sylvandb/gruvin9x/doc/spkr-install.jpg

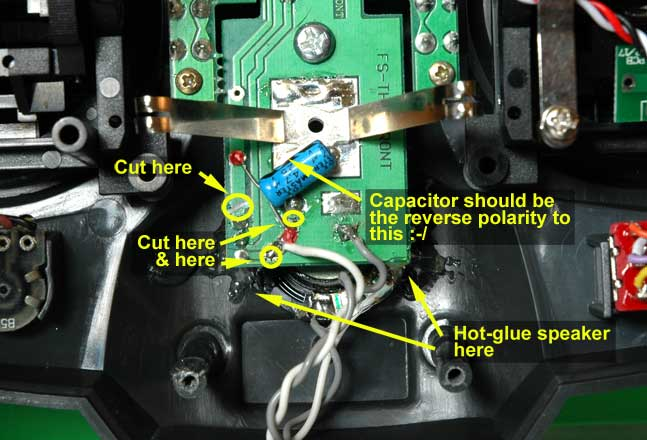
doc/spkr-install.jpg
