sylvandb/gruvin9x/hardware/pcb/README

Please see *-readme.txt files (to accommodate Windows users being able to open them more easily.)
