sylvandb/gruvin9x/hardware/pcb/gruvin9x-bom-ele14.xls

nz.element14.com 'next day delivery' cheapest pricing BOM
v4.2 Main and RTC/SD-card Boards |  |  |  | as at 2012-04-17
 |  |  |  | Farnell UK |  |  |  |  | Pricing |  | significant | Pricing for 10 units
Farnell Part No. | Price Ea. | MOQ | Qty | Manufacturer Name | Mfr Part No. | Description | Value | Footprint | Raw Amount | MOQ Amount | MOQ impact | Raw Amount | MOQ Amount
MAIN BOARD V4.1
1710190 (http://nz.element14.com/multicomp/mc0603n180k500ct/capacitor-ceramic-18pf-50v-c0g/dp/1710190) | 0.03 | 1 | 2 | Multicomp | MC0603N180K500CT | Capacitor ceramic | 18pF | SM0603 | 0.06 | 0.06 |  | 0.60 | 0.60
1709957 (http://nz.element14.com/multicomp/mc0603b104m250ct/capacitor-ceramic-0-1uf-25v-x7r/dp/1709957) | 0.03 | 1 | 51 | Multicomp | MC0603B104M250CT | Capacitor ceramic | 0.1uF 25V | SM0603 | 1.53 | 1.53 |  | 15.30 | 15.30
1710292 (http://nz.element14.com/multicomp/mc0603x105m160ct/capacitor-ceramic-1uf-16v-x5r-0603/dp/1710292) | 0.057 | 1 | 11 | Multicomp | MC0603X105M160CT | Capacitor ceramic | 1uF 16V | SM0603 | 0.63 | 0.63 |  | 6.27 | 6.27
1759445 (http://nz.element14.com/multicomp/mcca000564/mlcc-12065v-16v-10uf/dp/1759445) | 0.156 | 10 | 4 | Multicomp | MCCA000564 | Capacitor ceramic | 10uF 16V | SM1206 | 0.62 | 1.56 |  | 6.24 | 6.24
1844348 (http://nz.element14.com/tdk/c3225x5r1c226k/capacitor-ceramic-22uf-16v-x5r/dp/1844348) | 1.18 | 1 | 1 | TDK | C3225X5R1C226K | Capacitor ceramic | 22uF 16V | SM1210 | 1.18 | 1.18 |  | 11.80 | 11.80
1432351 (http://nz.element14.com/avx/taja476k006rnj/capacitor-case-a-47uf-6-3v/dp/1432351) | 0.396 | 1 | 4 | AVX | TAJA476K006RNJ | Capacitor tant | 47uF 6.3V | SM1206 | 1.58 | 1.58 |  | 15.84 | 15.84
1692453 (http://nz.element14.com/multicomp/mc0603wg00000t5e-tr/resistor-0603-0-063w-0r/dp/1692453) | 0.01 | 50 | 4 | Multicomp | MC0603WG00000T5E-TR | Resistor | 0R | SM0603 | 0.04 | 0.50 |  | 0.40 | 0.50
9331484 (http://nz.element14.com/multicomp/mc-0-063w-0603-1-68r/resistor-0603-68r/dp/9331484) | 0.01 | 50 | 2 | Multicomp | MC 0.063W 0603 1% 68R | Resistor | 68R | SM0603 | 0.02 | 0.50 |  | 0.20 | 0.50
9330364 (http://nz.element14.com/multicomp/mc-0-063w-0603-1-100r/resistor-0603-100r-0-063w-1/dp/9330364) | 0.01 | 50 | 2 | Multicomp | MC 0.063W 0603 1% 100R | Resistor | 100R | SM0603 | 0.02 | 0.50 |  | 0.20 | 0.50
9330755 (http://nz.element14.com/multicomp/mc-0-063w-0603-1-200r/resistor-0603-200r/dp/9330755) | 0.01 | 50 | 40 | Multicomp | MC 0.063W 0603 1% 200R | Resistor | 200R | SM0603 | 0.40 | 0.50 |  | 4.00 | 4.00
9330380 (http://nz.element14.com/multicomp/mc-0-063w-0603-1-1k/resistor-0603-1k-0-063-1/dp/9330380) | 0.01 | 50 | 5 | Multicomp | MC 0.063W 0603 1% 1K | Resistor | 1K | SM0603 | 0.05 | 0.50 |  | 0.50 | 0.50
9330607 (http://nz.element14.com/multicomp/mc-0-063w-0603-1-1k5/resistor-0603-1k5/dp/9330607) | 0.01 | 50 | 1 | Multicomp | MC 0.063W 0603 1% 1K5 | Resistor | 1K5 | SM0603 | 0.01 | 0.50 |  | 0.10 | 0.50
9330925 (http://nz.element14.com/multicomp/mc-0-063w-0603-1-2k7/resistor-0603-2k7/dp/9330925) | 0.01 | 50 | 1 | Multicomp | MC 0.063W 0603 1% 2K7 | Resistor | 2K7 | SM0603 | 0.01 | 0.50 |  | 0.10 | 0.50
9331301 (http://nz.element14.com/multicomp/mc-0-063w-0603-1-5k1/resistor-0603-5k1/dp/9331301) | 0.01 | 50 | 31 | Multicomp | MC 0.063W 0603 1% 5K1 | Resistor | 5K1 | SM0603 | 0.31 | 0.50 |  | 3.10 | 3.10
9330399 (http://nz.element14.com/multicomp/mc-0-063w-0603-1-10k/resistor-0603-10k-0-063w-1/dp/9330399) | 0.01 | 50 | 15 | Multicomp | MC 0.063W 0603 1% 10K | Resistor | 10K | SM0603 | 0.15 | 0.50 |  | 1.50 | 1.50
1170889 (http://nz.element14.com/multicomp/mc-0-063w-0603-1-10k2/resistor-0603-10k2/dp/1170889) | 0.01 | 50 | 3 | Multicomp | MC 0.063W 0603 1% 10K2 | Resistor | 10K2 | SM0603 | 0.03 | 0.50 |  | 0.30 | 0.50
9330402 (http://nz.element14.com/multicomp/mc-0-063w-0603-1-100k/resistor-0603-100k-0-063w-1/dp/9330402) | 0.01 | 50 | 5 | Multicomp | MC 0.063W 0603 1% 100K | Resistor | 100K | SM0603 | 0.05 | 0.50 |  | 0.50 | 0.50
9330623 (http://nz.element14.com/multicomp/mc-0-063w-0603-1-150k/resistor-0603-150k/dp/9330623) | 0.01 | 50 | 2 | Multicomp | MC 0.063W 0603 1% 150K | Resistor | 150K | SM0603 | 0.02 | 0.50 |  | 0.20 | 0.50
9330739 (http://nz.element14.com/multicomp/mc-0-063w-0603-1-180k/resistor-0603-180k/dp/9330739) | 0.01 | 50 | 1 | Multicomp | MC 0.063W 0603 1% 180K | Resistor | 180K | SM0603 | 0.01 | 0.50 |  | 0.10 | 0.50
1081244 (http://nz.element14.com/nxp/bc857/transistor-pnp-sot-23/dp/1081244?Ntt=1081244) | 0.091 | 10 | 1 | NXP | BC857C | Transistor | PNP gen. purp. switch | SOT-23 | 0.09 | 0.91 |  | 0.91 | 0.91
1081235 (http://nz.element14.com/nxp/bc847c/transistor-npn-sot-23-45v/dp/1081235) | 0.1 | 10 | 7 | NXP | BC847C | Transistor | NPN gen. purp. switch. | SOT-23 | 0.70 | 1.00 |  | 7.00 | 7.00
1456534 (http://nz.element14.com/bourns/cd0603-b00340/diode-schottky-30ma-45v-603/dp/1456534?Ntt=1456534) | 0.45 | 1 | 3 | BOURNS | CD0603-B00340 | Diode | Schottky 30mA | SM0603 | 1.35 | 1.35 |  | 13.50 | 13.50
1456535 (http://nz.element14.com/bourns/cd0603-s01575/diode-signal-150ma-100v-603/dp/1456535) | 0.149 | 1 | 1 | BOURNS | CD0603-S0180 | Diode | Silicone signal (150mA) | SM0603 | 0.15 | 0.15 |  | 1.49 | 1.49
8735654 (http://nz.element14.com/nxp/bzx384-c3v6/diode-zener-3-6v-5-sod-323/dp/8735654) | 0.174 | 10 | 2 | NXP | BZX384-C3V6 | Diode | Zener 3.6v | SOD323 | 0.35 | 1.74 | 1.39 | 3.48 | 3.48
8735735 (http://nz.element14.com/nxp/bzx384-c5v1/diode-zener-5-1v-5-sod-323/dp/8735735) | 0.174 | 10 | 1 | NXP | BZX384-C5V1 | Diode | Zener 5.1v | SOD523 | 0.17 | 1.74 | 1.57 | 1.74 | 1.74
9491856 (http://nz.element14.com/jst-japan-solderless-terminals/b2b-ph-k-s-lf-sn/header-top-entry-2way-2mm/dp/9491856) | 0.329 | 10 | 2 | JST | B2B-PH-K-S(LF)(SN) | JST PH series header | 2-way | SIL 2mm | 0.66 | 3.29 |  | 6.58 | 6.58
9492429 (http://nz.element14.com/jst-japan-solderless-terminals/b3b-ph-k-s-lf-sn/header-top-entry-3way/dp/9492429) | 0.435 | 10 | 4 | JST | B3B-PH-K-S(LF)(SN) | JST PH series header | 3-way | SIL 2mm | 1.74 | 4.35 |  | 17.40 | 17.40
9492437 (http://nz.element14.com/jst-japan-solderless-terminals/b4b-ph-k-s-lf-sn/header-top-entry-4way-2mm/dp/9492437) | 0.541 | 10 | 2 | JST | B4B-PH-K-S(LF)(SN) | JST PH series header | 4-way | SIL 2mm | 1.08 | 5.41 |  | 10.82 | 10.82
9492445 (http://nz.element14.com/jst-japan-solderless-terminals/b5b-ph-k-s-lf-sn/header-top-entry-5way/dp/9492445) | 0.764 | 10 | 2 | JST | B5B-PH-K-S(LF)(SN) | JST PH series header | 5-way | SIL 2mm | 1.53 | 7.64 |  | 15.28 | 15.28
9492453 (http://nz.element14.com/jst-japan-solderless-terminals/b6b-ph-k-s-lf-sn/header-top-entry-6way/dp/9492453) | 0.859 | 10 | 2 | JST | B6B-PH-K-S(LF)(SN) | JST PH series header | 6-way | SIL 2mm | 1.72 | 8.59 |  | 17.18 | 17.18
9492461 (http://nz.element14.com/jst-japan-solderless-terminals/b8b-ph-k-s-lf-sn/header-top-entry-8way/dp/9492461) | 1.09 | 10 | 1 | JST | B8B-PH-K-S(LF)(SN) | JST PH series header | 8-way | SIL 2mm | 1.09 | 10.90 |  | 10.90 | 10.90
9491872 (http://nz.element14.com/jst-japan-solderless-terminals/b9b-ph-k-s-lf-sn/header-top-entry-9way/dp/9491872) | 1.18 | 10 | 2 | JST | B9B-PH-K-S(LF)(SN) | JST PH series header | 9-way | SIL 2mm | 2.36 | 11.80 |  | 23.60 | 23.60
9492470 (http://nz.element14.com/jst-japan-solderless-terminals/b12b-ph-k-s-lf-sn/header-top-entry-12way/dp/9492470) | 0.56 | 10 | 1 | JST | B12B-PH-K-S(LF)(SN) | JST PH series header | 12-way | SIL 2mm | 0.56 | 5.60 |  | 5.60 | 5.60
3616186 (http://nz.element14.com/jst-japan-solderless-terminals/phr-2/housing-2way-2mm/dp/3616186?Ntt=3616186) | 0.101 | 1 | 2 | JST | PHR-2 | JST PH series housing | 2-way | SIL 2mm | 0.20 | 0.20 |  | 2.02 | 2.02
3616198 (http://nz.element14.com/jst-japan-solderless-terminals/phr-3/housing-3way-2mm/dp/3616198?Ntt=3616198) | 0.122 | 1 | 4 | JST | PHR-3 | JST PH series housing | 3-way | SIL 2mm | 0.49 | 0.49 |  | 4.88 | 4.88
3616204 (http://nz.element14.com/jst-japan-solderless-terminals/phr-4/housing-4way-2mm/dp/3616204?Ntt=3616204) | 0.122 | 1 | 2 | JST | PHR-4 | JST PH series housing | 4-way | SIL 2mm | 0.24 | 0.24 |  | 2.44 | 2.44
3617210 (http://nz.element14.com/jst-japan-solderless-terminals/bph-002t-p0-5s/contact-loose-piece-0-05-0-22mm/dp/3617210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) | 0.061 | 1 | 29 | JST | BPH-002T-P0.5S | Terminals (JST) | JST 28-24-AWG | N/A | 1.77 | 1.77 |  | 17.69 | 17.69
1509141 (http://nz.element14.com/molex/52435-3071/socket-zif-0-5mm-30way/dp/1509141?Ntt=1509141) | 4.84 | 1 | 1 | MOLEX | 52435-3071 | Connector | 30-way flat ZIF | Contacts on TOP | 4.84 | 4.84 |  | 48.40 | 48.40
3418510 (http://nz.element14.com/te-connectivity-amp/826632-5/header-2row-10way/dp/3418510) | 0.772 | 1 | 1 | AMP | 826632-5 2ROW 10WAY (Gold) | 5x2 + 3x2 Header (pins) | Split into a 2x3 and a 2x5 | 2.54mm male pins | 0.77 | 0.77 |  | 7.72 | 7.72
1463501 (http://nz.element14.com/taiyo-yuden/lb2012t100kr/wirewound-inductor-10uh-100ma-10/dp/1463501?Ntt=1463501) | 0.865 | 1 | 2 | TAIYO YUDEN | LB2012T100KR | Inductor/Choke | 10uH 60mA +/-20% | SM0805 | 1.73 | 1.73 |  | 17.30 | 17.30
1842216 (http://nz.element14.com/txc/9b-16-000maaj-b/xtal-16-000mhz-18pf-hc-49s/dp/1842216?Ntt=1842216) | 0.867 | 1 | 1 | TXC | 9B-16.000MAAJ-B | Crystal | 16MHz 18pF +/-50ppm | HC-49US | 0.87 | 0.87 |  | 8.67 | 8.67
1555985 (http://nz.element14.com/te-connectivity-alcoswitch/fsm8jh/switch-tactile-spno/dp/1555985?Ntt=FSM8JH) | 0.256 | 25 | 6 | TE Connectivity | FSM8JH | Push Switch NO/MC | TACT 6MM BLACK 160GF | 6x4mm pins 9.5mm H. | 1.54 | 6.40 | 4.86 | 15.36 | 15.36
3605772 (http://nz.element14.com/torex/xc6202p502pr/v-reg-ldo-5-0v-smd-6202-sot893/dp/3605772?Ntt=3605772) | 2.9 | 1 | 2 | TOREX | XC6202P502PR | 5 Volt Regulator 200mA | 5V LDO OUT / GND / IN | SOT-89-3 | 5.80 | 5.80 |  | 58.00 | 58.00
3605784 (http://nz.element14.com/torex/xc6203e332pr/v-reg-ldo-3-3v-smd-6203-sot893/dp/3605784?Ntt=3605784) | 2.9 | 1 | 1 | TOREX | XC6203E332PR | 3.3V Regulator 400mA | 3.3V LDO GND / IN / OUT | SOT-89-3L | 2.90 | 2.90 |  | 29.00 | 29.00
1235041 (http://nz.element14.com/texas-instruments/tps77601dg4/ic-v-reg-ldo-0-5a-adj-smd-soic8/dp/1235041?Ntt=1235041) | 5.38 | 1 | 1 | Texas Instruments | TPS77601DG4 | Variable regulator | With Enable | SOIC-8 | 5.38 | 5.38 |  | 53.80 | 53.80
1288330 (http://nz.element14.com/atmel/atmega2560-16au/8bit-mcu-256k-flash-5v-smd-2560/dp/1288330?Ntt=1288330) | 33.28 | 1 | 1 | Atmel | ATMEGA2560-16AU | IC (MCU) | ATmega2560 | TQFP 0.5mm | 33.28 | 33.28 |  | 332.80 | 332.80
1838961 (http://nz.element14.com/bourns/pec11-4220f-s0012/increm-encoder-dual-60rpm-12mm/dp/1838961?Ntt=1838961) | 2.9 | 1 | 2 | Bourns | PEC11-4220F-S0012 | Rotary encoder | Bi-Phase with switch (must have a detent-to-pulse ratio of 2:1 to work with the current code) | NO STOCK | 5.80 | 5.80 |  | 58.00 | 58.00
1282553 (http://nz.element14.com/mentor/505-613/knob-aluminium-setscrew/dp/1282553?Ntt=1282553) | 4.34 | 1 | 2 | Mentor | 505.613 | Knob | Splined with 6mm bore | 6 - 7 days delivery | 8.68 | 8.68 |  | 86.80 | 86.80
1858942 (http://nz.element14.com/vishay-siliconix/si2319cds-t1-ge3/mosfet-p-ch-40v-4-4a-diode-sot23/dp/1858942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) | 0.78 | 1 | 2 | Vishay/Siliconix | SI2319CDS-T1-GE3 | P-Channel MOSFET | Si2319DS | SOT-23 | 1.56 | 1.56 |  | 15.60 | 15.60
1234836 (http://nz.element14.com/texas-instruments/ref3012aidbztg4/ic-sm-volt-ref-1-25v/dp/1234836) | 4.32 | 1 | 1 | Texas Instruments | REF3012AIDBZTG4 | Voltage Reference | REF3012 | SOT-23 | 4.32 | 4.32 |  | 43.20 | 43.20
1596990 (http://nz.element14.com/littelfuse/1206l025yr/fuse-resettable-1206-16v-250ma/dp/1596990?Ntt=1596990) | 0.546 | 10 | 1 | Littlefuse | 1206L025YR | Fuse | 250mA | SM1206 | 0.55 | 5.46 | 4.91 | 5.46 | 5.46
 |  |  |  |  |  |  |  |  | 100.99 | 168.00 | 12.736 | 1009.87 | 1012.27
 |  |  |  |  |  |  |  |  |  |  |  |  | 101.23 | ea.
RTC/SD-card Board v4.1
1709957 (http://nz.element14.com/multicomp/mc0603b104m250ct/capacitor-ceramic-0-1uf-25v-x7r/dp/1709957) | 0.03 | 1 | 2 | Multicomp | MC0603B104M250CT | Capacitor ceramic | 0.1uF 25V | SM0603 | 0.06 | 0.06 |  | 0.60 | 0.60
9330380 (http://nz.element14.com/multicomp/mc-0-063w-0603-1-1k/resistor-0603-1k-0-063-1/dp/9330380) | 0.01 | 50 | 1 | Multicomp | MC 0.063W 0603 1% 1K | Resistor | 1K | SM0603 | 0.01 | 0.50 |  | 0.10 | 0.50
9331301 (http://nz.element14.com/multicomp/mc-0-063w-0603-1-5k1/resistor-0603-5k1/dp/9331301) | 0.01 | 50 | 4 | Multicomp | MC 0.063W 0603 1% 5K1 | Resistor | 5K1 | SM0603 | 0.04 | 0.50 |  | 0.40 | 0.50
9330399 (http://nz.element14.com/multicomp/mc-0-063w-0603-1-10k/resistor-0603-10k-0-063w-1/dp/9330399) | 0.01 | 50 | 5 | Multicomp | MC 0.063W 0603 1% 10K | Resistor | 10K | SM0603 | 0.05 | 0.50 |  | 0.50 | 0.50
1379714 (http://nz.element14.com/maxim-integrated-products/ds1338z-33/rtc-56b-nvram-i2c-1338-soic8/dp/1379714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) | 6.32 | 1 | 1 | Maxim | DS1338Z-33+ | RTC | DS1338-33 | 8-SOIC 3.90mm | 6.32 | 6.32 |  | 63.20 | 63.20
1278036 (http://nz.element14.com/epson-toyocom/fc-135-32-768khz-20ppm-12-5pf/crystal-sm-watch/dp/1278036?Ntt=1278036) | 4.06 | 1 | 1 | Epson Toyocom | FC-135 32.768KHZ | Xtal | 32.768KHz 12.5pf | 2-SMD 3.2x2.5mm | 4.06 | 4.06 |  | 40.60 | 40.60
3616241 (http://nz.element14.com/jst-japan-solderless-terminals/phr-8/housing-8way/dp/3616241?Ntt=3616241) | 0.202 | 1 | 1 | JST | PHR-8 | JST PH series housing | 8-way | SIL 2mm
3617210 (http://nz.element14.com/jst-japan-solderless-terminals/bph-002t-p0-5s/contact-loose-piece-0-05-0-22mm/dp/3617210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) | 0.061 | 1 | 8 | JST | BPH-002T-P0.5S | Terminals (JST) | JST 28-24-AWG | N/A | 0.49 | 0.49 |  | 4.88 | 4.88
1650693 (http://nz.element14.com/keystone/3002/battery-smd-retainer-20mm/dp/1650693?Ntt=1650693) | 1.54 | 1 | 1 | Keystone | 3002 | Battery Holder | Metal frame-only type | 20MM COIN CR2032 | 1.54 | 1.54 |  | 15.40 | 15.40
9186174 (http://nz.element14.com/multicomp/sdbmf-00915b0t2/pcb-socket-connector-9way/dp/9186174?Ntt=9186174) | 8.17 | 1 | 1 | Mutlicomp | SDBMF-00915B0T2 | SD Card Socket |  | SMD see datasheet | 8.17 | 8.17 |  | 81.70 | 81.70
1823479 (http://nz.element14.com/renata/cr-2032-mfr-1bl/cell-lithium-button-3v/dp/1823479?Ntt=1823479) | 1.93 | 1 | 1 | Renata | CR 2032 MFR (1BL) | Lithium Battery | 3V 20mm |  | 1.93 | 1.93 |  | 19.30 | 19.30
 |  |  |  |  |  |  |  |  | 22.67 | 24.07 |  | 226.68 | 227.18
The Atmega2560 is about US$11 ea. from DigiKey, who have a US$33 shipping fee. Better to use Digikey if ordering in quantity. The 6mm Knob is non-essential. Buy it locally or select alternate part from nz.element14.com catalogue. |  |  |  |  |  |  | 1833023 (http://nz.element14.com/abracon/abs09-32-768khz-t/crystal-32-768khz-12-5pf-smd/dp/1833023?Ntt=1833023) | $1.69 |  |  |  |  | 22.718 | ea.
 |  |  |  |  |  | NOTE: A cheaper Xtal exists: 1833023. But it's 4.1x1.5mm and wont quite fit. :-( However, the originally specified Xtal is available from Digikey at under $2.
NOTE: These parts go with Cam's UK version of the SD card PCB, because the DigiKey (Asia) versions are not available from element14 / Farnell. (By the way, Gruvin prefers the spring-loaded ejection, DigiKey socket.)
 |  |  |  |  |  |  |  |  | Pricing
Expensive but better(?) alternatives ... |  |  |  |  |  |  |  |  | Raw Amount | MOQ Amount
1248132 (http://nz.element14.com/te-connectivity-amp/826925-3/header-straight-2x3way/dp/1248132) | 0.95 | 10 | 1 | AMP | 826925-3 | Header 2ROW, 3WAY | ISP Header | 2.54mm 3x2 IDC header | 0.95 | 9.50
1022235 (http://nz.element14.com/harwin/m20-9980545/header-2row-5way/dp/1022235) | 2.01 | 10 | 2 | AMP | M20-9980545 | Header 2ROW, 5WAY | JTAG Header | 2.54mm 5x2 IDC header | 4.02 | 20.10
