sylvandb/gruvin9x/hardware/pcb/frsky_dsmx_caddy-bom-ele14.xls

nz.element14.com 'next day delivery' cheapest pricing BOM
Fr-Sky DSM2 TX Module Caddy Board v2.0 |  |  |  | as at 2012-10-29
nz.element14.com
ele14 Part No. | Price Ea. | MOQ | Qty | Manufacturer Name | Mfr Part No. | Description | Value | Footprint
1236598 (http://nz.element14.com/texas-instruments/ua78m05cdcyg3/v-reg-0-5a-5-0v-smd-sot-223-4/dp/1236598) | 0.74 | 1 | 1 | Texas Instruments | UA78L05ACPKG3 | 1A linear regulator | 5V | TO-223
