sylvandb/gruvin9x/hardware/gprog/gprog_v4.2_bom.xls

Sheet: nz.element14.com
GPROG v1.20 Bill of Materials |  | See second Worksheet for DigiKey USA version.
2012-04-17 (Gruvin)
 |  |  |  |  | nz.element14.com
Description | Value | Qty | Package |  | Part No. | Price ea. | MOQ | Amount
Capacitor (ceramic) | 18p | 2 | SM0603 | C3, C4 | 721992 (http://nz.element14.com/yageo-phycomp/cc0603jrnpo9bn180/capacitor-0603-18pf-50v/dp/721992) | 0.057 | 10 | 0.57
Capacitor (ceramic) | 0u1 | 2 | SM0603 | C1, C5 | 1362556 (http://nz.element14.com/yageo-phycomp/cc0603krx7r9bb104/capacitor-0603-100nf-50v-x7r/dp/1362556) | 0.051 | 10 | 0.51
Capacitor (tantalum) | 22u | 1 | SM1210 | C2 | 1862119 (http://nz.element14.com/avx/tajb226k016rnj/capacitor-tant-22uf-16v-2-3ohm/dp/1862119) | 0.939 | 1 | 0.94
Resistor (thick-film) | 27R | 2 | SM0603 | R1, R2 | 9330950 (http://nz.element14.com/multicomp/mc-0-063w-0603-1-27r/resistor-0603-27r/dp/9330950) | 0.01 | 50 | 0.50
Resistor (thick-film) | 47R | 2 | SM0603 | R5, R6 | 9332138 (http://nz.element14.com/multicomp/mc-0-063w-0603-5-47r/resistor-0603-47r/dp/9332138) | 0.01 | 50 | 0.50
Resistor (thick-film) | 1K | 2 | SM0603 | R4, R9 | 9330380 (http://nz.element14.com/multicomp/mc-0-063w-0603-1-1k/resistor-0603-1k-0-063-1/dp/9330380) | 0.01 | 50 | 0.50
Resistor (thick-film) | 3K9 | 1 | SM0603 | R3 | 9331140 (http://nz.element14.com/multicomp/mc-0-063w-0603-1-3k9/resistor-0603-3k9/dp/9331140) | 0.01 | 50 | 0.50
Resistor (thick-film) | 5K6 | 2 | SM0603 | R7, R8 | 9331352 (http://nz.element14.com/multicomp/mc-0-063w-0603-1-5k6/resistor-0603-5k6-1-0-063w/dp/9331352) | 0.01 | 50 | 0.50
LED | RED | 2 | SM1206 | D5 | 1318257 (http://nz.element14.com/kingbright/kpc-3216src-prv/led-algaas-smd-red/dp/1318257) | 0.133 | 10 | 1.33
LED | GREEN | 2 | SM1206 | D6 | 1318255 (http://nz.element14.com/kingbright/kpc-3216sgd/led-smd-1206-diffused-green/dp/1318255) | 0.212 | 10 | 2.12
Zenor Didoe 3.6V | DO-213AC (Glass) | 2 | SM1206 | D3, D4 | 8735450 (http://nz.element14.com/nxp/bzv55-c3v6/diode-zener-3-6v-5-sod-80/dp/8735450) | 0.061 | 5 | 0.30
Schottky Diode (fast recovery) | Sctky 30mA | 2 | SM0603 | D1, D2 | 1456534 (http://nz.element14.com/jsp/search/productdetail.jsp?sku=1456534) | 0.441 | 1 | 0.88
Schottky Diode | Sctky 500mA | 1 | SM1206 | D7 | 1863141 (http://nz.element14.com/taiwan-semiconductor/b0520lw/diode-rectif-20v-0-5a-sod123/dp/1863141) | 0.174 | 1 | 0.17
ATmega88P (20MHz) | ATMEGA88P-20AU | 1 | 32QFN | IC1 | 1636946 (http://nz.element14.com/atmel/atmega88p-20au/8-bit-mcu-8k-fla-2-7-5-5v-tqfp32/dp/1636946) | 7.98 | 1 | 7.98
4-way tri-state buffer | SN74HC125DR | 1 | 14-TSSOP (4.40mm) | U1 | 1607617 (http://nz.element14.com/fairchild-semiconductor/mm74hc125mtc/ic-sm-logic-74hc-buffer/dp/1607617) | 0.865 | 1 | 0.86
Cystal | 12MHz / 18pf | 1 | HC49/US | X1 | 7940142 (http://nz.element14.com/abracon/abl-12-000mhz-b2/crystal-12mhz-18pf-through-hole/dp/7940142) | 0.919 | 1 | 0.92
USB-B mini socket | USB-B mini | 1 | SMD | USB | 1125348 (http://nz.element14.com/molex/675031020/socket-usb-mini-b-smt-w-pegs/dp/1125348) | 2.88 | 1 | 2.88
Target ISP Header | 2.54mm hdr 3x1 | 2 | 2 x 3:1 is cheaper | P1 | 1513501 (http://nz.element14.com/molex/90147-1103/header-pcb-3way/dp/1513501) | 0.7 | 1 | 1.40
USB Header (male) | 2.54mm hdr 4x1 | 1 | Unshrouded | P2 | 9733469 (http://nz.element14.com/molex/90121-0764/header-right-angle-1row-4way/dp/9733469) | 0.464 | 2 | 0.93
 |  |  |  |  |  |  | TOTAL | 23.37
USB Board to Programmer Wiring Options ...
The cheap, easy way ...
eBay item 280777612850 "10pcs 4pin Arduino 30cm jumper wire for Shield or EQUIV" $4.50
This will get you 20 sockets with wires already attached! Just cut the cables in half.
The hard, expensive way ....
Crimp Housing (4-way) | 2.54mm hdr 4x1 | 1 | Plastic |  | 1822585 (http://nz.element14.com/te-connectivity-amp/102241-2/wire-board-connector-receptacle/dp/1822585) | 1.06 | 1 | 1.06
Crimp sockets | 24-28AWG | 4 | N/A |  | 1823218 (http://nz.element14.com/te-connectivity-amp/87756-7/crimp-socket-26-22awg/dp/1823218) | 0.304 | 10 | 3.04
Optional ...
Hook-up Wire 26AWG x 25ft | Black | 1 | Reel |  | 1662108 (http://nz.element14.com/nte-electronics/wh26-00-25/hook-up-wire-25ft-26awg-cu-black/dp/1662108) | 8.92 | 1 | 8.92
Hook-up Wire 26AWG x 25ft | Green | 1 | Reel |  | 1662115 (http://nz.element14.com/nte-electronics/wh26-05-25/hook-up-wire-25ft-26awg-cu-green/dp/1662115) | 9.35 | 1 | 9.35
Hook-up Wire 26AWG x 25ft | Red | 1 | Reel |  | 1662110 (http://nz.element14.com/nte-electronics/wh26-02-25/hook-up-wire-25ft-26awg-cu-red/dp/1662110) | 8.92 | 1 | 8.92
Hook-up Wire 26AWG x 25ft | Yellow | 1 | Reel |  | 1662113 (http://nz.element14.com/nte-electronics/wh26-04-25/hook-up-wire-25ft-26awg-cu-yellow/dp/1662113) | 9.35 | 1 | 9.35
Or ...
Ribon Cable - 4-way / 4 colour | (per metre) | 1 |  |  | 150431 (http://nz.element14.com/pro-power/05006684/ribbon-cable-4way-per-m/dp/150431) | 1.32 | 5 | 6.60

Sheet: DigiKey USA
GPROG v1.00 Bill of Materials -- DigiKey USA Version
2012-09-13 (Original by JWB. Updated by Gruvin.)
Main Board
DigiKey Part No. | Manufacturer Name | Mfr Part No. | Description | Value | Package | Qty
609-3582-ND (http://search.digikey.com/scripts/DkSearch/dksus.dll?Detail&name=609-3582-ND) | FCI (http://digikey.com/Suppliers/nz/FCI.page?lang=EN) | 68002-303LF | 2x3 fPCB | P1 ISP out | 2.54mm female pins | 1
609-3312-ND (http://search.digikey.com/scripts/DkSearch/dksus.dll?Detail&name=609-3312-ND) | FCI (http://digikey.com/Suppliers/nz/FCI.page?lang=EN) | 68002-104HLF | 1 x 4pin | P2 USB in | 2.54mm male pins | 1
ATMEGA88PA-AU-ND (http://search.digikey.com/scripts/DkSearch/dksus.dll?Detail&name=ATMEGA88PA-AU-ND) | Atmel (http://digikey.com/Suppliers/us/Atmel.page?lang=EN) | ATmega88PA | Micro |  | TQFP | 1
296-26462-1-ND (http://www.digikey.com/product-detail/en/SN74HC126PWR/296-26462-1-ND/2255010) | Texas Instruments (http://digikey.com/Suppliers/us/Texas-Instruments.page?lang=EN) | SN74HC126PWR | Buffer driver non-invert | U1 | TSSOP | 1
641-1006-1-ND (http://search.digikey.com/scripts/DkSearch/dksus.dll?Detail&name=641-1006-1-ND) | Comchip Technology (http://digikey.com/Suppliers/us/Comchip-Technology.page?lang=EN) | CDBU00340 | Diode | Schottky | SM0603 | 2
BZV55C3V6-TPMSCT-ND (http://search.digikey.com/scripts/DkSearch/dksus.dll?Detail&name=BZV55C3V6-TPMSCT-ND) | Micro Commercial Co (http://digikey.com/Suppliers/us/Micro-Commercial-Components.page?lang=EN) | BZV55C3V6-TP | 3.6vz | Zener Diode | DO-213AC (Glass) | 2
P27GCT-ND (http://search.digikey.com/scripts/DkSearch/dksus.dll?Detail&name=P27GCT-ND) | Panasonic - ECG (http://digikey.com/Suppliers/us/Panasonic-Industrial-Products.page?lang=EN) | ERJ-3GEYJ270V | Resistor | 27R | SM0603 | 2
P47GCT-ND (http://search.digikey.com/scripts/DkSearch/dksus.dll?Detail&name=P47GCT-ND) | Panasonic - ECG (http://digikey.com/Suppliers/us/Panasonic-Industrial-Products.page?lang=EN) | ERJ-3GEYJ470V | Resistor | 47R | SM0603 | 2
P1.0KGCT-ND (http://search.digikey.com/scripts/DkSearch/dksus.dll?Detail&name=P1.0KGCT-ND) | Panasonic - ECG (http://digikey.com/Suppliers/us/Panasonic-Industrial-Products.page?lang=EN) | ERJ-3GEYJ102V | Resistor | 1K0 | SM0603 | 2
P3.9KGCT-ND (http://search.digikey.com/scripts/DkSearch/dksus.dll?Detail&name=P3.9KGCT-ND) | Panasonic - ECG (http://digikey.com/Suppliers/us/Panasonic-Industrial-Products.page?lang=EN) | ERJ-3GEYJ392V | Resistor | 3K9 | SM0603 | 1
P5.6KGCT-ND (http://search.digikey.com/scripts/DkSearch/dksus.dll?Detail&name=P5.6KGCT-ND) | Panasonic - ECG (http://digikey.com/Suppliers/us/Panasonic-Industrial-Products.page?lang=EN) | ERJ-3GEYJ562V | Resistor | 5K6 | SM0603 | 2
445-1272-1-ND (http://search.digikey.com/scripts/DkSearch/dksus.dll?Detail&name=445-1272-1-ND) | TDK Corporation (http://digikey.com/Suppliers/us/TDK.page?lang=EN) | C1608C0G1H180J | Capacitor ceramic | 18pF | SM0603 | 2
445-5122-1-ND (http://search.digikey.com/scripts/DkSearch/dksus.dll?Detail&name=445-5122-1-ND) | TDK Corporation (http://digikey.com/Suppliers/us/TDK.page?lang=EN) | C1608X7R1C104M | Capacitor ceramic | 0.1uF 16V | SM0603 | 2
478-1682-1-ND (http://search.digikey.com/scripts/DkSearch/dksus.dll?Detail&name=478-1682-1-ND) | AVX Corporation (http://digikey.com/Suppliers/us/AVX.page?lang=EN) | TAJB226K016RNJ | Capacitor tant | 22uF 16V | SM1210 | 1
XC1744-ND (http://search.digikey.com/scripts/DkSearch/dksus.dll?Detail&name=XC1744-ND) | ECS Inc (http://digikey.com/Suppliers/us/ECS.page?lang=EN) | ECS-120-18-23A-TR | Crystal | 12MHz 18pF +/-50ppm | HC-49S | 1
DFLS140DICT-ND (http://search.digikey.com/scripts/DkSearch/dksus.dll?Detail&name=DFLS140DICT-ND) | Diodes Inc (http://digikey.com/Suppliers/us/Diodes.page?lang=EN) | DFLS140-7 | Diode | Schottky | DI123 | 1
160-1405-1-ND (http://search.digikey.com/scripts/DkSearch/dksus.dll?Detail&name=160-1405-1-ND) | Lite-On Inc (http://digikey.com/Suppliers/us/Lite-On.page?lang=EN) | LTST-C150KRKT | Diode | LED Red | SM1206 | 1
160-1404-1-ND (http://search.digikey.com/scripts/DkSearch/dksus.dll?Detail&name=160-1404-1-ND) | Lite-On Inc (http://digikey.com/Suppliers/us/Lite-On.page?lang=EN) | LTST-C150KGKT | Diode | LED Green | SM1206 | 1
USB Socket Board
DigiKey Part No. | Manufacturer Name | Mfr Part No. | Description | Value | Package | Qty
670-1190-1-ND (http://search.digikey.com/scripts/DkSearch/dksus.dll?Detail&name=670-1190-1-ND) | JAE Electronics (http://digikey.com/Suppliers/us/JAE-Electronics.page?lang=EN) | DX2R005HN2E700 | miniUSB | miniUSB comm | miniUSB | 1
609-2339-ND (http://search.digikey.com/scripts/DkSearch/dksus.dll?Detail&name=609-2339-ND) | FCI (http://digikey.com/Suppliers/us/FCI.page?lang=EN) | 65039-033LF | 1x4 female | USB conn (+cable,pins) | 2.54mm female conn | 1
609-4536-1-ND (http://search.digikey.com/scripts/DkSearch/dksus.dll?Detail&name=609-4536-1-ND) | FCI (http://digikey.com/Suppliers/us/FCI.page?lang=EN) | 75231-013LF | USB connector pin | USB conn pin | 2.54mm female pins | 4
 |  |  |  |  | Total Part Count | 32
Alternate Items
DigiKey Part No. | Manufacturer Name | Mfr Part No. | Description | Value | Package | Qty
EDZTE613.6BCT-ND (http://search.digikey.com/scripts/DkSearch/dksus.dll?Detail&name=EDZTE613.6BCT-ND) | Rohm Semiconductor (http://digikey.com/Suppliers/us/ROHM.page?lang=EN) | EDZTE613.6B | 3.6vz | Zener Diode |  | 2
609-3253-ND (http://search.digikey.com/scripts/DkSearch/dksus.dll?Detail&name=609-3253-ND) | FCI (http://digikey.com/Suppliers/nz/FCI.page?lang=EN) | 68002-120LF | 1x20pin, 2x3 (optional) | P3 ISP in | 2.54mm male pins | 1
