sylvandb/gruvin9x/hardware/pcb/sdcard-bom.xls

SD Card Board | 2011-08-15
v4.2 NZ / DigiKey version
Digi-Key Part No. | MOQ | Qty | Manufacturer Name | Mfr Part No. | Description | Value | Footprint
445-5122-1-ND (http://search.digikey.com/scripts/DkSearch/dksus.dll?Detail&name=445-5122-1-ND) |  | 2 | TDK Corporation (http://digikey.com/Suppliers/us/TDK.page?lang=EN) | C1608X7R1C104M | Capacitor | 0.1uF 16v | SM0603
P1.0KGCT-ND (http://search.digikey.com/scripts/DkSearch/dksus.dll?Detail&name=P1.0KGCT-ND) |  | 1 | Panasonic - ECG (http://digikey.com/Suppliers/us/Panasonic-Industrial-Products.page?lang=EN) | ERJ-3GEYJ103V | Resistor | 1K | SM0603
P5.1KGCT-ND (http://search.digikey.com/scripts/DkSearch/dksus.dll?Detail&name=P5.1KGCT-ND) |  | 4 | Panasonic - ECG (http://digikey.com/Suppliers/us/Panasonic-Industrial-Products.page?lang=EN) | ERJ-3GEYJ512V | Resistor | 5K1 | SM0603
P10KGCT-ND (http://search.digikey.com/scripts/DkSearch/dksus.dll?Detail&name=P10KGCT-ND) |  | 5 | Panasonic - ECG (http://digikey.com/Suppliers/us/Panasonic-Industrial-Products.page?lang=EN) | ERJ-3GEYJ103V | Resistor | 10K | SM0603
DS1338Z-33+-ND (http://search.digikey.com/scripts/DkSearch/dksus.dll?Detail&name=DS1338Z-33%2B-ND) |  | 1 | Maxim Integrated Products (http://digikey.com/Suppliers/us/Maxim.page?lang=EN) | DS1338Z-33+ | RTC | DS1338-33 | 8-SOIC 3.90mm
300-8340-1-ND (http://www.digikey.com/product-detail/en/CMR200T-32.768KDZF-UT/300-8340-1-ND/862984) | 1 | 1 | Citizen Finetech Miyota (http://digikey.com/Suppliers/us/Citizen.page?lang=EN) | CMR200T-32.768KDZF-UT | Xtal | 32.768KHz 12.5pf | CMR200T
BAT-HLD-001-ND (http://search.digikey.com/scripts/DkSearch/dksus.dll?Detail&name=BAT-HLD-001-ND) |  | 1 | Linx Technologies Inc (http://digikey.com/Suppliers/nz/Linx-Technologies.page?lang=EN) | BAT-HLD-001 | Battery Holder | frame-only type | 20MM COIN CR2032
609-3956-1-ND (http://search.digikey.com/scripts/DkSearch/dksus.dll?Detail&name=609-3956-1-ND) |  | 1 | FCI (http://digikey.com/Suppliers/nz/FCI.page?lang=EN) | 10067847-001RLF | SD Card Socket |  | SMD see datasheet
P189-ND (http://search.digikey.com/scripts/DkSearch/dksus.dll?Detail&name=P189-ND) |  | 1 | Panasonic - BSG (http://digikey.com/Suppliers/nz/Panasonic-Industrial-Products.page?lang=EN) | CR2032 | Lithium Battery | 3V 20mm
TThese part numbers are for sdcard.brd only |  |  | The reason for the two designs is we couldn't find a UK source for the parts highlighted here.
Other parts are common to both designs. |  |  | The NZ version was also later updated to use a cheaper, barrel type crystal.
\ |  |  | The two designs share identical schematic. It's only the PCB layout that differs.
Xtalk also available from element14 ...
nz.element14 Part No. |  |  | Manufacturer Name | Mfr Part No.
1078958 (http://nz.element14.com/citizen-america/cmr200t32-768kdzf-ut/crystal-32-768khz-12-5pf-smd/dp/1078958) | 1 | 1 | Citizen America | CMR200T32.768KDZF-UT
