sylvandb/gruvin9x/hardware/pcb/sdcard-uk-bom.xls

SD Card Board | 2012-08-15
v4.2 UK / Farnel version
Farnell Part No. | MOQ | Qty | Manufacturer Name | Mfr Part No. | Description | Value | Footprint
1740612 (http://uk.farnell.com/avx/0603yc104jat2a/capacitor-mlcc-0603-16v-100nf/dp/1740612) | 10 | 2 | AVX | 0603YC104JAT2A | Capacitor | 0.1uF 16v | SM0603
1469740 (http://uk.farnell.com/vishay-draloric/crcw06031k00fkea/resistor-0603-1kr-1-0-1w/dp/1469740) | 50 | 1 | VISHAY DRALORIC | CRCW06031K00FKEA | Resistor | 1K | SM0603
1469819 (http://uk.farnell.com/vishay-draloric/crcw06035k10fkea/resistor-0603-5-1kr-1/dp/1469819) | 50 | 4 | VISHAY DRALORIC | CRCW06035K10FKEA | Resistor | 5K1 | SM0603
1469749 (http://uk.farnell.com/vishay-draloric/crcw060310k0jnea/resistor-10kr-0-1w-5/dp/1469749) | 50 | 5 | VISHAY DRALORIC | CRCW060310K0JNEA | Resistor | 10K | SM0603
1379714 (http://uk.farnell.com/maxim-integrated-products/ds1338z-33/rtc-56b-nvram-i2c-1338-soic8/dp/1379714) | 1 | 1 | Maxim | DS1338Z-33+ | RTC | DS1338-33 | 8-SOIC 3.90mm
1278036 (http://uk.farnell.com/epson-toyocom/fc-135-32-768khz-20ppm-12-5pf/crystal-sm-watch/dp/1278036) | 1 | 1 | Epson Toyocom | FC-135 32.768KHZ | Xtal | 32.768KHz 12.5pf | SMD-2
1650693 (http://uk.farnell.com/jsp/search/productdetail.jsp?sku=1650693) | 1 | 1 | Keystone | 3002 | Battery Holder | Metal frame-only type | 20MM COIN CR2032
9186174 (http://uk.farnell.com/jsp/search/productdetail.jsp?sku=9186174) | 1 | 1 | Mutlicomp | SDBMF-00915B0T2 | SD Card Socket |  | SMD see datasheet
1823479 (http://uk.farnell.com/renata/cr-2032-mfr-1bl/cell-lithium-button-3v/dp/1823479) | 1 | 1 | Renata | CR 2032 MFR (1BL) | Lithium Battery | 3V 20mm
These part numbers are for sdcard_uk.brd only |  |  | The reason for the two designs is we couldn't find a UK source for the parts highlighted here.
Other parts are common to both designs. |  |  | The NZ version was also later updated to use a cheaper barrel type crystal.
 |  |  | The two designs share identical schematic. It's only the PCB layout that differs.
