sylvandb/gruvin9x/hardware/pcb/g9x_rx_mpx-bom.xls

RX MPX Baord | V1.0
 |  |  | Digi-Key |  |  |  |  | Farnell UK
Digi-Key Part No. | MOQ | Qty | Manufacturer Name | Mfr Part No. | Farnell Part No. | MOQ | Qty | Manufacturer Name | Mfr Part No. | Description | Value | Footprint
445-5122-1-ND (http://search.digikey.com/scripts/DkSearch/dksus.dll?Detail&name=445-5122-1-ND) | 1 | 6 | TDK Corporation (http://digikey.com/Suppliers/us/TDK.page?lang=EN) | C1608X7R1C104M | 1740612 (http://uk.farnell.com/avx/0603yc104jat2a/capacitor-mlcc-0603-16v-100nf/dp/1740612) | 10 | 6 | AVX | 0603YC104JAT2A | Capacitor ceramic | 0.1uF 16V | SM0603
445-5156-1-ND (http://search.digikey.com/scripts/DkSearch/dksus.dll?Detail&name=445-5156-1-ND) | 1 | 1 | TDK Corporation (http://digikey.com/Suppliers/us/TDK.page?lang=EN) | C1608X5R1C105M | 1828801 (http://uk.farnell.com/murata/grm188r61c105ka93d/capacitor-0603-x5r-16v-1uf/dp/1828801) | 10 | 1 | MURATA | GRM188R61C105KA93D | Capacitor ceramic | 1uF 16V | SM0603
587-2253-1-ND (http://search.digikey.com/scripts/DkSearch/dksus.dll?Detail&name=587-2253-1-ND) | 1 | 1 | Taiyo Yuden (http://digikey.com/Suppliers/us/Taiyo-Yuden.page?lang=EN) | EMK316BJ106ML-T | 1463365 (http://uk.farnell.com/kemet/c1206c106k4pac-tu/capacitor-1206-10uf-16v-x5r/dp/1463365) | 1 | 1 | KEMET | C1206C106K4PAC-TU | Capacitor ceramic | 10uF 16V | SM1206
587-1348-1-ND (http://search.digikey.com/scripts/DkSearch/dksus.dll?Detail&name=587-1348-1-ND) | 1 | 1 | Taiyo Yuden (http://digikey.com/Suppliers/us/Taiyo-Yuden.page?lang=EN) | JMK316BJ476ML-T | 1658960 (http://uk.farnell.com/avx/tpsa476k006r0800/capacitor-case-a-47-uf-6-3v/dp/1658960) | 1 | 1 | AVX | TPSA476K006R0800 | Capacitor tant | 47uF 6.3V | SM1206
P200GCT-ND (http://search.digikey.com/scripts/DkSearch/dksus.dll?Detail&name=P200GCT-ND) | 1 | 9 | Panasonic - ECG (http://digikey.com/Suppliers/us/Panasonic-Industrial-Products.page?lang=EN) | ERJ-3GEYJ221V | 1469777 (http://uk.farnell.com/vishay-draloric/crcw0603200rfkea/resistor-0603-200r-1/dp/1469777) | 50 | 9 | VISHAY DRALORIC | CRCW0603200RFKEA | Resistor | 200R | SM0603
P1.0KGCT-ND (http://search.digikey.com/scripts/DkSearch/dksus.dll?Detail&name=P1.0KGCT-ND) | 1 | 1 | Panasonic - ECG (http://digikey.com/Suppliers/us/Panasonic-Industrial-Products.page?lang=EN) | ERJ-3GEYJ103V | 1469740 (http://uk.farnell.com/vishay-draloric/crcw06031k00fkea/resistor-0603-1kr-1-0-1w/dp/1469740) | 50 | 1 | VISHAY DRALORIC | CRCW06031K00FKEA | Resistor | 1K | SM0603
P5.1KGCT-ND (http://search.digikey.com/scripts/DkSearch/dksus.dll?Detail&name=P5.1KGCT-ND) | 1 | 1 | Panasonic - ECG (http://digikey.com/Suppliers/us/Panasonic-Industrial-Products.page?lang=EN) | ERJ-3GEYJ512V | 1469819 (http://uk.farnell.com/vishay-draloric/crcw06035k10fkea/resistor-0603-5-1kr-1/dp/1469819) | 50 | 1 | VISHAY DRALORIC | CRCW06035K10FKEA | Resistor | 5K1 | SM0603
P10KGCT-ND (http://search.digikey.com/scripts/DkSearch/dksus.dll?Detail&name=P10KGCT-ND) | 1 | 1 | Panasonic - ECG (http://digikey.com/Suppliers/us/Panasonic-Industrial-Products.page?lang=EN) | ERJ-3GEYJ103V | 1469748 (http://uk.farnell.com/vishay-draloric/crcw060310k0fkea/resistor-0603-10kr-1-0-1w/dp/1469748) | 50 | 1 | VISHAY DRALORIC | CRCW060310K0FKEA | Resistor | 10K | SM0603
751-1129-ND (http://www.digikey.com/product-detail/en/TLHR4405/751-1129-ND/1681264) | 1 | 1 | Vishay Semiconductors (http://digikey.com/Suppliers/us/Vishay-Semiconductors.page?lang=EN) | TLHR4405 | 2001642 (http://uk.farnell.com/kingbright/l-1334srt/reflector-led-3mm-hyper-red/dp/2001642) | 5 | 1 | KINGBRIGHT | L-1334SRT | LED | Red 3mm | 100mil 2pin
MF-MSMF250/16-2CT-ND (http://www.digikey.com/product-detail/en/MF-MSMF250%2F16-2/MF-MSMF250%2F16-2CT-ND/662851) |  | 2 | Bourns Inc. (http://digikey.com/Suppliers/us/Bourns.page?lang=EN) | MF-MSMF250/16-2 | 1652174 (http://uk.farnell.com/bourns/mf-msmf250-16-2/multifuse-smd-1812-2-5a-16v/dp/1652174) | 5 | 2 | Bournes | MF-MSMF250/16-2 | Fuse | 2.5A 16v | 1812 BIGGER THAN PCB :( @ 1206
ATMEGA328-AU-ND (http://www.digikey.com/product-detail/en/ATMEGA328-AU/ATMEGA328-AU-ND/2271029) | 1 | 1 | Atmel (http://digikey.com/Suppliers/us/Atmel.page?lang=EN) | ATMEGA328-AU | 1972086 (http://uk.farnell.com/atmel/atmega328-au/mcu-8bit-avr-32k-flash-32tqfp/dp/1972086) | 1 | 1 | Atmel | ATMEGA328-AU | IC (MCU) | ATMega328 | TQFP 32 0.8mm
A32705-40-ND (http://www.digikey.com/product-detail/en/9-103323-0/A32705-40-ND/1044432) | 1 | 1 | AMPMODU Mod II (http://www.digikey.com/product-search/en?FV=ffec0eea) | 9-103323-0 | 1098476 (http://uk.farnell.com/te-connectivity-amp/4-103323-1/header-right-angle-1row-40way/dp/1098476?Ntt=4-103323-1) | 1 x 40pin | 1 | TE CONNECTIVITY / AMP | 4-103323-1 | Pin Header | Single row 90 degree | 2.54mm male pins
A34279-40-ND (http://www.digikey.com/product-detail/en/9-103324-0/A34279-40-ND/1126657) | 1 | 1 | AMPMODU Mod II (http://www.digikey.com/product-search/en?FV=ffec0eea) | 9-103324-0 | 1056023 (http://uk.farnell.com/te-connectivity-amp/9-103324-0/header-right-angle-2row-40-40way/dp/1056023) | 1 x 40pin | 1 | TE CONNECTIVITY / AMP | 9-103324-0 | Pin Header | Double row 90 degree | 2.54mm male pins
? | ? | 8 columns | ? | ? | 000539 (http://www.coolcomponents.co.uk/catalog/header-right-angle-rows-pinmale-p-539.html) | 1 x 40pin | 1 | Unknown | Unknown | Pin Header | Triple row 90 degree | 2.54mm male pins
EG4912-ND (http://www.digikey.com/product-detail/en/200USP1T1A1M6RE/EG4912-ND/2498448) | 1 | 2 | E-Switch (http://digikey.com/Suppliers/us/E-Switch.page?lang=EN) | 200USP1T1A1M6RE | 9473017 (http://uk.farnell.com/multicomp/2ms1t2b2m6re/switch-pcb-spdt-horiz/dp/9473017?Ntt=9473017) | 1 | 2 | Multicomp | 2MS1T2B2M6RE | Switch | SPDT 90 degree toggle
CT1952MST-ND (http://www.digikey.com/product-detail/en/195-2MST/CT1952MST-ND/92985) | 1 | 1 | CTS Electrocomponents (http://digikey.com/Suppliers/us/CTS-Corporation-Electrocomponents.page?lang=EN) | 195-2MST | 1255233 (http://uk.farnell.com/multicomp/mcdp02/switch-dil-2way/dp/1255233) | 1 | 1 | Multicomp | MCDP02 | Dip Switch | 2 way | 300mil 4pin DIL
NJM78L05UA-ND (http://search.digikey.com/us/en/products/NJM78L05UA/NJM78L05UA-ND/805773) | 1 | 1 | NJR (http://digikey.com/Suppliers/us/NJR-JRC.page?lang=EN) | NJM78L05UA | 3605772 (http://uk.farnell.com/torex/xc6202p502pr/v-reg-ldo-5-0v-smd-6202-sot893/dp/3605772) | 1 | 1 | TOREX | XC6202P502PR | 5 Volt Regulator | OUT / GND / IN | SOT-89
A100207-ND (http://www.digikey.com/product-detail/en/1-390261-5/A100207-ND/1152553) | 1 | 1 | TE Connectivity (http://digikey.com/Suppliers/us/Tyco-Electronics-Amp.page?lang=EN) | 1-390261-5 | 1101348 (http://uk.farnell.com/te-connectivity-amp/1-390261-5/socket-ic-dil-0-3-18way/dp/1101348) | 5 | 1 | TE CONNECTIVITY / AMP | 1-390261-5 | IC Socket | 18pin | 300mil 18pin DIL
ULN2803APG(ONHZN-ND (http://www.digikey.com/product-detail/en/ULN2803APG%28O,N,HZN/ULN2803APG%28ONHZN-ND/856431) | 1 | 1 | Toshiba (http://digikey.com/Suppliers/us/Toshiba-America-Electronic-Components.page?lang=EN) | ULN2803APG(O,N,HZN | 1652422 (http://uk.farnell.com/texas-instruments/uln2803an/darlington-transistor-array/dp/1652422) | 1 | 1 | TEXAS INSTRUMENTS | ULN2803AN | Octal transistor array | ULN2803 | 300mil 18pin DIL
296-25940-1-ND (http://www.digikey.com/product-detail/en/CD4017BM96/296-25940-1-ND/2254803) | 1 | 1 | Texas Instruments (http://digikey.com/Suppliers/us/Texas-Instruments.page?lang=EN) | CD4017BM96 | 1741256 (http://uk.farnell.com/texas-instruments/cd4017bm/logic-10-out-decade-counter-16soic/dp/1741256) | 1 | 1 | TEXAS INSTRUMENTS | CD4017BM | Decade Counter | 4017 | 16SOIC
