sylvandb/gruvin9x/hardware/pcb/production-sdnz/sdcard-bom.xls

RTC/SD-card Board v4.2 Bill of Materials
Date | 2011-08-15
Author | Gruvin
Designator | Package | Qty | Designation | Supplier | Supplier Ref | Manufacturer | Manu. Part No. | Description | Value
BT1 | BAT_HLD_2032 | 1 | CR2032 | Digikey | BAT-HLD-001-ND (http://search.digikey.com/scripts/DkSearch/dksus.dll?Detail&name=BAT-HLD-001-ND) | Linx Technologies Inc (http://digikey.com/Suppliers/nz/Linx-Technologies.page?lang=EN) | BAT-HLD-001 | Battery Holder
C1,C2 | SM0603 | 2 | 0u1 | Digikey | 445-5122-1-ND (http://search.digikey.com/scripts/DkSearch/dksus.dll?Detail&name=445-5122-1-ND) | TDK Corporation (http://digikey.com/Suppliers/us/TDK.page?lang=EN) | C1608X7R1C104M | Capacitor | 0.1uF 16v
P1 | SDCARD_SKT | 1 | SDC_MMC_SOCKET | Digikey | 609-3956-1-ND (http://search.digikey.com/scripts/DkSearch/dksus.dll?Detail&name=609-3956-1-ND) | FCI (http://digikey.com/Suppliers/nz/FCI.page?lang=EN) | 10067847-001RLF | SD Card Socket
P2 | CONN_2MM_8x1 | 0 | CONN_8 | N/A | N/A | N/A | N/A | Not installed
R4,R3,R2,R1,R5 | SM0603 | 5 | 10K | Digikey | P10KGCT-ND (http://search.digikey.com/scripts/DkSearch/dksus.dll?Detail&name=P10KGCT-ND) | Panasonic - ECG (http://digikey.com/Suppliers/us/Panasonic-Industrial-Products.page?lang=EN) | ERJ-3GEYJ103V | Resistor | 10K
R8 | SM0603 | 1 | 1K | Digikey | P1.0KGCT-ND (http://search.digikey.com/scripts/DkSearch/dksus.dll?Detail&name=P1.0KGCT-ND) | Panasonic - ECG (http://digikey.com/Suppliers/us/Panasonic-Industrial-Products.page?lang=EN) | ERJ-3GEYJ103V | Resistor | 1K
R9,R7,R6,R10 | SM0603 | 4 | 5K1 | Digikey | P5.1KGCT-ND (http://search.digikey.com/scripts/DkSearch/dksus.dll?Detail&name=P5.1KGCT-ND) | Panasonic - ECG (http://digikey.com/Suppliers/us/Panasonic-Industrial-Products.page?lang=EN) | ERJ-3GEYJ512V | Resistor | 5K1
U1 | SO8E | 1 | DS1338-33 | Digikey | DS1338Z-33+-ND (http://search.digikey.com/scripts/DkSearch/dksus.dll?Detail&name=DS1338Z-33%2B-ND) | Maxim Integrated Products (http://digikey.com/Suppliers/us/Maxim.page?lang=EN) | DS1338Z-33+ | RTC
X1 | CMR200T | 1 | 32768 | Digikey | 300-8340-1-ND (http://www.digikey.com/product-detail/en/CMR200T-32.768KDZF-UT/300-8340-1-ND/862984) | Citizen Finetech Miyota (http://digikey.com/Suppliers/us/Citizen.page?lang=EN) | CMR200T-32.768KDZF-UT | Xtal | 32.768KHz 12.5pf
Loose parts to supply for client assembly / installation
Designator | Package | Qty | Designation | Supplier | Supplier Ref | Manufacturer | Manu. Part No. | Description | Value
Battery |  |  |  | Digikey | P189-ND (http://search.digikey.com/scripts/DkSearch/dksus.dll?Detail&name=P189-ND) | Panasonic - BSG (http://digikey.com/Suppliers/nz/Panasonic-Industrial-Products.page?lang=EN) | CR2032 | Lithium Battery | 3V 20mm
