sylvandb/gruvin9x/hardware/pcb/production/gruvin9x-bom-cn.xls

 | gruvin9x v4.2d Bill of Materials
 | Designator | Designation | Quantity | Package | Comments | DigiKey Part
 | C1,C11 | 10u 16V | 2 | SM1206_POL | Polarised if tantalum. Ceramic is also OK. | 587-2253-1-ND (http://search.digikey.com/scripts/DkSearch/dksus.dll?Detail&name=587-2253-1-ND)
 | C12,C35,C18,C31 | 47u 6.3V | 4 | SM1206_POL | Polarised. Prefer tantalum. | 587-1348-1-ND (http://search.digikey.com/scripts/DkSearch/dksus.dll?Detail&name=587-1348-1-ND)
 | C13,C14 | 18p | 2 | SM0603 |  | 445-1272-1-ND (http://search.digikey.com/scripts/DkSearch/dksus.dll?Detail&name=445-1272-1-ND)
 | C2,C3,C4,C5,C6,C7,C8,C9,C10,C15,C17,C19,C20,C21,C22,C23,C24,C25,C26,C27,C28,C29,C96,C95,C94,C93,C92,C91,C30,C33,C34,C36,C59,C58,C57,C56,C55,C54,C53,C43,C42,C41,C40,C39,C38,C37,C60,C61,C63,C64,C65 | 0u1 | 51 | SM0603 |  | 445-5122-1-ND (http://search.digikey.com/scripts/DkSearch/dksus.dll?Detail&name=445-5122-1-ND)
 | C32 | 22u 16V | 1 | SM1210_POL | Polarised if tantalum. Ceramic also OK. | 478-1682-1-ND (http://search.digikey.com/scripts/DkSearch/dksus.dll?Detail&name=478-1682-1-ND)
 | C44,C45,C46,C47,C48,C49,C50,C51,C52,C16,C62 | 1u 16V | 11 | SM0603 |  | 445-5156-1-ND (http://search.digikey.com/scripts/DkSearch/dksus.dll?Detail&name=445-5156-1-ND)
 | D1 | DIODESIL | 1 | SM0603_DIODE |  | 641-1002-1-ND (http://search.digikey.com/scripts/DkSearch/dksus.dll?Detail&name=641-1002-1-ND)
 | D16,D17,D5 | DIODESCH | 3 | SM0603_DIODE |  | 641-1006-1-ND (http://search.digikey.com/scripts/DkSearch/dksus.dll?Detail&name=641-1006-1-ND)
 | D2 | 5V1 | 1 | SOD523 |  | EDZTE615.1BCT-ND (http://search.digikey.com/scripts/DkSearch/dksus.dll?Detail&name=EDZTE615.1BCT-ND)
 | D3,D4 | 3V6 | 2 | SOD523 |  | EDZTE613.6BCT-ND (http://search.digikey.com/scripts/DkSearch/dksus.dll?Detail&name=EDZTE613.6BCT-ND)
 | F1 | FUSE | 1 | SM1206 |  | F2110CT-ND (http://search.digikey.com/scripts/DkSearch/dksus.dll?Detail&name=F2110CT-ND)
 | IC1 | ATMEGA2560-A | 1 | TQFP_100 |  | ATMEGA2560-16AU-ND (http://search.digikey.com/scripts/DkSearch/dksus.dll?Detail&name=ATMEGA2560-16AU-ND)
 | J4,J1 | JUMPER_2W | 2 | JUMPER_3PAD |  | P0.0GCT-ND (x2) (http://search.digikey.com/scripts/DkSearch/dksus.dll?Detail&name=P0.0GCT-ND)
 | K1,K2,K5,K6 | JST_2MM_3x1 | 5 | CONN_3 |  | 455-1705-ND (http://search.digikey.com/scripts/DkSearch/dksus.dll?vendor=0&keywords=455-1705-ND)
 | L1,L2 | 10u | 2 | SM0805 |  | 587-2487-6-ND (http://search.digikey.com/scripts/DkSearch/dksus.dll?Detail&name=587-2487-6-ND)
 | P1 | CONN_3X2 | 0.1 | PIN_ARRAY_3X2 | 2.54mm pitch, unshrouded SPLIT FROM 30-POS | SAM1113-15-ND (http://www.digikey.com/product-detail/en/TD-115-G-A/SAM1113-15-ND/1105511)
 | P2,K4 | JST_2MM_5x1 | 2 | CONN_5 |  | 455-1707-ND (http://search.digikey.com/scripts/DkSearch/dksus.dll?Detail&itemSeq=94318860&uq=634281172891716883)
 | P5,P4 | JST_2MM_9x1 | 2 | CONN_9 |  | 455-1711-ND (http://search.digikey.com/scripts/DkSearch/dksus.dll?Detail&name=455-1711-ND)
 | P6,P3 | JST_2MM_6x1 | 2 | CONN_6 |  | 455-1708-ND (http://search.digikey.com/scripts/DkSearch/dksus.dll?Detail&name=455-1708-ND)
 | P7 | JST_2MM_12x1 | 1 | CONN_12 |  | 455-1714-ND (http://search.digikey.com/scripts/DkSearch/dksus.dll?Detail&name=455-1714-ND)
 | P8 | CONN_30_LCD | 1 | CONN30_SMD |  | WM7976CT-ND (http://search.digikey.com/scripts/DkSearch/dksus.dll?detail&name=WM7976CT-ND)
 | P13 | JST_2MM_8x1 | 1 | CONN_8 |  | 455-1710-ND (http://search.digikey.com/scripts/DkSearch/dksus.dll?Detail&name=455-1710-ND)
 | P14,P18 | JST_2MM_2x1 | 2 | CONN_2 |  | 455-1704-ND (http://search.digikey.com/scripts/DkSearch/dksus.dll?vendor=0&keywords=455-1704-ND)
 | P15,P12 | JST_2MM_4x1 | 2 | CONN_4 |  | 455-1706-ND (http://search.digikey.com/scripts/DkSearch/dksus.dll?Detail&itemSeq=101953209&uq=634451471635632513)
 | Q2,Q1,Q4,Q7,Q5,Q8,Q9 | BC847C | 7 | SOT23-BCE |  | 568-1636-1-ND (http://search.digikey.com/scripts/DkSearch/dksus.dll?Detail&name=568-1636-1-ND)
 | Q3 | BC857C | 1 | SOT23-BCE |  | BC857C-FDICT-ND (http://search.digikey.com/scripts/DkSearch/dksus.dll?Detail&name=BC857C-FDICT-ND)
 | Q6,Q10 | Si2319DS | 2 | SOT23GDS |  | SI2319DS-T1-E3CT-ND (http://search.digikey.com/scripts/DkSearch/dksus.dll?Detail&name=SI2319DS-T1-E3CT-ND)
 | R1,R42,R43,R44,R45,R50,R51,R52,R53,R58,R59,R60,R61,R62,R69,R74,R72,R81,R28,R27,R23,R16,R17,R33,R77,R101,R107,R108,R109,R110,R32,R111,R112,R114 | 5K1 | 34 | SM0603 |  | P5.1KGCT-ND (http://search.digikey.com/scripts/DkSearch/dksus.dll?Detail&name=P5.1KGCT-ND)
 | R104,R105 | 68R | 2 | SM0603 |  | P68GCT-ND (http://search.digikey.com/scripts/DkSearch/dksus.dll?Detail&name=P68GCT-ND)
 | R106 | 1K5 | 1 | SM0603 |  | P1.5KGCT-ND (http://search.digikey.com/scripts/DkSearch/dksus.dll?Detail&name=P1.5KGCT-ND)
 | R2 | 2K7 | 1 | SM0603 |  | P2.7KGCT-ND (http://search.digikey.com/scripts/DkSearch/dksus.dll?Detail&name=P2.7KGCT-ND)
 | R25,R35,R46,R47,R48,R49,R54,R55,R56,R57,R63,R64,R65,R66,R67,R118 | 10K | 16 | SM0603 |  | P10KGCT-ND (http://search.digikey.com/scripts/DkSearch/dksus.dll?Detail&name=P10KGCT-ND)
 | R3,R4,R5,R6,R8,R9,R10,R11,R12,R18,R19,R20,R26,R68,R71,R70,R83,R84,R91,R96,R95,R94,R93,R92,R100,R99,R98,R97,R90,R89,R88,R87,R86,R78,R22,R21,R14,R13,R102,R24 | 200R | 40 | SM0603 |  | P200GCT-ND (http://search.digikey.com/scripts/DkSearch/dksus.dll?Detail&name=P200GCT-ND)
 | R30,R29 | 100R | 2 | SM0603 |  | P100GCT-ND (http://search.digikey.com/scripts/DkSearch/dksus.dll?Detail&name=P100GCT-ND)
 | R31,R34,R79 | 10K2 | 3 | SM0603 |  | P10.2KHCT-ND (http://search.digikey.com/scripts/DkSearch/dksus.dll?Detail&name=P10.2KHCT-ND)
 | R36,R15,R85,R113,R115 | 100K | 5 | SM0603 |  | P100KGCT-ND (http://search.digikey.com/scripts/DkSearch/dksus.dll?Detail&name=P100KGCT-ND)
 | R37,R80 | 150K | 2 | SM0603 |  | P150KGCT-ND (http://search.digikey.com/scripts/DkSearch/dksus.dll?Detail&name=P150KGCT-ND)
 | R39,R40 | 0R | 2 | SM0603 |  | P0.0GCT-ND (http://search.digikey.com/scripts/DkSearch/dksus.dll?Detail&name=P0.0GCT-ND)
 | R7 | 180K | 1 | SM0603 |  | P180KGCT-ND (http://search.digikey.com/scripts/DkSearch/dksus.dll?Detail&name=P180KGCT-ND)
 | R73,R75,R82,R103,R117 | 1K | 5 | SM0603 |  | P1.0KGCT-ND (http://search.digikey.com/scripts/DkSearch/dksus.dll?Detail&name=P1.0KGCT-ND)
 | R76 | 3K9 | 1 | SM0603 |  | P3.9KGCT-ND (http://search.digikey.com/fi/en/products/ERJ-3GEYJ392V/P3.9KGCT-ND/135159)
 | SW2,SW6,SW4,SW1,SW5,SW3 --> SEE NOTE | SW_PUSH | 6 | SW_PUSH_6x4MM | SUPPLY LOOSE. DO NOT MOUNT. 谢谢 | 450-1653-ND (http://search.digikey.com/scripts/DkSearch/dksus.dll?Detail&name=450-1653-ND)
 | U1,U2 | 78L05 | 2 | SOT89_OGI |  | NJM78L05UA-ND (http://search.digikey.com/us/en/products/NJM78L05UA/NJM78L05UA-ND/805773)
 | U3 | LN-6206-30 | 1 | SOT89_GIO |  | AP7215-33YG-13DICT-ND (http://search.digikey.com/scripts/DkSearch/dksus.dll?Detail&name=AP7215-33YG-13DICT-ND)
 | U4 | TPS77601 | 1 | SO8E |  | 296-2777-5-ND (http://search.digikey.com/scripts/DkSearch/dksus.dll?Detail&name=296-2777-5-ND)
 | U5 | REF3012 | 1 | SOT23-IGO |  | REF3012AIDBZTCT-ND (http://search.digikey.com/scripts/DkSearch/dksus.dll?Detail&name=REF3012AIDBZTCT-ND)
 | X1 | 16MHz | 1 | XTAL_HC49US |  | XC1748-ND (http://search.digikey.com/scripts/DkSearch/dksus.dll?Detail&name=XC1748-ND)
IMPORTANT NOTES
+ | These component positions intentionally left blank: K3, P10, P20, P21
+ | The 30-way "LCD socket" should be the specified Molex brand version, to facilitate reliably pick-and-place operation.
+ | All DigiKey part links intended as reference only. Chinese sourced parts are OK.
+ | Please do not mount the six push button switches, as they have caused trouble in the past. Instead, please supply the parts loose and we will hand solder them. Thank you.
