sylvandb/gruvin9x/doc/Compile Tutorial.pdf

### Simple guide to downloading and compiling firmware files in Windows by Telemachus

(This assumes WINAVR has already been installed)

1) Install Tortoise SVN control from this site:

http://tortoisesvn.net/downloads

2) Restart computer
3) Go to the directory where you want to download files to compile.
4) RIGHT CLICK anywhere in that directory. You will see an action item on the RIGHT CLICK dialog that now says: SVN CHECKOUT.

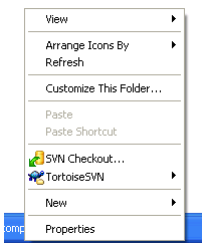
[picture p55: figure]

5) Add the following repository:

http://er9x.googlecode.com/svn/trunk

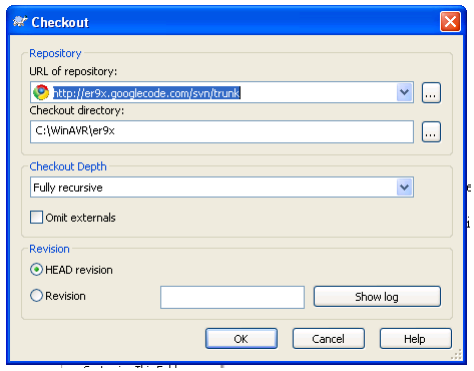
[picture p56: figure]

6) Click “OK” and let it go! It should now create an ER9x directory.
7) Go into that directory and enter the SRC directory.
8) Copy the batch file included in this archive named Compile.bat to this directory, or if you would rather, create a .bat file with just the word MAKE inside of it.
9) Click on the “Compile” icon and it will make your firmware. The appropriate .hex file will be in the SRC directory as a .hex file.
10) When you want to newest release, follow steps 4, 5 and 9 again and it will download and compile the newest version for you.
