sylvandb/gruvin9x/hardware/gprog/gprog.sch

## KiCad design hardware/gprog/gprog.sch (2012-09-12)

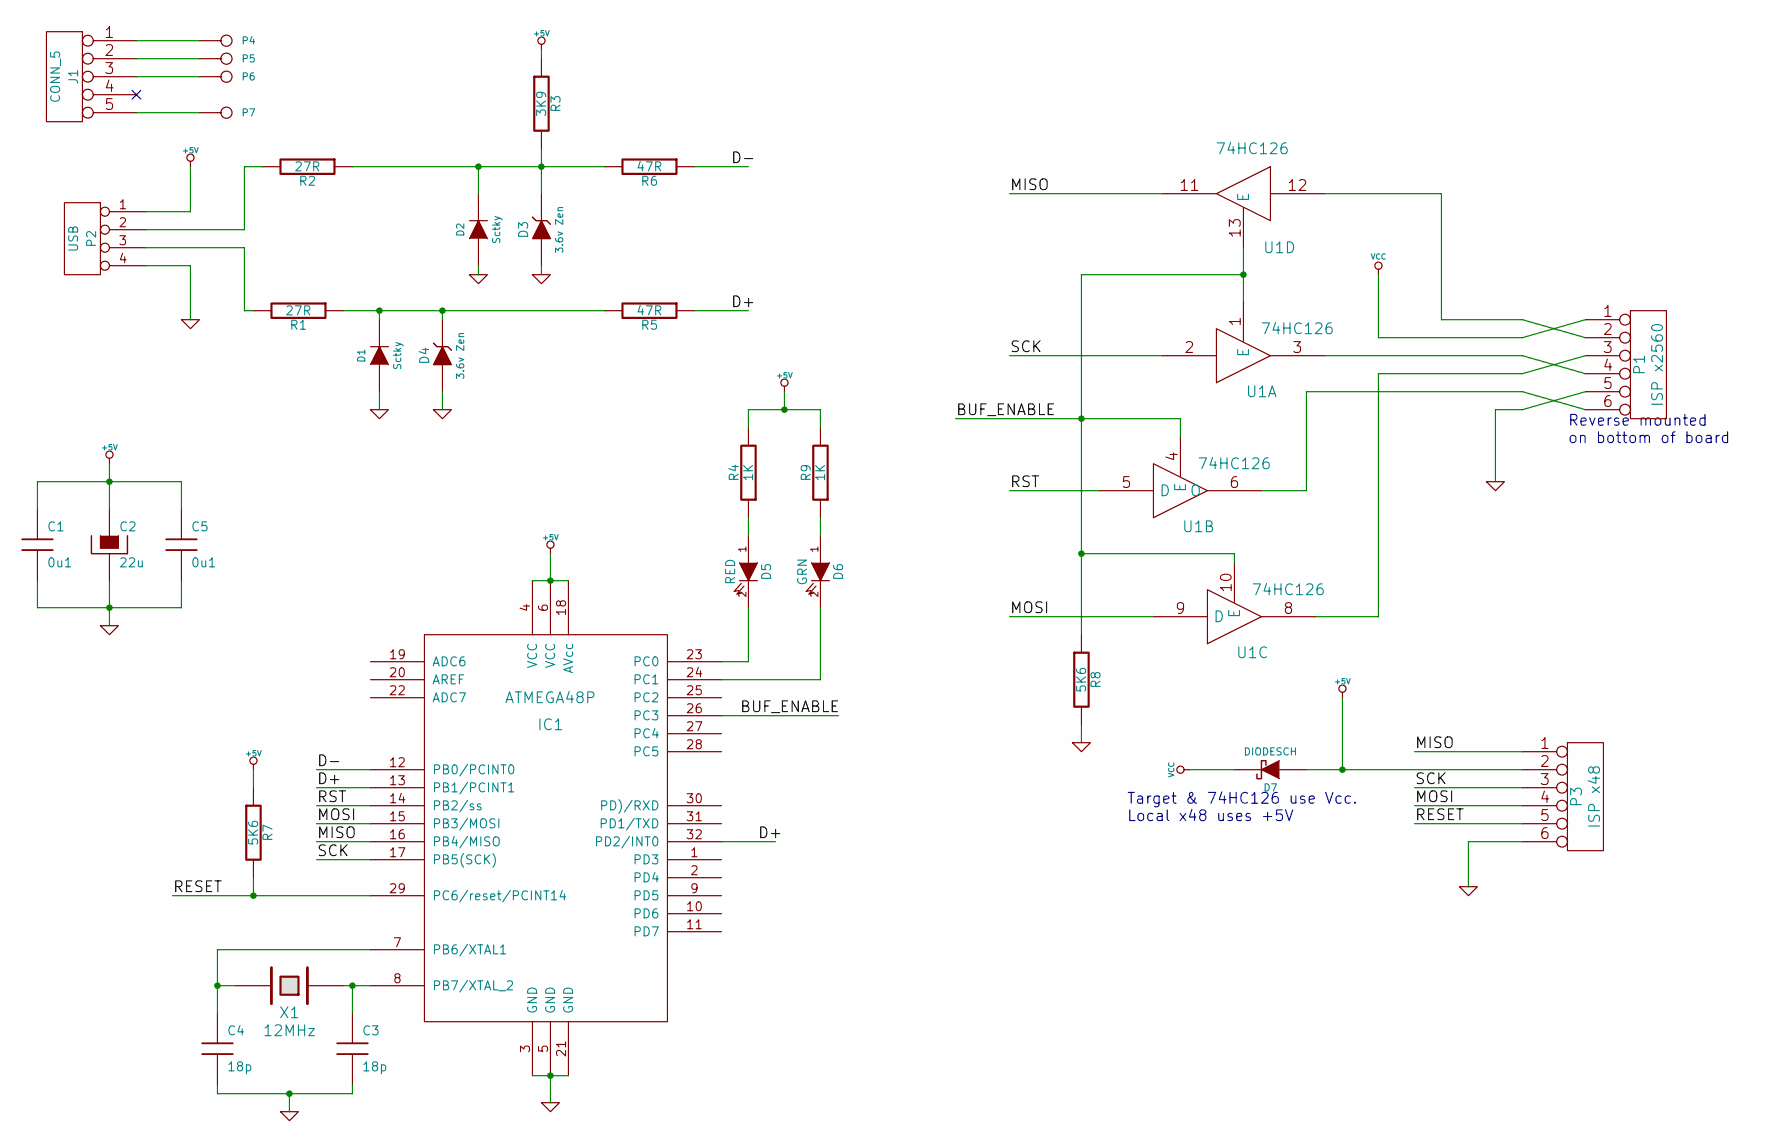
[picture p58: schematic gprog.sch]

Parts:
C1, C5: 0u1
C2: 22u
C3, C4: 18p
D1, D2: Sctky
D3, D4: 3.6v Zen
D5: RED
D6: GRN
D7: DIODESCH
IC1: ATMEGA48P
J1: CONN_5
P1: ISP x2560
P2: USB
P3: ISP x48
P4, P5, P6, P7: CONN_1
R1, R2: 27R
R3: 3K9
R4, R9: 1K
R5, R6: 47R
R7, R8: 5K6
U1: 74HC126
X1: 12MHz

Connections:
+5V: C1.1, C2.1, C5.1, D7.1 (A), IC1.4 (VCC), IC1.6 (VCC), IC1.18 (AVcc), P2.1, P3.2, R3.1, R4.2, R7.1, R9.2
BUF_ENABLE: IC1.26 (PC3), R8.1, U1.1 (E), U1.4 (E), U1.10 (E), U1.13 (E)
D+: IC1.13 (PB1/PCINT1), IC1.32 (PD2/INT0), R5.1
D-: IC1.12 (PB0/PCINT0), R6.1
GND: C1.2, C2.2, C3.2, C4.2, C5.2, D1.1 (A), D2.1 (A), D3.1 (A), D4.1 (A), IC1.3 (GND), IC1.5 (GND), IC1.21 (GND), P1.5, P2.4, P3.6, R8.2
MISO: IC1.16 (PB4/MISO), P3.1, U1.11
MOSI: IC1.15 (PB3/MOSI), P3.4, U1.9 (D)
unnamed: C3.1, IC1.8 (PB7/XTAL_2), X1.1
unnamed: C4.1, IC1.7 (PB6/XTAL1), X1.2
unnamed: D1.2 (K), D4.2 (K), R1.1, R5.2
unnamed: D2.2 (K), D3.2 (K), R2.1, R3.2, R6.2
unnamed: D5.1 (A), R4.1
unnamed: D5.2 (K), IC1.23 (PC0)
unnamed: D6.1 (A), R9.1
unnamed: D6.2 (K), IC1.24 (PC1)
unnamed: J1.1, P4.1
unnamed: J1.2, P5.1
unnamed: J1.3, P6.1
unnamed: J1.5, P7.1
unnamed: P1.2, U1.12
unnamed: P1.3, U1.8
unnamed: P1.4, U1.3
unnamed: P1.6, U1.6 (O)
unnamed: P2.2, R2.2
unnamed: P2.3, R1.2
RESET: IC1.29 (PC6/reset/PCINT14), P3.5, R7.2
RST: IC1.14 (PB2/ss), U1.5 (D)
SCK: IC1.17 (PB5(SCK)), P3.3, U1.2
VCC: D7.2 (K), P1.1

Notes on the sheet:
Reverse mounted on bottom of board
Target & 74HC126 use Vcc. Local x48 uses +5V
