sylvandb/gruvin9x/hardware/pcb/frsky_dsmx_caddy.sch

## KiCad design hardware/pcb/frsky_dsmx_caddy.sch (2013-07-10)

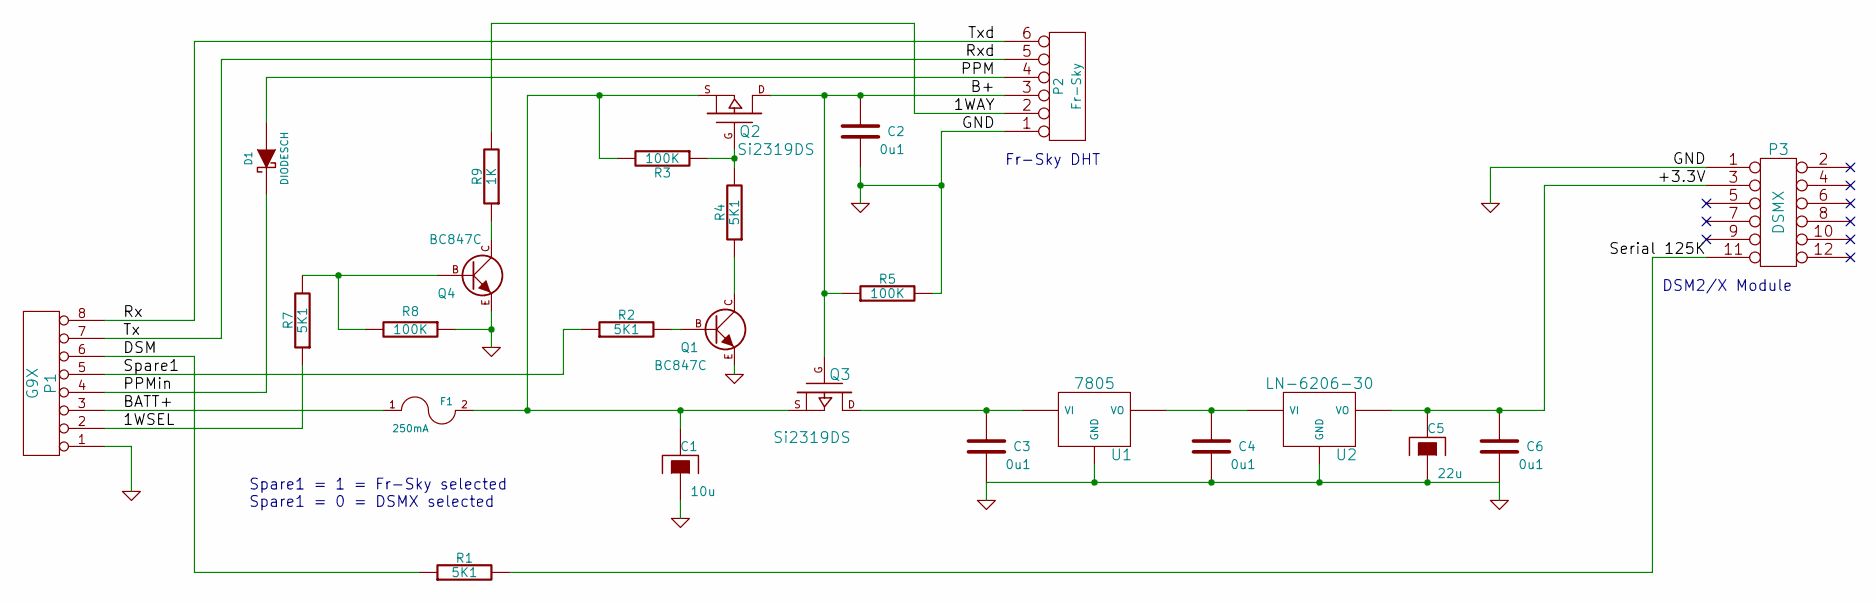
[picture p59: schematic frsky_dsmx_caddy.sch]

Parts:
C1: 10u
C2, C3, C4, C6: 0u1
C5: 22u
D1: DIODESCH
F1: 250mA
P1: G9X
P2: Fr-Sky
P3: DSMX
Q1, Q4: BC847C; SOT23-BCE
Q2, Q3: Si2319DS
R1, R2, R4, R7: 5K1
R3, R5, R8: 100K
R9: 1K
U1: 7805; TO220
U2: LN-6206-30; SOT89

Connections:
1WAY: P2.2, R9.2
1WSEL: P1.2, R7.1
+3.3V: C5.2, C6.2, P3.3, U2.VO
B+: C2.2, P2.3, Q2.D, Q3.G, R5.1
BATT+: F1.1, P1.3
DSM: P1.6, R1.1
GND: C1.1, C2.1, C3.1, C4.1, C5.1, C6.1, P1.1, P2.1, P3.1, Q1.E, Q4.E, R5.2, R8.1, U1.GND, U2.GND
unnamed: C1.2, F1.2, Q2.S, Q3.S, R3.2
unnamed: C3.2, Q3.D, U1.VI
unnamed: C4.2, U1.VO, U2.VI
unnamed: Q1.B, R2.2
unnamed: Q1.C, R4.1
unnamed: Q2.G, R3.1, R4.2
unnamed: Q4.B, R7.2, R8.2
unnamed: Q4.C, R9.1
PPM: D1.1 (A), P2.4
PPMin: D1.2 (K), P1.4
Rx: P1.8, P2.6
Rxd: P1.7, P2.5
Serial 125K: P3.11, R1.2
Spare1: P1.5, R2.1

Notes on the sheet:
Spare1 = 1 = Fr-Sky selected Spare1 = 0 = DSMX selected
DSM2/X Module
Fr-Sky DHT
