sylvandb/gruvin9x/hardware/pcb/g9x_rx_mpx.sch

## KiCad design hardware/pcb/g9x_rx_mpx.sch (2012-06-12)

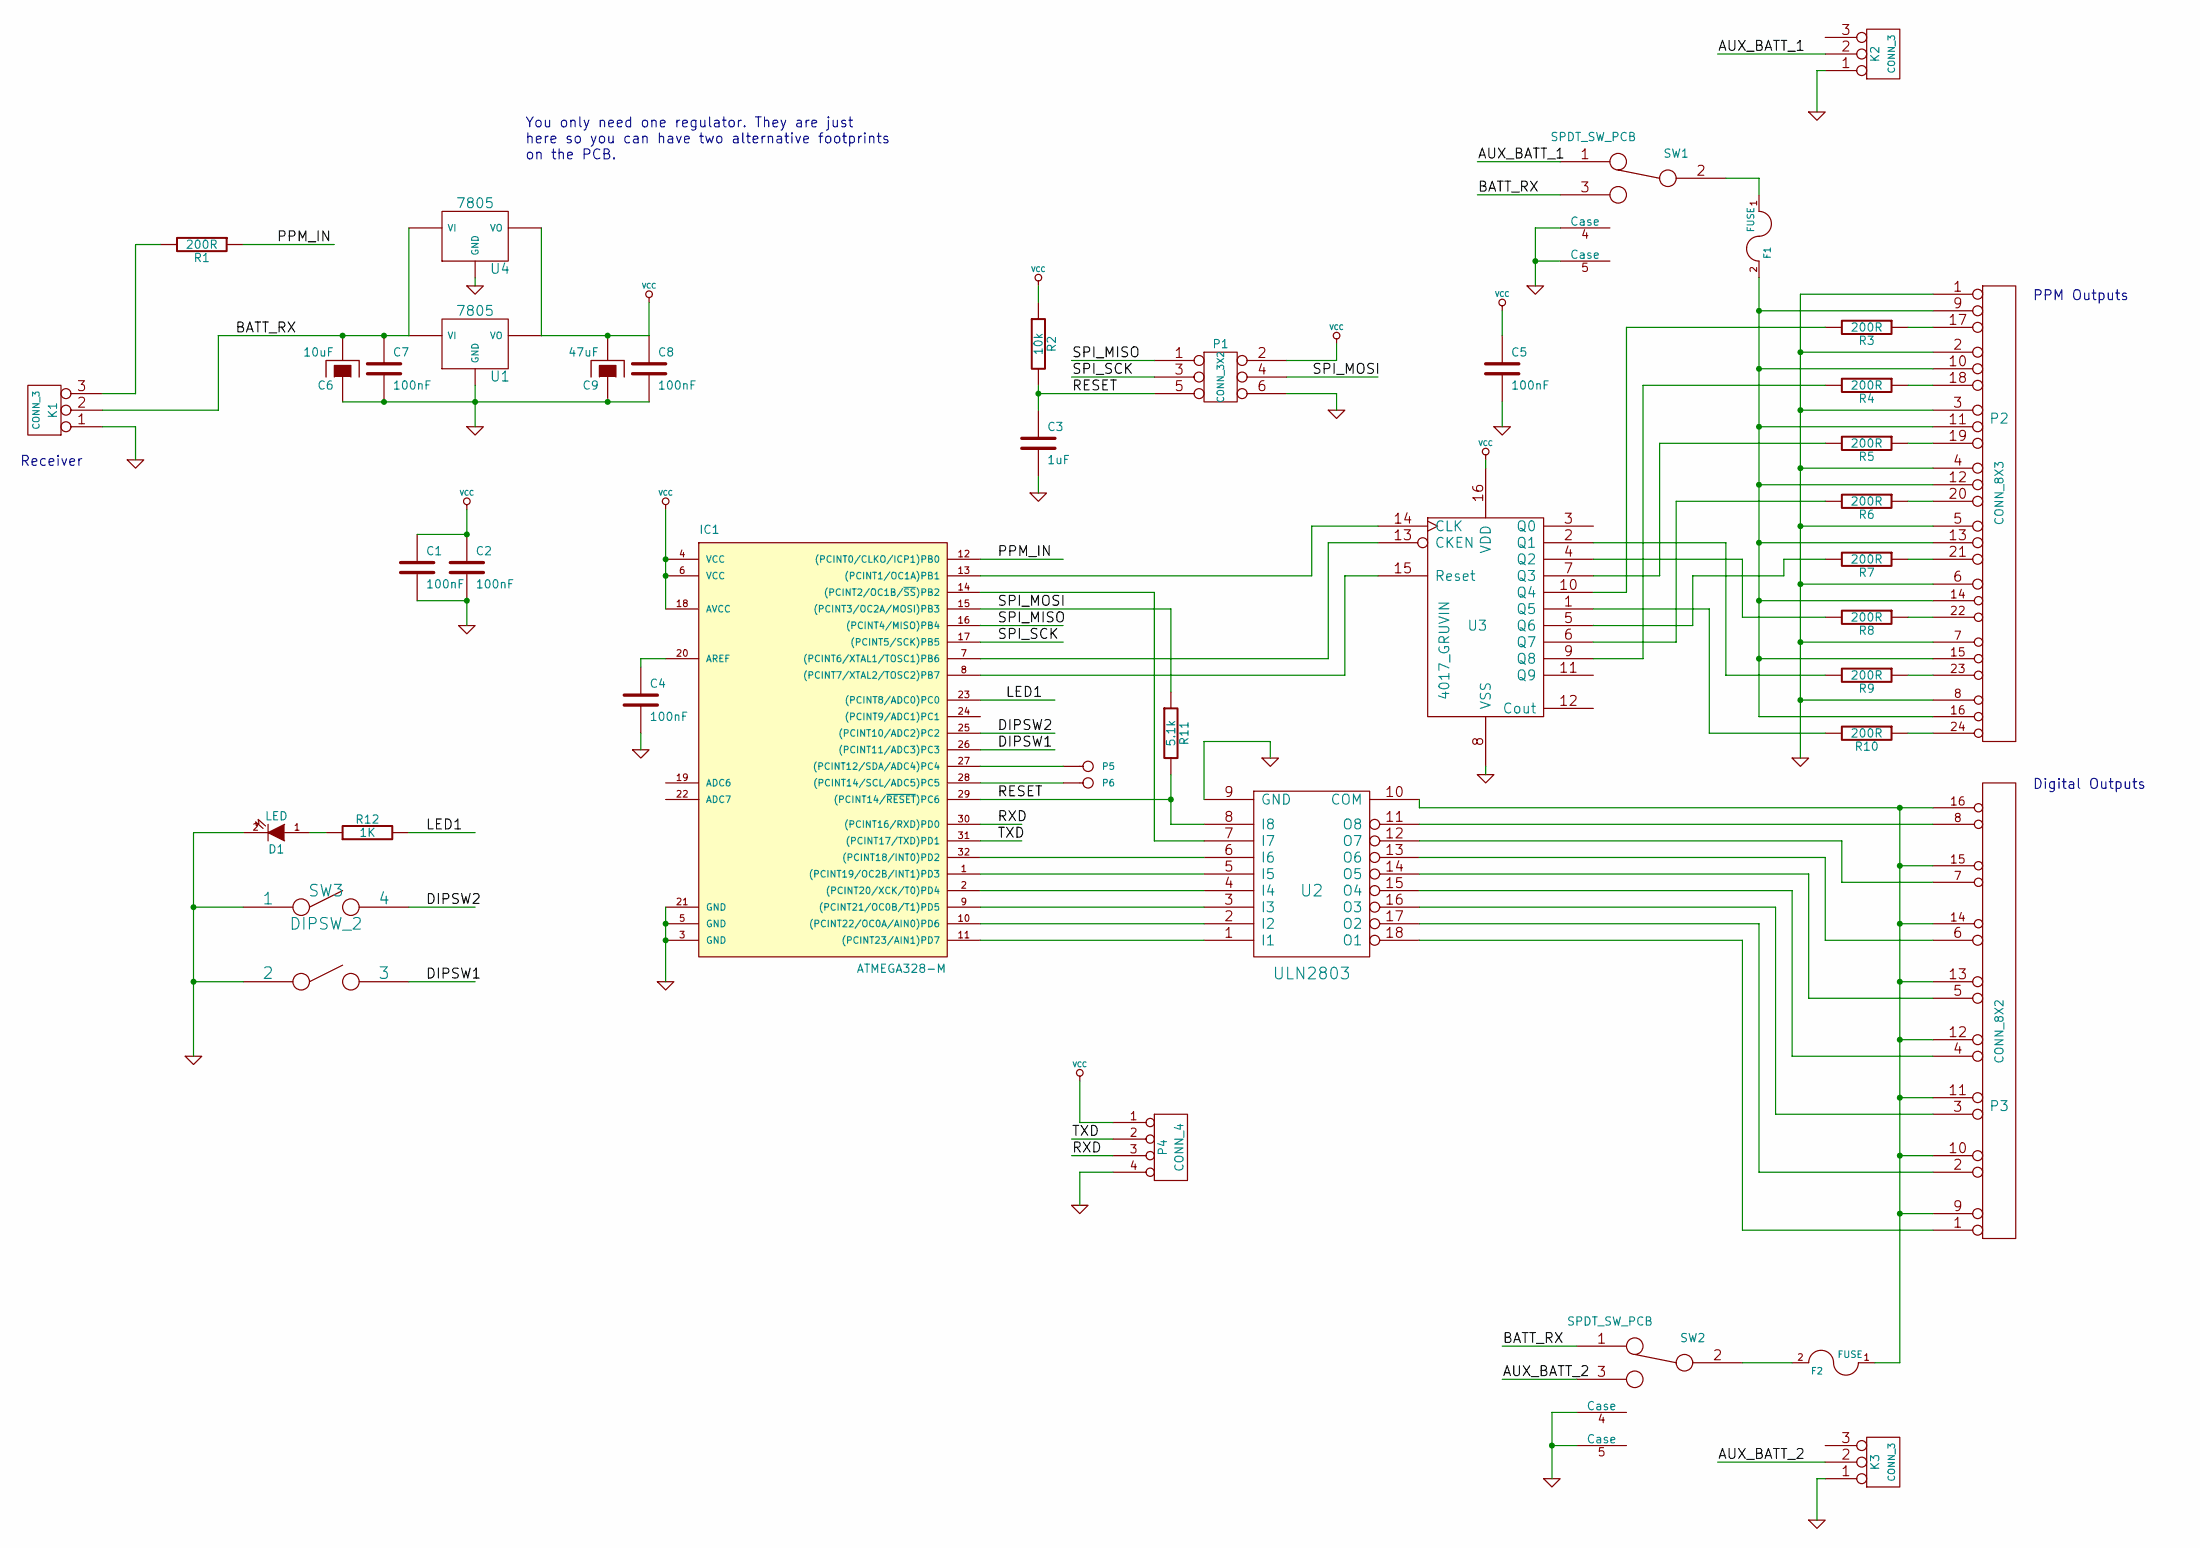
[picture p60: schematic g9x_rx_mpx.sch]

Parts:
C1, C2, C4, C5, C7, C8: 100nF
C3: 1uF
C6: 10uF
C9: 47uF
D1: LED
F1, F2: FUSE
IC1: ATMEGA328-M; MLF/QFN32
K1, K2, K3: CONN_3
P1: CONN_3X2
P2: CONN_8X3
P3: CONN_8X2
P4: CONN_4
P5, P6: CONN_1
R1, R3, R4, R5, R6, R7, R8, R9, R10: 200R
R2: 10k
R11: 5.1k
R12: 1K
SW1, SW2: SPDT_SW_PCB
SW3: DIPSW_2
U1, U4: 7805
U2: ULN2803
U3: 4017_GRUVIN

Connections:
AUX_BATT_1: K2.2 (PM), SW1.1
AUX_BATT_2: K3.2 (PM), SW2.3
BATT_RX: C6.2, C7.1, K1.2 (PM), SW1.3, SW2.1, U1.VI, U4.VI
DIPSW1: IC1.26 ((PCINT11/ADC3)PC3), SW3.3
DIPSW2: IC1.25 ((PCINT10/ADC2)PC2), SW3.4
GND: C1.2, C2.2, C3.2, C4.2, C5.2, C6.1, C7.2, C8.2, C9.1, D1.2 (K), IC1.3 (GND), IC1.5 (GND), IC1.21 (GND), K1.1, K2.1, K3.1, P1.6, P2.1, P2.2, P2.3, P2.4, P2.5, P2.6, P2.7, P2.8, P4.4, SW1.4 (Case), SW1.5 (Case), SW2.4 (Case), SW2.5 (Case), SW3.1, SW3.2, U1.GND, U2.9 (GND), U3.8 (VSS), U4.GND
LED1: IC1.23 ((PCINT8/ADC0)PC0), R12.2
unnamed: C4.1, IC1.20 (AREF)
unnamed: D1.1 (A), R12.1
unnamed: F1.1, SW1.2
unnamed: F1.2, P2.9, P2.10, P2.11, P2.12, P2.13, P2.14, P2.15, P2.16
unnamed: F2.1, P3.9, P3.10, P3.11, P3.12, P3.13, P3.14, P3.15, P3.16, U2.10 (COM)
unnamed: F2.2, SW2.2
unnamed: IC1.1 ((PCINT19/OC2B/INT1)PD3), U2.5 (I5)
unnamed: IC1.2 ((PCINT20/XCK/T0)PD4), U2.4 (I4)
unnamed: IC1.7 ((PCINT6/XTAL1/TOSC1)PB6), U3.13 (CKEN)
unnamed: IC1.8 ((PCINT7/XTAL2/TOSC2)PB7), U3.15 (Reset)
unnamed: IC1.9 ((PCINT21/OC0B/T1)PD5), U2.3 (I3)
unnamed: IC1.10 ((PCINT22/OC0A/AIN0)PD6), U2.2 (I2)
unnamed: IC1.11 ((PCINT23/AIN1)PD7), U2.1 (I1)
unnamed: IC1.13 ((PCINT1/OC1A)PB1), U3.14 (CLK)
unnamed: IC1.14 ((PCINT2/OC1B/~SS~)PB2), U2.7 (I7)
unnamed: IC1.27 ((PCINT12/SDA/ADC4)PC4), P5.1
unnamed: IC1.28 ((PCINT14/SCL/ADC5)PC5), P6.1
unnamed: IC1.32 ((PCINT18/INT0)PD2), U2.6 (I6)
unnamed: K1.3, R1.2
unnamed: P2.17, R3.1
unnamed: P2.18, R4.1
unnamed: P2.19, R5.1
unnamed: P2.20, R6.1
unnamed: P2.21, R7.1
unnamed: P2.22, R8.1
unnamed: P2.23, R9.1
unnamed: P2.24, R10.1
unnamed: P3.1, U2.18 (O1)
unnamed: P3.2, U2.17 (O2)
unnamed: P3.3, U2.16 (O3)
unnamed: P3.4, U2.15 (O4)
unnamed: P3.5, U2.14 (O5)
unnamed: P3.6, U2.13 (O6)
unnamed: P3.7, U2.12 (O7)
unnamed: P3.8, U2.11 (O8)
unnamed: R3.2, U3.10 (Q4)
unnamed: R4.2, U3.9 (Q8)
unnamed: R5.2, U3.7 (Q3)
unnamed: R6.2, U3.6 (Q7)
unnamed: R7.2, U3.5 (Q6)
unnamed: R8.2, U3.4 (Q2)
unnamed: R9.2, U3.2 (Q1)
unnamed: R10.2, U3.1 (Q5)
PPM_IN: IC1.12 ((PCINT0/CLKO/ICP1)PB0), R1.1
RESET: C3.1, IC1.29 ((PCINT14/~RESET~)PC6), P1.5, R2.2, R11.2, U2.8 (I8)
RXD: IC1.30 ((PCINT16/RXD)PD0), P4.3
SPI_MISO: IC1.16 ((PCINT4/MISO)PB4), P1.1
SPI_MOSI: IC1.15 ((PCINT3/OC2A/MOSI)PB3), P1.4, R11.1
SPI_SCK: IC1.17 ((PCINT5/SCK)PB5), P1.3
TXD: IC1.31 ((PCINT17/TXD)PD1), P4.2
VCC: C1.1, C2.1, C5.1, C8.1, C9.2, IC1.4 (VCC), IC1.6 (VCC), IC1.18 (AVCC), P1.2, P4.1, R2.1, U1.VO, U3.16 (VDD), U4.VO

Notes on the sheet:
You only need one regulator. They are just here so you can have two alternative footprints on the PCB.
Receiver
Digital Outputs
PPM Outputs
