sylvandb/gruvin9x/hardware/pcb/g9x_tx_mpx.sch

## KiCad design hardware/pcb/g9x_tx_mpx.sch (2012-02-17)

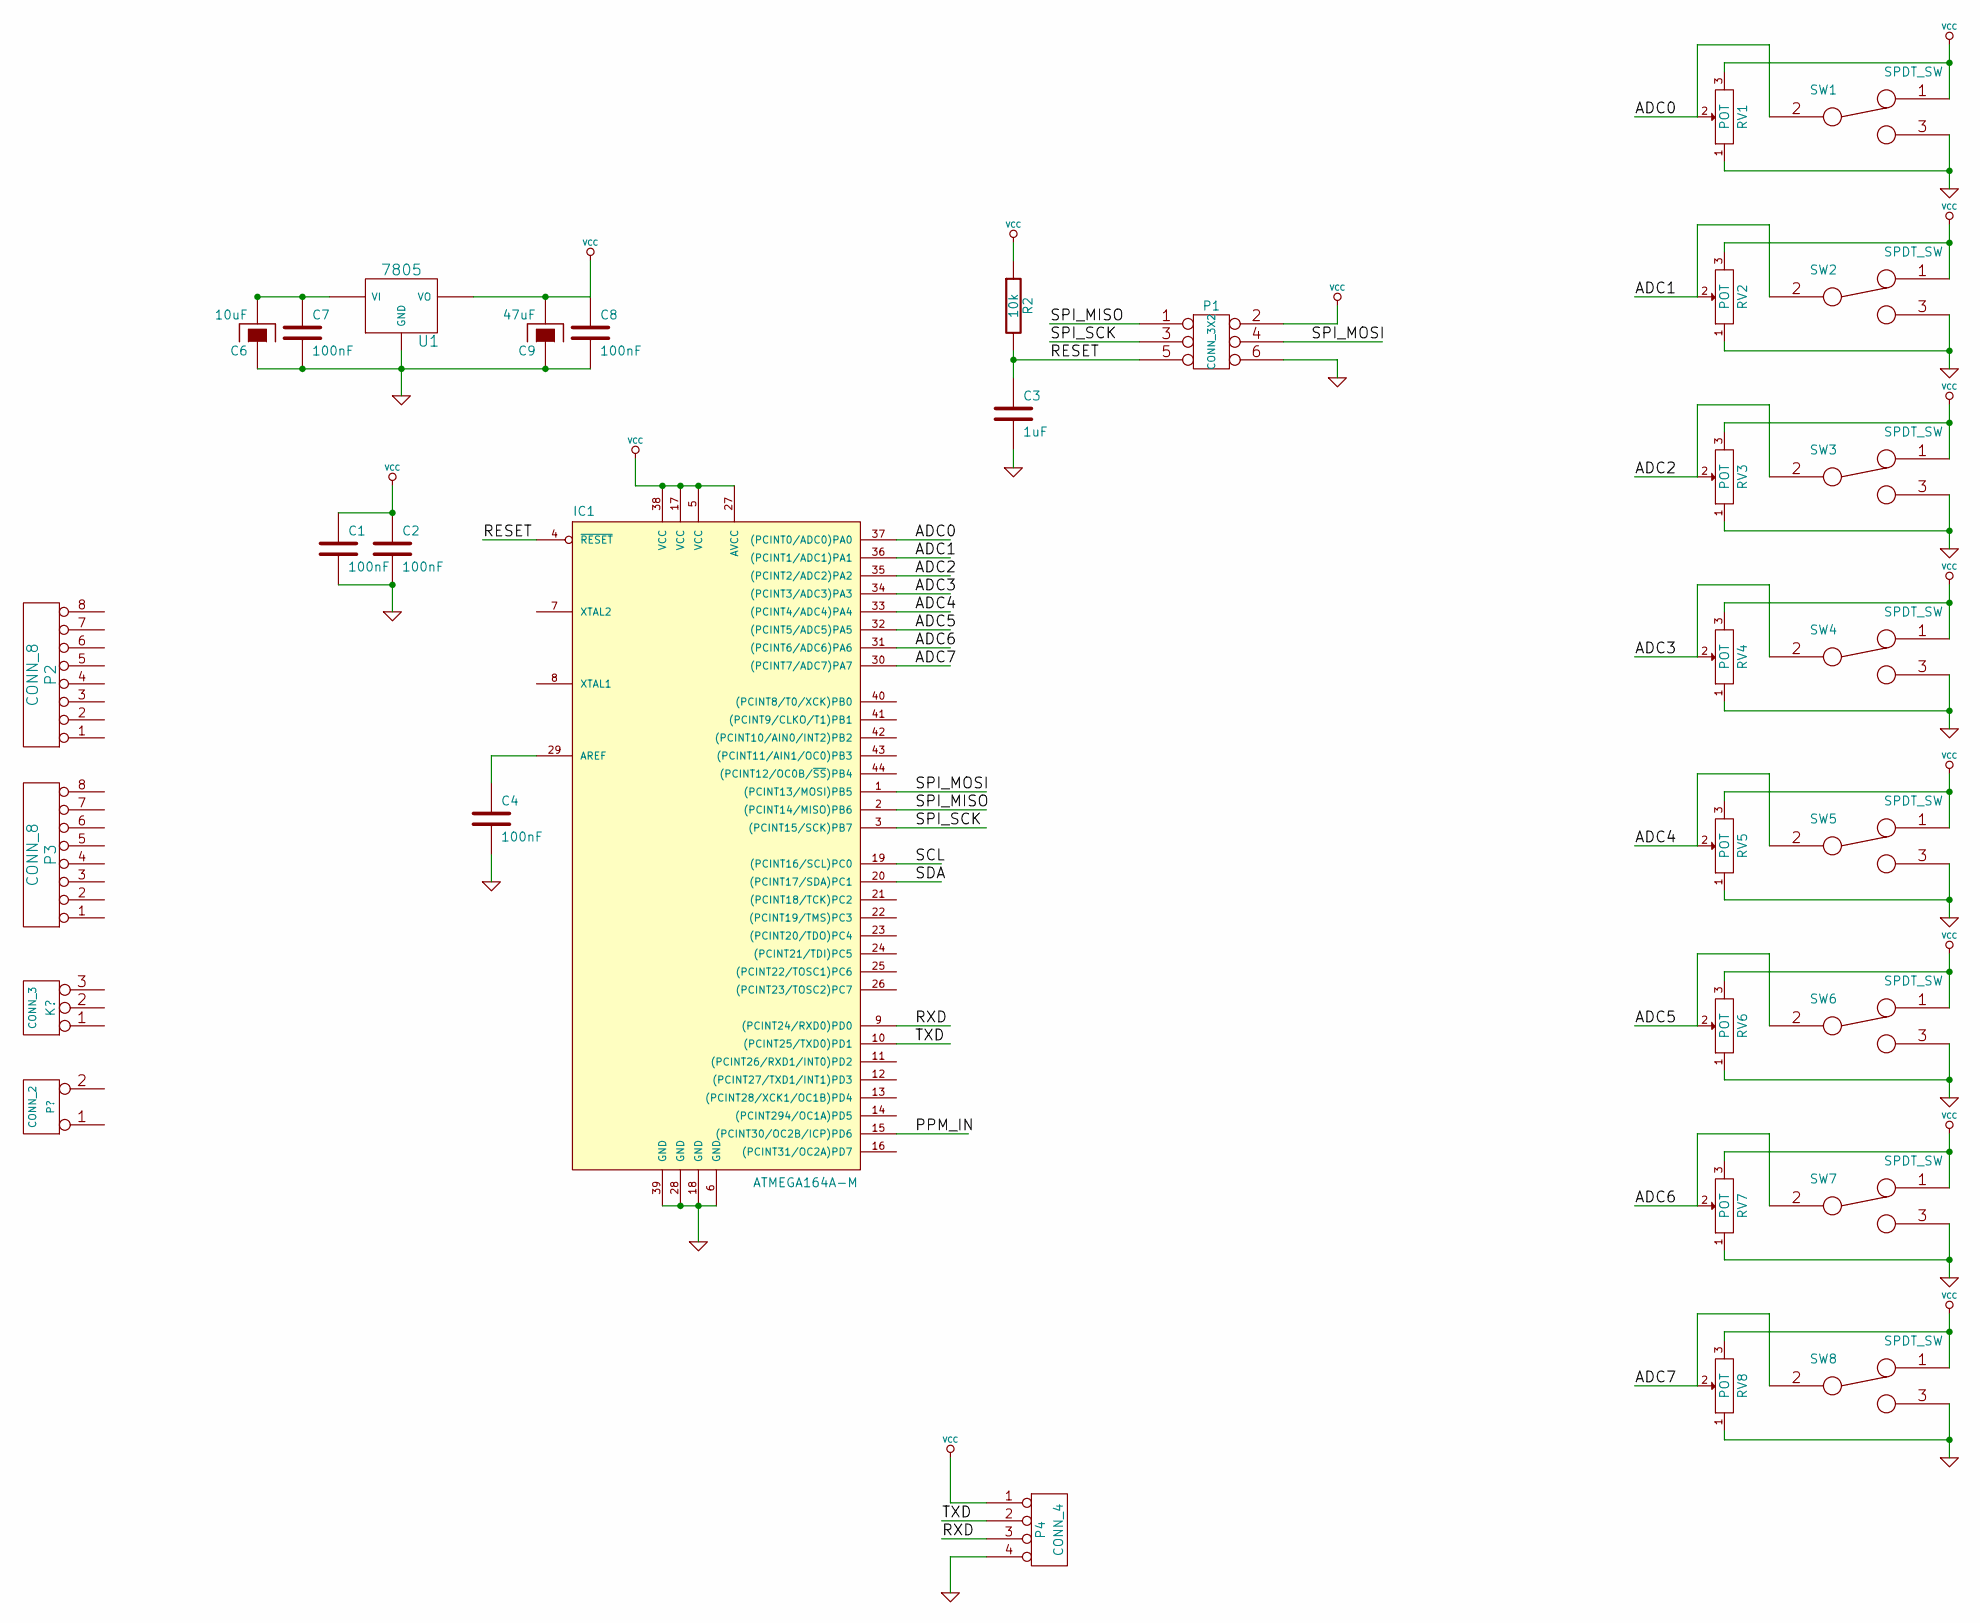
[picture p61: schematic g9x_tx_mpx.sch]

Parts:
C1, C2, C4, C7, C8: 100nF
C3: 1uF
C6: 10uF
C9: 47uF
IC1: ATMEGA164A-M; VQFN44
P1: CONN_3X2
P2, P3: CONN_8
P4: CONN_4
R2: 10k
RV1, RV2, RV3, RV4, RV5, RV6, RV7, RV8: POT
SW1, SW2, SW3, SW4, SW5, SW6, SW7, SW8: SPDT_SW
U1: 7805

Connections:
ADC0: IC1.37 ((PCINT0/ADC0)PA0), RV1.2, SW1.2
ADC1: IC1.36 ((PCINT1/ADC1)PA1), RV2.2, SW2.2
ADC2: IC1.35 ((PCINT2/ADC2)PA2), RV3.2, SW3.2
ADC3: IC1.34 ((PCINT3/ADC3)PA3), RV4.2, SW4.2
ADC4: IC1.33 ((PCINT4/ADC4)PA4), RV5.2, SW5.2
ADC5: IC1.32 ((PCINT5/ADC5)PA5), RV6.2, SW6.2
ADC6: IC1.31 ((PCINT6/ADC6)PA6), RV7.2, SW7.2
ADC7: IC1.30 ((PCINT7/ADC7)PA7), RV8.2, SW8.2
GND: C1.2, C2.2, C3.2, C4.2, C6.1, C7.2, C8.2, C9.1, IC1.6 (GND), IC1.18 (GND), IC1.28 (GND), IC1.39 (GND), P1.6, P4.4, RV1.1, RV2.1, RV3.1, RV4.1, RV5.1, RV6.1, RV7.1, RV8.1, SW1.3, SW2.3, SW3.3, SW4.3, SW5.3, SW6.3, SW7.3, SW8.3, U1.GND
unnamed: C4.1, IC1.29 (AREF)
unnamed: C6.2, C7.1, U1.VI
PPM_IN: IC1.15 ((PCINT30/OC2B/ICP)PD6)
RESET: C3.1, IC1.4 (~RESET), P1.5, R2.2
RXD: IC1.9 ((PCINT24/RXD0)PD0), P4.3
SCL: IC1.19 ((PCINT16/SCL)PC0)
SDA: IC1.20 ((PCINT17/SDA)PC1)
SPI_MISO: IC1.2 ((PCINT14/MISO)PB6), P1.1
SPI_MOSI: IC1.1 ((PCINT13/MOSI)PB5), P1.4
SPI_SCK: IC1.3 ((PCINT15/SCK)PB7), P1.3
TXD: IC1.10 ((PCINT25/TXD0)PD1), P4.2
VCC: C1.1, C2.1, C8.1, C9.2, IC1.5 (VCC), IC1.17 (VCC), IC1.27 (AVCC), IC1.38 (VCC), P1.2, P4.1, R2.1, RV1.3, RV2.3, RV3.3, RV4.3, RV5.3, RV6.3, RV7.3, RV8.3, SW1.1, SW2.1, SW3.1, SW4.1, SW5.1, SW6.1, SW7.1, SW8.1, U1.VO
