sylvandb/gruvin9x/hardware/pcb/gruvin9x.sch

## KiCad design hardware/pcb/gruvin9x.sch (2013-07-10)

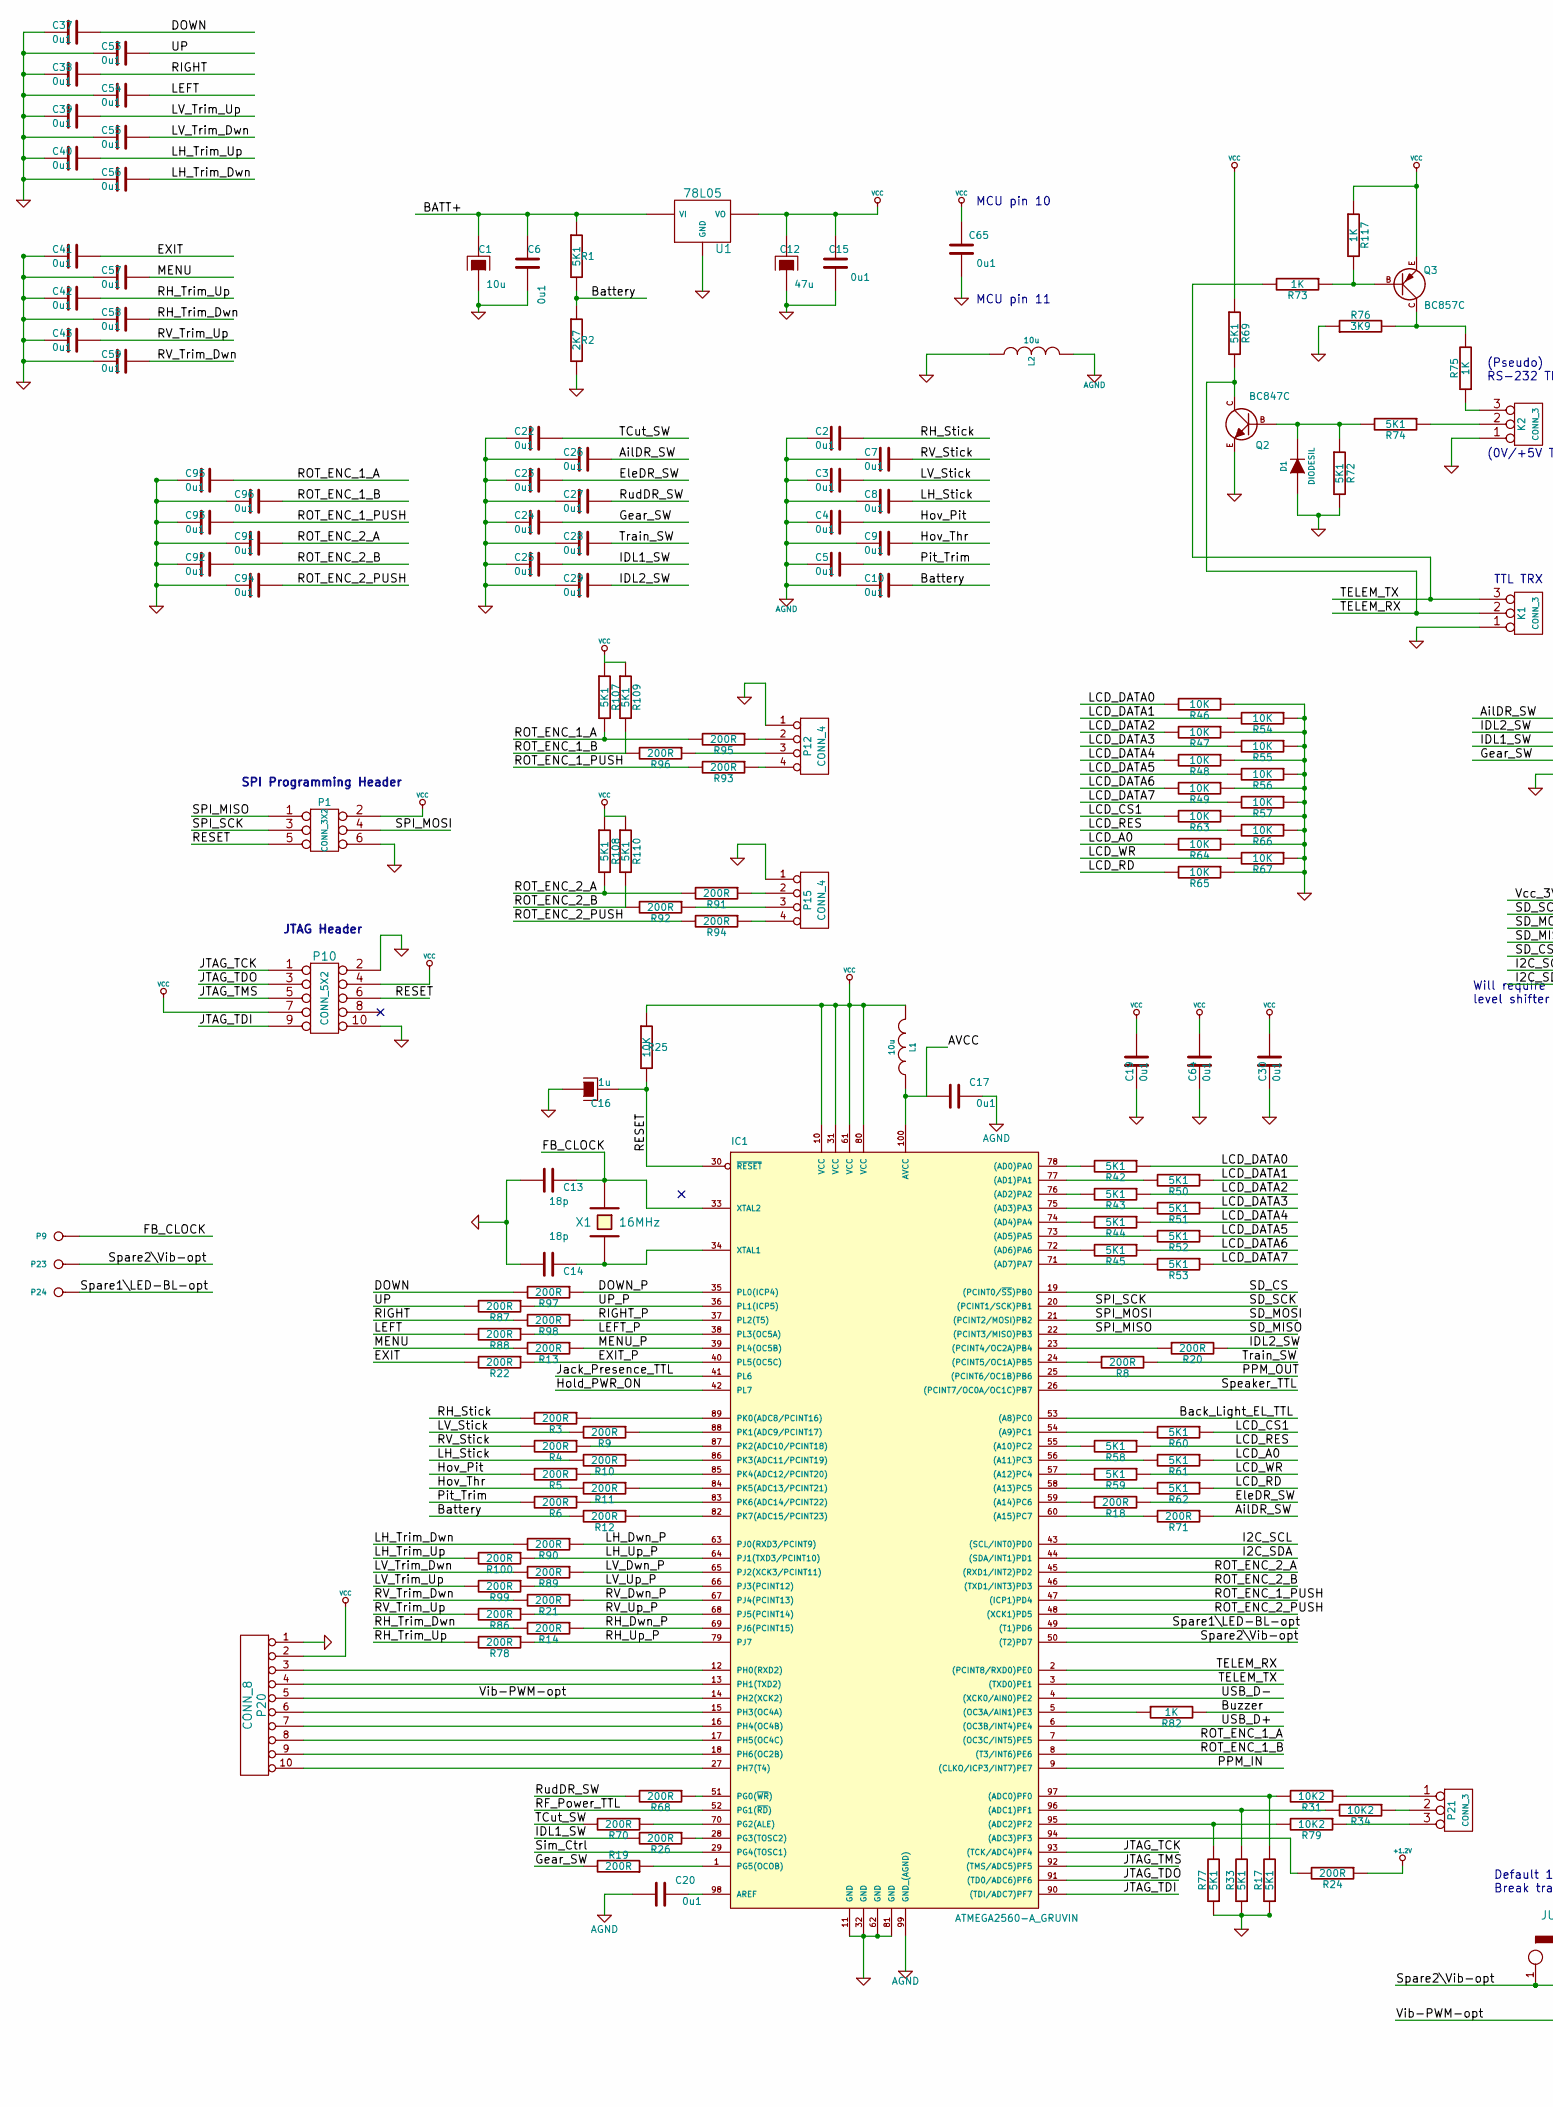
[picture p62: schematic gruvin9x.sch, part in row 1, column 1]

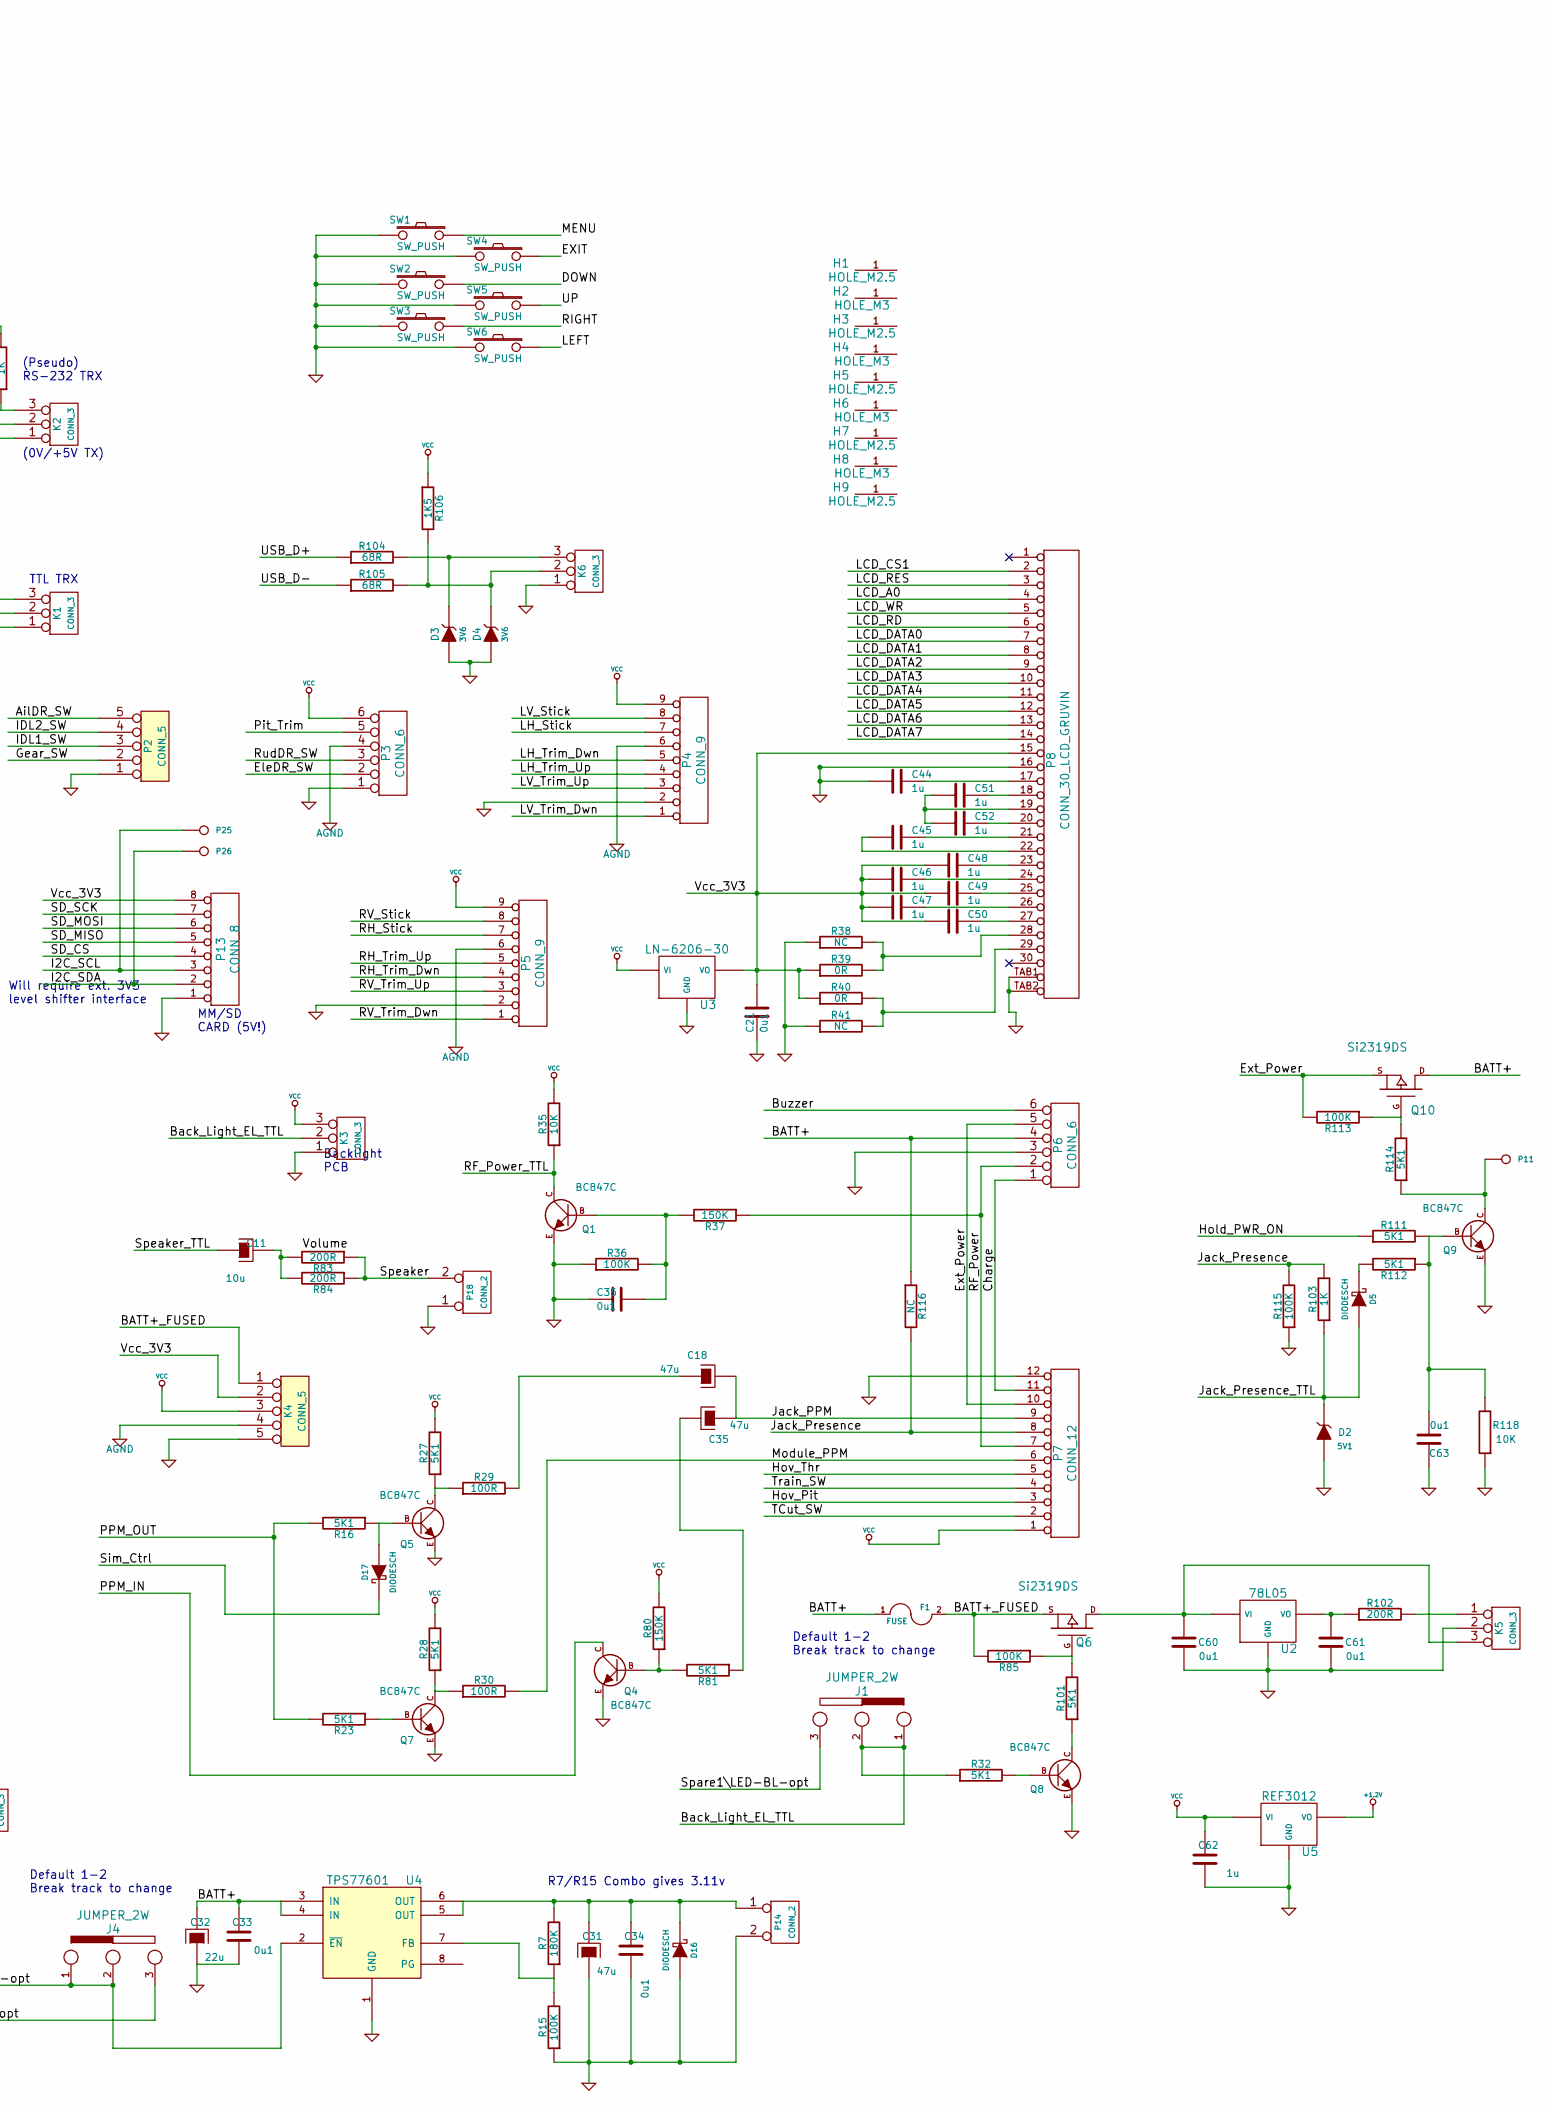
[picture p63: schematic gruvin9x.sch, part in row 1, column 2]

Parts:
C1, C11: 10u
C2, C3, C4, C5, C6, C7, C8, C9, C10, C15, C17, C19, C20, C21, C22, C23, C24, C25, C26, C27, C28, C29, C30, C33, C34, C36, C37, C38, C39, C40, C41, C42, C43, C53, C54, C55, C56, C57, C58, C59, C60, C61, C63, C64, C65, C91, C92, C93, C94, C95, C96: 0u1
C12, C18, C31, C35: 47u
C13, C14: 18p
C16, C44, C45, C46, C47, C48, C49, C50, C51, C52, C62: 1u
C32: 22u
D1: DIODESIL
D2: 5V1
D3, D4: 3V6
D5, D16, D17: DIODESCH
F1: FUSE
H1, H3, H5, H7, H9: HOLE_M2.5
H2, H4, H6, H8: HOLE_M3
IC1: ATMEGA2560-A_GRUVIN; TQFP100
J1, J4: JUMPER_2W
K1, K2, K3, K5, K6: CONN_3
K4: CONN_5
L1, L2: 10u
P1: CONN_3X2
P2: CONN_5
P3, P6: CONN_6
P4, P5: CONN_9
P7: CONN_12
P8: CONN_30_LCD_GRUVIN
P9, P11, P23, P24, P25, P26: CONN_1
P10: CONN_5X2
P12, P15: CONN_4
P13, P20: CONN_8
P14: CONN_2
P18: CONN_2; CONN_2MM_2x1
P21: CONN_3
Q1, Q2, Q4, Q5, Q7, Q8, Q9: BC847C; SOT23-BCE
Q3: BC857C; SOT23-BCE
Q6, Q10: Si2319DS
R1, R16, R17, R23, R27, R28, R32, R33, R42, R43, R44, R45, R50, R51, R52, R53, R58, R59, R60, R61, R62, R69, R72, R74, R77, R81, R101, R107, R108, R109, R110, R111, R112, R114: 5K1
R2: 2K7
R3, R4, R5, R6, R8, R9, R10, R11, R12, R13, R14, R18, R19, R20, R21, R22, R24, R26, R68, R70, R71, R78, R83, R84, R86, R87, R88, R89, R90, R91, R92, R93, R94, R95, R96, R97, R98, R99, R100, R102: 200R
R7: 180K
R15, R36, R85, R113, R115: 100K
R25, R35, R46, R47, R48, R49, R54, R55, R56, R57, R63, R64, R65, R66, R67, R118: 10K
R29, R30: 100R
R31, R34, R79: 10K2
R37, R80: 150K
R38, R41, R116: NC
R39, R40: 0R
R73, R75, R82, R103, R117: 1K
R76: 3K9
R104, R105: 68R
R106: 1K5
SW1, SW2, SW3, SW4, SW5, SW6: SW_PUSH
U1, U2: 78L05; SOT89
U3: LN-6206-30; SOT89
U4: TPS77601
U5: REF3012; SOT89
X1: 16MHz

Connections:
+1.2V: R24.1, U5.VO
AGND: C2.2, C3.2, C4.2, C5.2, C7.2, C8.2, C9.2, C10.2, C17.1, C20.2, IC1.99 (GND_(AGND)), K4.4, L2.2, P3.4, P4.6, P5.6
AVCC: C17.2, IC1.100 (AVCC), L1.1
AilDR_SW: C26.1, P2.5, R71.1
BATT+: C1.2, C6.2, C32.2, C33.2, F1.1, P6.4, Q10.D, R1.1, R116.1, U1.VI, U4.3 (IN), U4.4 (IN)
BATT+_FUSED: F1.2, K4.1, Q6.S, R85.2
Back_Light_EL_TTL: IC1.53 ((A8)PC0), J1.1, J1.2, K3.2 (PM), R32.1
Battery: C10.1, R1.2, R2.1, R12.2
Buzzer: P6.6, R82.2
Charge: P6.1, P7.11
DOWN: C37.1, R97.2, SW2.1
DOWN_P: IC1.35 (PL0(ICP4)), R97.1
EXIT: C41.1, R22.2, SW4.1
EXIT_P: IC1.40 (PL5(OC5C)), R22.1
EleDR_SW: C23.1, P3.2, R18.2
Ext_Power: P6.5, P7.10, Q10.S, R113.2
FB_CLOCK: C13.1, IC1.33 (XTAL2), P9.1, X1.1
GND: C1.1, C6.1, C12.1, C13.2, C14.2, C15.1, C16.1, C19.2, C21.2, C22.2, C23.2, C24.2, C25.2, C26.2, C27.2, C28.2, C29.2, C30.2, C31.1, C32.1, C33.1, C34.1, C36.2, C37.2, C38.2, C39.2, C40.2, C41.2, C42.2, C43.2, C44.2, C53.2, C54.2, C55.2, C56.2, C57.2, C58.2, C59.2, C60.1, C61.1, C62.1, C63.1, C64.2, C65.1, C91.2, C92.2, C93.2, C94.2, C95.2, C96.2, D1.1 (A), D2.1 (A), D3.1 (A), D4.1 (A), D16.1 (A), IC1.11 (GND), IC1.32 (GND), IC1.62 (GND), IC1.81 (GND), K1.1, K2.1, K3.1, K4.5, K5.2 (PM), K6.1, L2.1, P1.6, P2.1, P3.1, P4.2, P5.2, P6.3, P7.12, P8.16, P8.TAB1, P8.TAB2, P10.2, P10.10, P12.1, P13.1, P14.2 (PM), P15.1, P18.1, P20.1, Q1.E, Q2.E, Q4.E, Q5.E, Q7.E, Q8.E, Q9.E, R2.2, R15.1, R17.1, R33.1, R36.1, R38.1, R41.1, R46.1, R47.1, R48.1, R49.1, R54.1, R55.1, R56.1, R57.1, R63.1, R64.1, R65.1, R66.1, R67.1, R72.2, R76.1, R77.1, R115.1, R118.1, SW1.2, SW2.2, SW3.2, SW4.2, SW5.2, SW6.2, U1.GND, U2.GND, U3.GND, U4.1 (GND), U5.GND
Gear_SW: C24.1, P2.2, R19.2
Hold_PWR_ON: IC1.42 (PL7), R111.1
Hov_Pit: C4.1, P7.3, R5.2
Hov_Thr: C9.1, P7.5, R11.2
I2C_SCL: IC1.43 ((SCL/INT0)PD0), P13.3, P25.1
I2C_SDA: IC1.44 ((SDA/INT1)PD1), P13.2, P26.1
IDL1_SW: C25.1, P2.3, R26.2
IDL2_SW: C29.1, P2.4, R20.2
JTAG_TCK: IC1.93 ((TCK/ADC4)PF4), P10.1
JTAG_TDI: IC1.90 ((TDI/ADC7)PF7), P10.9
JTAG_TDO: IC1.91 ((TD0/ADC6)PF6), P10.3
JTAG_TMS: IC1.92 ((TMS/ADC5)PF5), P10.5
Jack_PPM: C18.2, C35.1, P7.9
Jack_Presence: P7.8, R103.2, R115.2, R116.2
Jack_Presence_TTL: D2.2 (K), D5.1 (A), IC1.41 (PL6), R103.1
LCD_A0: P8.4, R61.1, R64.2
LCD_CS1: P8.2, R60.1, R63.2
LCD_DATA0: P8.7, R42.1, R46.2
LCD_DATA1: P8.8, R50.1, R54.2
LCD_DATA2: P8.9, R43.1, R47.2
LCD_DATA3: P8.10, R51.1, R55.2
LCD_DATA4: P8.11, R44.1, R48.2
LCD_DATA5: P8.12, R52.1, R56.2
LCD_DATA6: P8.13, R45.1, R49.2
LCD_DATA7: P8.14, R53.1, R57.2
LCD_RD: P8.6, R62.1, R65.2
LCD_RES: P8.3, R58.1, R66.2
LCD_WR: P8.5, R59.1, R67.2
LEFT: C54.1, R88.2, SW6.1
LEFT_P: IC1.38 (PL3(OC5A)), R88.1
LH_Dwn_P: IC1.63 (PJ0(RXD3/PCINT9)), R90.1
LH_Stick: C8.1, P4.7, R10.2
LH_Trim_Dwn: C56.1, P4.5, R90.2
LH_Trim_Up: C40.1, P4.4, R100.2
LH_Up_P: IC1.64 (PJ1(TXD3/PCINT10)), R100.1
LV_Dwn_P: IC1.65 (PJ2(XCK3/PCINT11)), R89.1
LV_Stick: C3.1, P4.8, R9.2
LV_Trim_Dwn: C55.1, P4.1, R89.2
LV_Trim_Up: C39.1, P4.3, R99.2
LV_Up_P: IC1.66 (PJ3(PCINT12)), R99.1
MENU: C57.1, R13.2, SW1.1
MENU_P: IC1.39 (PL4(OC5B)), R13.1
Module_PPM: P7.6, R30.2
unnamed: C11.2, R83.2, R84.2
unnamed: C14.1, IC1.34 (XTAL1), X1.2
unnamed: C18.1, R29.2
unnamed: C20.1, IC1.98 (AREF)
unnamed: C31.2, C34.2, D16.2 (K), P14.1, R7.2, U4.5 (OUT), U4.6 (OUT)
unnamed: C35.2, R81.1
unnamed: C36.1, Q1.B, R36.2, R37.2
unnamed: C44.1, P8.17
unnamed: C45.1, P8.21
unnamed: C45.2, P8.22
unnamed: C46.1, P8.24
unnamed: C47.1, P8.26
unnamed: C48.1, P8.23
unnamed: C49.1, P8.25
unnamed: C50.1, P8.27
unnamed: C51.1, P8.18
unnamed: C51.2, C52.2, P8.19
unnamed: C52.1, P8.20
unnamed: C60.2, K5.3, Q6.D, U2.VI
unnamed: C61.2, R102.1, U2.VO
unnamed: C63.2, Q9.B, R111.2, R112.1, R118.2
unnamed: D1.2 (K), Q2.B, R72.1, R74.2
unnamed: D3.2 (K), K6.3, R104.2
unnamed: D4.2 (K), K6.2 (PM), R105.2, R106.2
unnamed: D5.2 (K), R112.2
unnamed: D17.1 (A), Q5.B, R16.1
unnamed: IC1.1 (PG5(OCOB)), R19.1
unnamed: IC1.5 ((OC3A/AIN1)PE3), R82.1
unnamed: IC1.12 (PH0(RXD2)), P20.3
unnamed: IC1.13 (PH1(TXD2)), P20.4
unnamed: IC1.15 (PH3(OC4A)), P20.6
unnamed: IC1.16 (PH4(OC4B)), P20.7
unnamed: IC1.17 (PH5(OC4C)), P20.8
unnamed: IC1.18 (PH6(OC2B)), P20.9
unnamed: IC1.23 ((PCINT4/OC2A)PB4), R20.1
unnamed: IC1.24 ((PCINT5/OC1A)PB5), R8.1
unnamed: IC1.27 (PH7(T4)), P20.10
unnamed: IC1.28 (PG3(TOSC2)), R26.1
unnamed: IC1.51 (PG0(~WR~)), R68.1
unnamed: IC1.54 ((A9)PC1), R60.2
unnamed: IC1.55 ((A10)PC2), R58.2
unnamed: IC1.56 ((A11)PC3), R61.2
unnamed: IC1.57 ((A12)PC4), R59.2
unnamed: IC1.58 ((A13)PC5), R62.2
unnamed: IC1.59 ((A14)PC6), R18.1
unnamed: IC1.60 ((A15)PC7), R71.2
unnamed: IC1.70 (PG2(ALE)), R70.1
unnamed: IC1.71 ((AD7)PA7), R53.2
unnamed: IC1.72 ((AD6)PA6), R45.2
unnamed: IC1.73 ((AD5)PA5), R52.2
unnamed: IC1.74 ((AD4)PA4), R44.2
unnamed: IC1.75 ((AD3)PA3), R51.2
unnamed: IC1.76 ((AD2)PA2), R43.2
unnamed: IC1.77 ((AD1)PA1), R50.2
unnamed: IC1.78 ((AD0)PA0), R42.2
unnamed: IC1.82 (PK7(ADC15/PCINT23)), R12.1
unnamed: IC1.83 (PK6(ADC14/PCINT22)), R6.1
unnamed: IC1.84 (PK5(ADC13/PCINT21)), R11.1
unnamed: IC1.85 (PK4(ADC12/PCINT20)), R5.1
unnamed: IC1.86 (PK3(ADC11/PCINT19)), R10.1
unnamed: IC1.87 (PK2(ADC10/PCINT18)), R4.1
unnamed: IC1.88 (PK1(ADC9/PCINT17)), R9.1
unnamed: IC1.89 (PK0(ADC8/PCINT16)), R3.1
unnamed: IC1.94 ((ADC3)PF3), R24.2
unnamed: IC1.95 ((ADC2)PF2), R77.2, R79.2
unnamed: IC1.96 ((ADC1)PF1), R33.2, R34.2
unnamed: IC1.97 ((ADC0)PF0), R17.2, R31.2
unnamed: K2.2 (PM), R74.1
unnamed: K2.3, R75.1
unnamed: K5.1, R102.2
unnamed: P8.28, R38.2, R39.2
unnamed: P8.29, R40.2, R41.2
unnamed: P11.1, Q9.C, R114.1
unnamed: P12.2, R95.1
unnamed: P12.3, R96.1
unnamed: P12.4, R93.1
unnamed: P15.2, R91.1
unnamed: P15.3, R92.1
unnamed: P15.4, R94.1
unnamed: P21.1, R31.1
unnamed: P21.2 (PM), R34.1
unnamed: P21.3, R79.1
unnamed: Q3.B, R73.1, R117.2
unnamed: Q3.C, R75.2, R76.2
unnamed: Q4.B, R80.1, R81.2
unnamed: Q5.C, R27.1, R29.1
unnamed: Q6.G, R85.1, R101.2
unnamed: Q7.B, R23.1
unnamed: Q7.C, R28.1, R30.1
unnamed: Q8.B, R32.2
unnamed: Q8.C, R101.1
unnamed: Q10.G, R113.1, R114.2
unnamed: R7.1, R15.2, U4.7 (FB)
PPM_IN: IC1.9 ((CLKO/ICP3/INT7)PE7), Q4.C
PPM_OUT: IC1.25 ((PCINT6/OC1B)PB6), R16.2, R23.2
Pit_Trim: C5.1, P3.5, R6.2
RESET: C16.2, IC1.30 (~RESET), P1.5, P10.6, R25.2
RF_Power: P6.2, P7.7, R37.1
RF_Power_TTL: IC1.52 (PG1(~RD~)), Q1.C, R35.1
RH_Dwn_P: IC1.69 (PJ6(PCINT15)), R14.1
RH_Stick: C2.1, P5.7, R3.2
RH_Trim_Dwn: C58.1, P5.4, R14.2
RH_Trim_Up: C42.1, P5.5, R78.2
RH_Up_P: IC1.79 (PJ7), R78.1
RIGHT: C38.1, R98.2, SW3.1
RIGHT_P: IC1.37 (PL2(T5)), R98.1
ROT_ENC_1_A: C95.1, IC1.7 ((OC3C/INT5)PE5), R95.2, R107.2
ROT_ENC_1_B: C96.1, IC1.8 ((T3/INT6)PE6), R96.2, R109.2
ROT_ENC_1_PUSH: C93.1, IC1.47 ((ICP1)PD4), R93.2
ROT_ENC_2_A: C91.1, IC1.45 ((RXD1/INT2)PD2), R91.2, R108.2
ROT_ENC_2_B: C92.1, IC1.46 ((TXD1/INT3)PD3), R92.2, R110.2
ROT_ENC_2_PUSH: C94.1, IC1.48 ((XCK1)PD5), R94.2
RV_Dwn_P: IC1.67 (PJ4(PCINT13)), R21.1
RV_Stick: C7.1, P5.8, R4.2
RV_Trim_Dwn: C59.1, P5.1, R21.2
RV_Trim_Up: C43.1, P5.3, R86.2
RV_Up_P: IC1.68 (PJ5(PCINT14)), R86.1
RudDR_SW: C27.1, P3.3, R68.2
SD_CS: IC1.19 ((PCINT0/~SS~)PB0), P13.4
SD_MISO: IC1.22 ((PCINT3/MISO)PB3), P1.1, P13.5
SD_MOSI: IC1.21 ((PCINT2/MOSI)PB2), P1.4, P13.6
SD_SCK: IC1.20 ((PCINT1/SCK)PB1), P1.3, P13.7
Sim_Ctrl: D17.2 (K), IC1.29 (PG4(TOSC1))
Spare1\LED-BL-opt: IC1.49 ((T1)PD6), J1.3, P24.1
Spare2\Vib-opt: IC1.50 ((T2)PD7), J4.1, J4.2, P23.1, U4.2 (~EN)
Speaker: P18.2 (PM), R83.1, R84.1
Speaker_TTL: C11.1, IC1.26 ((PCINT7/OC0A/OC1C)PB7)
TCut_SW: C22.1, P7.2, R70.2
TELEM_RX: IC1.2 ((PCINT8/RXD0)PE0), K1.2 (PM), Q2.C, R69.2
TELEM_TX: IC1.3 ((TXD0)PE1), K1.3, R73.2
Train_SW: C28.1, P7.4, R8.2
UP: C53.1, R87.2, SW5.1
UP_P: IC1.36 (PL1(ICP5)), R87.1
USB_D+: IC1.6 ((OC3B/INT4)PE4), R104.1
USB_D-: IC1.4 ((XCK0/AIN0)PE2), R105.1
VCC: C12.2, C15.2, C19.1, C30.1, C62.2, C64.1, C65.2, IC1.10 (VCC), IC1.31 (VCC), IC1.61 (VCC), IC1.80 (VCC), K3.3, K4.3, L1.2, P1.2, P3.6, P4.9, P5.9, P7.1, P10.4, P10.7, P20.2, Q3.E, R25.1, R27.2, R28.2, R35.2, R69.1, R80.2, R106.1, R107.1, R108.1, R109.1, R110.1, R117.1, U1.VO, U3.VI, U5.VI
Vcc_3V3: C21.1, C46.2, C47.2, C48.2, C49.2, C50.2, K4.2, P8.15, P13.8, R39.1, R40.1, U3.VO
Vib-PWM-opt: IC1.14 (PH2(XCK2)), J4.3, P20.5

Notes on the sheet:
Default 1-2 Break track to change
MCU pin 11
MCU pin 10
R7/R15 Combo gives 3.11v
JTAG Header
Backlight PCB
Will require ext. 3V3 level shifter interface
MM/SD CARD (5V!)
(0V/+5V TX)
TTL TRX
(Pseudo) RS-232 TRX
SPI Programming Header
