sylvandb/gruvin9x/hardware/pcb/sdcard-uk.sch

## KiCad design hardware/pcb/sdcard-uk.sch (2012-02-15)

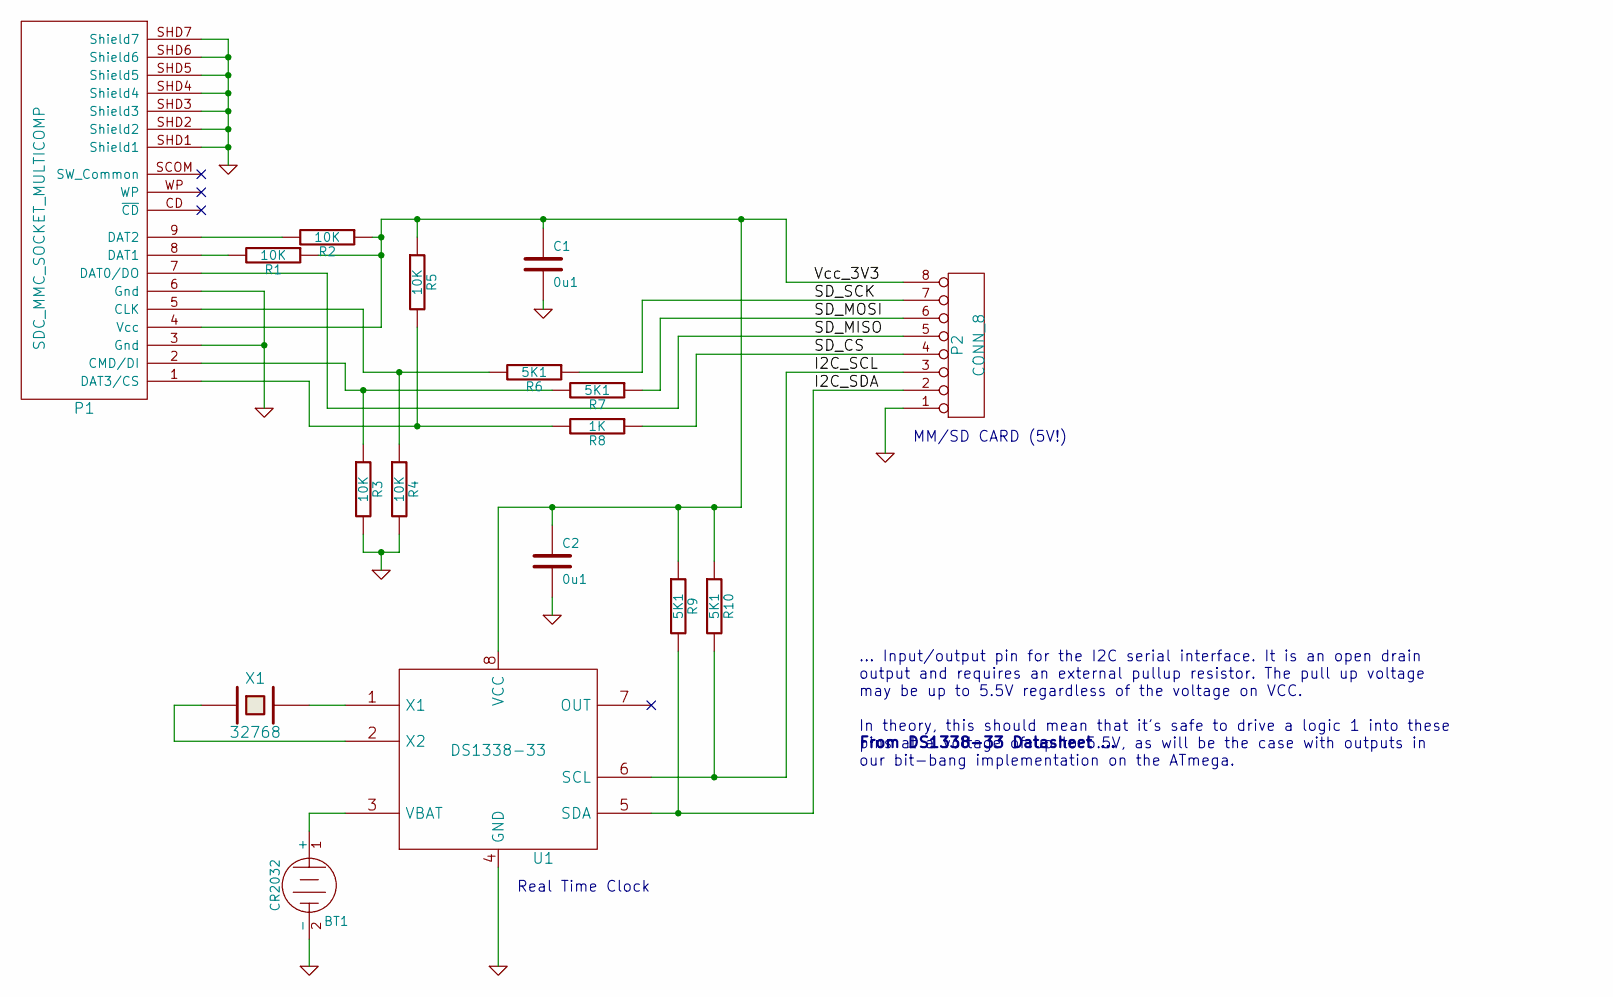
[picture p64: schematic sdcard-uk.sch]

Parts:
BT1: CR2032
C1, C2: 0u1
P1: SDC_MMC_SOCKET_MULTICOMP
P2: CONN_8
R1, R2, R3, R4, R5: 10K
R6, R7, R9, R10: 5K1
R8: 1K
U1: DS1338-33
X1: 32768

Connections:
GND: BT1.2 (-), C1.2, C2.2, P1.3 (Gnd), P1.6 (Gnd), P1.SHD1 (Shield1), P1.SHD2 (Shield2), P1.SHD3 (Shield3), P1.SHD4 (Shield4), P1.SHD5 (Shield5), P1.SHD6 (Shield6), P1.SHD7 (Shield7), P2.1, R3.2, R4.2, U1.4 (GND)
I2C_SCL: P2.3, R10.2, U1.6 (SCL)
I2C_SDA: P2.2, R9.2, U1.5 (SDA)
unnamed: BT1.1 (+), U1.3 (VBAT)
unnamed: P1.1 (DAT3/CS), R5.2, R8.2
unnamed: P1.2 (CMD/DI), R3.1, R7.2
unnamed: P1.5 (CLK), R4.1, R6.2
unnamed: P1.8 (DAT1), R1.2
unnamed: P1.9 (DAT2), R2.2
unnamed: U1.1 (X1), X1.2
unnamed: U1.2 (X2), X1.1
SD_CS: P2.4, R8.1
SD_MISO: P1.7 (DAT0/DO), P2.5
SD_MOSI: P2.6, R7.1
SD_SCK: P2.7, R6.1
Vcc_3V3: C1.1, C2.1, P1.4 (Vcc), P2.8, R1.1, R2.1, R5.1, R9.1, R10.1, U1.8 (VCC)

Notes on the sheet:
From DS1338-33 Datasheet ...
... Input/output pin for the I2C serial interface. It is an open drain output and requires an external pullup resistor. The pull up voltage may be up to 5.5V regardless of the voltage on VCC. In theory, this should mean that it's safe to drive a logic 1 into these pins at a voltage of up to 5.5V, a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
Real Time Clock
MM/SD CARD (5V!)
