sylvandb/gruvin9x/firmware/src/logs.cpp

/*
 * Authors (alphabetical order)
 * - Bertrand Songis <bsongis@gmail.com>
 * - Bryan J. Rentoul (Gruvin) <gruvin@gmail.com>
 *
 * Original contributors
 * - Philip Moss Adapted first frsky functions from jeti.cpp code by
 * - Karl Szmutny <shadow@privy.de>

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
 */

#include "logs.h"

char g_logFilename[13]; // 8+dot+3+null
char g_logErrorStr[22] = { 0 };
int8_t g_telemLogState = 0;
FATFS g_FATFS_Obj;
FIL g_oLogFile;
char logFullPath[21]; 

// initTelemLog: Determine and set telemetry log filename
void initTelemLog() // pers.cpp -- after loading model data
{
  FRESULT result;

  // close any file left open. E.G. Changing models with log switch still on.
  if (g_oLogFile.fs) f_close(&g_oLogFile);
  g_telemLogState = 0;

  strcpy_P(g_logFilename, PSTR("M00_000.CSV")); // filename only.

  // Set log file model number
  uint8_t num = g_eeGeneral.currModel + 1;
  char *n = &g_logFilename[2];
  *n = (char)((num % 10) + '0');
  *(--n) = (char)((num / 10) + '0');

  // Loop, skipping over any existing log files ... _000, _001, etc. until we have a unique file name
  result = f_mount(0, &g_FATFS_Obj);
  if (result!=FR_OK)
  {
    strcpy_P(g_logErrorStr, PSTR("SDCARD F/S ERROR"));
    g_telemLogState = -result;
    return;
  }
  while (1)
  {
    strcpy(logFullPath, TELEM_LOG_PATH);
    strcat(logFullPath, "/");
    strcat(logFullPath, g_logFilename);

    result = f_open(&g_oLogFile, logFullPath, FA_OPEN_EXISTING | FA_READ);
    if (result == FR_OK)
    {
      f_close(&g_oLogFile);
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
