sylvandb/gruvin9x/(commit log)

2011-10-05 Addition of soft off switch to PCB V4.1 This will allow better EEPROM management as the CPU gets to say when the power is switched off, like the DX6i, DX8, Multiplex MC4000 etc.
    [V4 BOM.xls, gruvin9x.brd, gruvin9x.sch]
2011-10-05 Just renaming a few nets to more sensible names
    [gruvin9x.brd, gruvin9x.sch]
2011-10-10 V4.1 PCB change to allow soft off to be bypassed if it turns out to a duff mod.
    [gruvin9x.brd, gruvin9x.sch]
2011-10-12 A couple of small changes to V4.1, mainly track thickening, and silkscreen tidy. Going to do one last via check then we are done. Have double and triple checked the changes from V4.0 and they all loo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
    [gruvin9x.brd, gruvin9x.sch]
2011-10-12 Final via additions here and there to V4.1 and addition of gerbers.
    [V4 BOM.xls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]
2011-10-14 Potential V4.1 changes for Bryan to check out.
    [V4 BOM.xls, gruvin9x.brd, gruvin9x.sch]
2011-10-17 Only frozen PCB versions should have gerbers and assembly files.
    [gruvin9x-Mask_Back.gbs, gruvin9x-Mask_Front.gts, gruvin9x-PCB_Edges.gbr, gruvin9x-SilkS_Back.gbo, gruvin9x-SilkS_Front.gto, gruvin9x-SoldP_Back.gbp, gruvin9x-SoldP_Front.gtp, gruvin9x.drl]
2011-10-17 Just correcting a couple of PCB readme.txt errors and a little neatening.
2011-10-21 Very first draft of the new Rx de-multiplexer board. This is designed for model boat people to enable them to split one channel into eight at the expense of latency.
    It has 8 outputs to drive servos, and 8 500mA digital outputs (of which 4 are PPM capable). It will only be an 8 channel de-multiplexer so servo output 1 and digital output 1 will be controlled by the same input, etc.
    I have done it this way to avoid having to have a de-multiplexer board for digital and one for servos.
    You can drive the digital and servo outputs from the Rx battery or another battery, selected via switches.
    This design may change a lot at this stage, it needs to be tested, and so far no firmware exists !
    TOD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
    [g9x_rx_mpx.brd, g9x_rx_mpx.sch]
2011-10-23 Update to Rx MPX board. Moved switches, and altered ordering on a couple of the connectors to keep them all the same.
    [g9x_rx_mpx.brd, g9x_rx_mpx.sch]
2011-10-31 A little rename of files in the truck PCB directory so when alphabetically listed files for the same PCB stay together Talked about ages ago, and then I forgot.
    [V4 BOM.xls, gruvin9x-bom.xls, sdcard(uk+std)-bom.xls, sdcard-uk.brd, sdcard-uk.sch]
2011-11-02 Couple of pin changes to the Rx deMUX board
    [g9x_rx_mpx.brd, g9x_rx_mpx.sch]
2011-11-02 Rx DEMUX board getting closer . Tidied up the schematic . Added fuses . Via-ed the GND pours . Tidied the silkscreen . Also have some working code for testing the hardware PPM decode and encode
    [g9x_rx_mpx.brd, g9x_rx_mpx.sch]
2011-11-07 Port frsky branch to trunk so that trunk is the current up to date repo. frsky branch is now a maintenance only branch.
2011-11-08 Correction for issue 69 ported in trunk. The other bug in DR/EXPOS screen will follow to-morrow.
    [gruvin9x.cpp]
2011-11-14 BOM update. It appears Digikey had changed the 5v reg link. Still the same part though.
    [gruvin9x-bom.xls]
2011-11-16 I rename the 2 pointers to pulses2MHz array: pulses2MHzWPtr for write (producer), pulses2MHz for read (and send to OCR1A/OCR1B, consumer). And I changed the condition for filling again the array (don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
    [pulses.cpp]
2011-11-17 Problem in EEPROM format: it was impossible to reach 16 PPM channels.
    [myeeprom.h, pers.cpp]
2011-11-18 Some RAM saved in getADC functions (port from er9x). Work preparation for the 2nd timer. Reverse throttle issue 14 solved. Bug in mixer delays. PPM frame length configurable.
    [gruvin9x.cpp, lcd.cpp, lcd.h, main_views.cpp, model_menus.cpp, myeeprom.h, pers.cpp, pulses.cpp]
2011-11-19 Gruvin9x issue 73 solved
    [model_menus.cpp]
2011-11-19 Rotary encoders values displayed in DIAG screen. Some changes on DSM2.
2011-11-21 It should better with this sei(), as it enables interrupts sooner
2011-11-21 Revert the ASM code before Bryan gets up ;) Some more changes in DSM2 code for Cam
    [pulses.cpp]
2011-11-22 Smooth transition between flight phases was not working. Default flight mode is called FP0, not FP1.
    [gruvin9x.cpp, lcd.cpp]
2011-11-23 Work on converting Jim's USBasp programmer to KiCAD.
    Schematic completed. PCB to do.
    [gprog.sch]
2011-11-23 Minor correction to GPRO v1.0 Schematic and component library.
    [gprog.sch]
2011-11-24 As advised by JWB, corrected GPROG (USBasp) programmer circuit.
    Only pull-up D- to tell USB host we are a slow speed device. Changed resistor
    to 3K6 from 5K6 for better voltage matching, in theory.
    [gprog.sch]
2011-11-24 Some (evident after a good night) errors in COPY / MOVE operations on models.
    [model_menus.cpp]
2011-11-25 Issues with current model during copy / move operations in MODELSEL menu.
    [file.cpp, gruvin9x.cpp, gtests.cpp, model_menus.cpp, pers.cpp]
2011-11-25 EEPROM async write on simu... the remaining bug has been tracked and found with it.
    [drivers.cpp, file.cpp, file.h, gruvin9x.h, gtests.cpp, menus.h, simpgmspace.cpp, simpgmspace.h]
2011-11-26 Completed draft 1 of gprog KiCAD version PCB.
    [$savepcb.brd, gprog.brd, gprog.sch]
2011-11-26 Added gprog draft BOM spreadsheet.
    Added sleep to Gruvin's life. (Hoping it will be faster sleep than normal, so as
    to catch up on yesterday's lack.)
    [gprog_v1-0_bom.xls]
2011-11-26 gPROG: Fixed errors in schematic. Completed PCB to 'final draft'.
    [$savepcb.brd, gprog.brd, gprog.sch]
2011-11-26 gPROG: Corrected error in PCB edge/size.
    [gprog.brd]
2011-11-26 gPROG: Fixed more errors on PCB.
    [$savepcb.brd, gprog.brd]
2011-11-26 gPROG: Tidied up PCB some more. Schematic had not been saved prior to previous commits. :-/
    [gprog.brd, gprog.sch]
2011-11-27 gPROG: Dare I say the last, final draft.
    [$savepcb.brd, gprog.brd, gprog.sch]
2011-11-27 gPROG: Definitely not the final version. How could it be? It never is. :-/
    (Lower right screw hole was too close to board edge. Extended edge down slightly.
    [gprog.brd]
2011-11-29 Increased bandgap reference read delay for stock 9Xs. See Issue 76
    [gruvin9x.cpp]
2011-11-29 Issue 78 hopefully solved
    [gruvin9x.cpp]
2011-12-01 Update trunk fuses.txt per frsky r1293
2011-12-03 Simu for V4. First draft of rotary encoders use in menus
2011-12-03 Throttle expo feature removed. If really needed, there are plenty of other ways to achieve it.
2011-12-08 Issue 81 (part1: the switches not displayed in alternate views) solved
    [main_views.cpp]
2011-12-08 Minor changes to avoid infinite loops inside companion9x
    [gruvin9x.cpp, simpgmspace.cpp, simpgmspace.h]
2011-12-08 Issue 80 solved. To be improved later in trunk.
    [gruvin9x.cpp]
2011-12-09 Set PORTL[7:6] to output/input respectively to allow Hold_PWR_On circuit to function. (Also to allow the power to be switched off when soft-off support code not yet present. :-)
    Some other files in this commit have changed since my last upload. Nothing of any importance though.
    Merry Winter Soltice! :-P
    [$savepcb.brd, gprog.brd]
2011-12-09 This lbm for v4 was not commited when the stock one was. I choose the easiest way: both commited. Bryan, what do you think? at the moment I think you will set some negative comment ;) No problem, in 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
2011-12-09 Solved regressions introduced when working on rotary encoders
    [model_menus.cpp]
2011-12-10 Last lines of SETUP 1/10 were buggy
    [model_menus.cpp, simpgmspace.cpp, simpgmspace.h]
2011-12-12 Non regression test for 0 division issue in flight phases switch
    [gtests.cpp, simpgmspace.cpp, simpgmspace.h, simu.cpp]
2011-12-12 Rotary encoder should be ok in MODELSEL, SETUP and FLIGHT PHASES pages.
2011-12-13 Major changes to gprog, after prototype revealed multiple problems. Also reverted to TQFP-32 package instead of QFN/MLF.
    [$savepcb.brd, gprog.brd, gprog.sch]
2011-12-13 GPROG: Oops. Missed a +5V trace under IC1
    [gprog.brd]
2011-12-13 GPROG: "Final" tinkerings. This version awaits comment by Jim before possibly ordering first KiCAD based prototype boards.
    [gprog.brd, gprog.sch]
2011-12-13 GPROG: Error in R8 corrected.
    [gprog.brd, gprog.sch]
2011-12-13 The last warnings removed! Also ported to stable branch in case it remains the stable version for long, the counter was not started since my last bug correction commited ;)
    [lcd.cpp, lcd.h]
2011-12-13 GPROG: Update D7 for larger current handling. 1.1A ought to do it. Personally, I will not install this component anyway. But the option is there and the pads will accept smaller versions if desired.
    [gprog.brd, gprog.sch, gprog_v1-0_bom.xls]
2011-12-13 GPROG: minor change to PCB layout.
    [gprog.brd]
2011-12-13 GPROG: Added the USB-B mini connector board/adapter. Bumped schematic revision number to 1.0. We'll run with this one.
    [gprog.brd]
2011-12-14 GPROG: Minor fixes, sorted component labelling etc.
    [gprog.brd, gprog.sch]
2011-12-14 Added a SIMU_EXCEPTIONS definition for allowing asserts (and on Linux all SIGFPE/SIGSGF ...) to be displayed in c9x as errors in a MessageBox. It's better than crashing the whole tool and will allow 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
    [simpgmspace.cpp, simpgmspace.h]
2011-12-15 GPROG: Minor changes to board layout. BOM completed for element14. DigiKey parts not completed.
    [gprog.brd, gprog.sch, gprog_v1-0_bom.xls]
2011-12-15 GPROG: Changed USB socket board so wires fit in available slot in battery compartment. Updated BOM with hugely cheaper way to get the socket-to-main-board connector cable. (How does Jim find these th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
    [gprog.brd, gprog_v1-0_bom.xls]
2011-12-20 GPROG: Auxilary access corrected for Gerber output. Production files generated and sent to supplier for 40-off quote.
    [gprog-Back.gbl, gprog-Front.gtl, gprog-Mask_Back.gbs, gprog-Mask_Front.gts, gprog-PCB_Edges.gbr, gprog-SilkS_Back.gbo, gprog-SilkS_Front.gto, gprog-SoldP_Back.gbp]
2011-12-22 Adjusted present-day trunk/pcb to allign with changes made to pcb-v4.1-frozen (local working copy) during my last time-machine trip. Confused? Well, just know that the 'frozen' folder was, in effect,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
    [gruvin9x.brd, gruvin9x.sch]
2011-12-22 The final, final gprog board layout.
    Thicken VCC and GND tracks on USB connector board and pin 2 of x48 ISP pad block.
    [gprog-Back.gbl, gprog-Front.gtl, gprog-Mask_Back.gbs, gprog-Mask_Front.gts, gprog-PCB_Edges.gbr, gprog-SilkS_Back.gbo, gprog-SilkS_Front.gto, gprog-SoldP_Back.gbp]
2011-12-22 ITead ask for a drill.txt file, not blah.drl. So Ive tried to comply.
2011-12-22 GPROG: Final, final, final boar dlay-out. Spto the change and you wina prize prize! :-P (No cheating!)
    [gprog-Back.gbl, gprog-Front.gtl, gprog-Mask_Back.gbs, gprog-Mask_Front.gts, gprog-PCB_Edges.gbr, gprog-SilkS_Back.gbo, gprog-SilkS_Front.gto, gprog-SoldP_Back.gbp]
2011-12-23 gprog: OK. I give up. This is probably still not the final. But it will get frozen soon, once I've sent the actual order off. :-D +5V tracks for MCU widened. COuple of vias moved to give better clear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
    bootloader: Must have forgotten to commit the v4.1 soft-off patch. Here it is.
    [gprog.brd]
2011-12-25 gprog: This won't be the final version. No way. Not gonna happen. There'll be more changes, for sure.
    Moved a via slightly further away from a widened track.
    [gprog.brd]
2011-12-26 GPROG: version 1.00 has finally been frozen and sent to factory for fabrication. Let's hope I didn't mess anything up.
    [gprog-Back.gbl, gprog-Front.gtl, gprog-Mask_Back.gbs, gprog-Mask_Front.gts, gprog-PCB_Edges.gbr, gprog-SilkS_Back.gbo, gprog-SilkS_Front.gto, gprog-SoldP_Back.gbp]
2012-01-01 FRSKY screens on simu: errors solved
    [gruvin9x.cpp]
2012-01-04 DSM2 delay between frames (added and tested by Cam!). Cam I changed only these few things: - stopPulses function removed (we always need the ISR now) - a startPulses was remaining in eeLoadModel - so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
2012-01-04 The er9x expos conversions were wrong. Thanks to gbirkus for his tests!
    [pers.cpp]
2012-01-05 Winged Shadow How High.
2012-01-07 Logs activated in Function Switches screen (I promised it a waaay ago!)
2012-01-09 Correction to lfuse 'default' value (bit 7 of lfuse was inverted.) Thanks to Martial Guex for the heads up!
    (I've actually changed it from 62 to 0xd7. I cannot fathom now where 0x62 came
    from. Perhaps other inverted bits. In any case, 0xd7 is what I use.)
    No actual changes to gprog.brd. Ignore it for this commit.
    [gprog.brd]
2012-01-09 DSM2 - APM dsm2_bind[] array should be read using pgm_read_byte() otherwise bind wasn't working. Need to implement model match currently everything is model 0. Also need to allow throttle position th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
    [pulses.cpp]
2012-01-09 Visual C++ compilation error
    [gruvin9x.cpp]
2012-01-09 DSM2 - Fail safe and model match working. Point of notes: 1) The Rx channel order needs to be TAER, certainly the throttle needs to be first for the failsafe to work. 2) The model number is really th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
    [pulses.cpp]
2012-01-13 Fixed binary representation of fuse values in fuses.txt.
    My bad. Must have been going to quick.
2012-01-23 Seems my last few commits never actually made it :-/ This commit contains all of those in one hit. Brief comments ...
    Makefiles: AVRDUDE calls now automatically use bit rate period of 0.25us (4MHz) for
    non-STD boards, since the ATmega2560/1 chips are happy at that speed. 'make wfuses'
    Make option added, which uses bitrate period of 8us (125KHz) regardless of board
    version.
    NZ BOM file: Just minor additions. Nothing of interest to most people, I'm
    sure.
    gPROG: Board via drill dia's reduced from default 0.6350mm (0.025in) to 0.5080mm
    (0.02in) except for three vias on the thicker +5V tracks. Production files added
    to repository.
    [gprog-Back.gbl, gprog-Front.gtl, gprog-Mask_Back.gbs, gprog-Mask_Front.gts, gprog-PCB_Edges.gbr, gprog-SilkS_Back.gbo, gprog-SilkS_Front.gto, gprog-SoldP_Back.gbp]
2012-01-23 Hmmm. Just in case I didn't save this file before committing last time.
    [gprog.brd]
2012-01-25 gPROG: Latest code for the current PCB. Alas, actual programming is not working. But at least the USB part is doing its thing now.
    The problem is most likely the buffer chip -- somehow. When I've had some
    sleep, I try bipassing it. In fact, my vote is to remove it entirely,
    since it's just not needed -- becasue the ATmega48/88 chips seem do a
    fine job of going high-Z when powered off, all by themselves.
    This version has fancy blinky LED status stuff going on, which came about
    mostly for debugging purposes.
    The USB 'Manufacturer' data has been change to gruvin9x.googlecode.com.
    [isp.c, main.c, usbasp.h, usbconfig.h]
2012-01-26 gPROG: Had to revert USB Manufacturer(Vendor) Name back so that AVRDUDE will recognise us as a USBasp
    PCB -- added a big, fat "+" symbol to pin 1 of the USB pin header.
    [gprog.brd, gprog.sch]
2012-01-26 gprog: Changed P3/ISP pad holes to 0.5080mm (0.02" -- was 0.025")
    [gprog.brd]
2012-01-26 gprog: Added delay after bufferOn/Off() calls to allow logic levels to settle. Seems to have improved short read operations, but still no joy with flash programming.
    [main.c]
2012-01-27 Makefile(trunk): Build options were in the wrong place -- comming after "PCB=STD only past here" position.
    There's also some kind of bug come back in main_views.cpp. The FrSky
    HUB data isn't being displayed at all now (even with the make option
    set to YES) and the second data page (log file path when NO DATA)
    is showing the main screen stuff as well, when it shouldn't be.
    Created Issue 93 and assigned to Bertrand. Thanks.
2012-01-29 gprog schematic, PCB & firmware updated to v1.2 -- final release candidate 2
    This is the version with the fixes to the moumental screw-ups made
    by myself, as discovered 2012-01-29. This should now be the final
    prodcution version.
    [gprog.brd, gprog.sch]
2012-01-30 grpog v1.2 frozen for production
    Last minute changes to tidy up some track positions -- and reduce
    most vias to 0.8mm dia. / 0.4mm drill. Is this finally perfection? :/
    [gprog-Back.gbl, gprog-Front.gtl, gprog-Mask_Back.gbs, gprog-Mask_Front.gts, gprog-PCB_Edges.gbr, gprog-SilkS_Back.gbo, gprog-SilkS_Front.gto, gprog-SoldP_Back.gbp]
2012-01-30 Issue 93 solved. Redundant code from simu removed.
    [main_views.cpp, simpgmspace.cpp, simu.cpp]
2012-01-31 gprog BOM updated to v1.2 design version
    Changes include ...
    MCU upgraded from ATmega48P to ATmega88P (NZ element14)
    Buffer chip changed from 74HC125 to 74HC126 (NZ element14 & USA DigiKey)
    Manufacturer/Part No.s added (NZ element14
    Prices and MOQs checked (NZ element14)
    [gprog_v1-0_bom.xls, gprog_v1-2_BOM.xls]
2012-01-31 gprog: Added screw and stand-off tube to BOM
    [gprog_v1-2_BOM.xls]
2012-02-01 Issue 93 still in progress Fixed [MENU LONG] for MaxV field after User Data moved to top of list by bsongis.
    [model_menus.cpp]
2012-02-01 gprog: pre-production last(?) minute checks. Reduced some over-sized holes. Changed part value of MCU to ATMEGA88P (instead of '48P)
    [gprog.brd, gprog.sch]
2012-02-01 gprog: Updated production files.
    [gprog-Back.gbl, gprog-Front.gtl, gprog-Mask_Back.gbs, gprog-Mask_Front.gts, gprog-PCB_Edges.gbr, gprog-SilkS_Back.gbo, gprog-SilkS_Front.gto, gprog-SoldP_Back.gbp]
2012-02-01 v4.1 PCB [trunk] -- Cam: Please check my work. Had to move some tracks. PBS pad size/holes increased to 2.2 x 1.1mm to allow installation of switches without pin flattening/pliers/etc (factory). Vers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
    (These holes were always too small, requiring work with pliers to make
    the pins fit (snuggly!) I had not considered the problem this might
    be for a factory production team, because I frankly never believed
    we'd get that far. Go figure! :-)
    [gruvin9x.brd]
2012-02-05 Offset feature for baroAltimeter. Resetted during telemetry reset [EXIT LONG]
    [frsky.cpp, frsky.h, main_views.cpp]
2012-02-09 Finally getting around to working on the SD card logging system.
    I've made a number of changes to the telemtry display, as well as changing some
    logging related variable names and text to my personally preferred English
    variants.
    At present, enough has been done to prove that there is no apparent harm (lag
    etc) to PPM control when a log file is being written to once every
    perMain(). This is obviously pleasing. But further testing -- with longer log
    line and computation/string mannipulation and all that being done, instead of
    just writing a short line each time around.
    If anyone wants to test this for themselves, you just need to have your
    FAT16/32 formatted SD/MMC card installed and assign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
    [gruvin9x.cpp, gruvin9x.h, logs.cpp, main_views.cpp, myeeprom.h, pers.cpp]
2012-02-09 #include <logs.h> was called twice in the same file. I suppose that you wanted to remove the second. Now companion9x compiles and gruvin9x should not be broken. But it still misses the logs.h file!
    [gruvin9x.h]
2012-02-11 PROGMEM fix to support newer AVR-GCC versions, thanks to @mihlit.
    See Issue 90 Comment #9 (http://code.google.com/p/gruvin9x/issues/detail?id=90#c9)
    for full details.
    Following is a record of the patch application and the resulting (still) clean compile ...
    ----
    trunk$ patch -p0 < ~/Desktop/pgmfix.patch
    patching file firmware/src/lcd.cpp
    patching file firmware/src/simpgmspace.h
    patching file firmware/src/general_menus.cpp
    patching file firmware/src/menus.cpp
    patching file firmware/src/s9xsplashv4.lbm
    patching file firmware/src/lcd.h
    patching file firmware/src/font_dblsize.lbm
    patching file firmware/src/sticks.lbm
    patching file firmware/src/font.lbm
    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
    [diskio-test.cpp, drivers.cpp, general_menus.cpp, gruvin9x.cpp, gruvin9x.h, lcd.cpp, lcd.h, main_views.cpp]
2012-02-11 Fix for enabling companion9x build
    [templates.cpp]
2012-02-12 Just some typos and chronicle updates to a couple code comments.
2012-02-13 Rollback to previous version fixed in companion
    [templates.cpp]
2012-02-13 Somehow, pgmtypes.h got missed out of the PROGMEM fix commit.
    [pgmtypes.h]
2012-02-13 Minor changes (mostly comments).
    Change DSM2_Init to enable, not disable the RX data pin pull-up resistor.
    Never leave an input pin floating. Noise on such pins can cause the MCU to
    crash. I also have plans to use this as a digital input to activate
    range-check mode, using the button in my DSM2 module. More on that later.
    [frsky.cpp, pulses.cpp]
2012-02-14 Addresed the following error compiling SIMU
    gruvin9x.cpp:475:17: error: invalid suffix "b11000000" on integer constant
    Simu now compiles on my systems without error BUT, it doesn't seem to
    acknowledge any key-presses any more -- specifically the cursor keys
    for [UP] ... [EXIT] etc. :/ The line I change relates to keyboard input.
    But I cannot see how it would affect anything going on in Simu itself. If
    it does, well, it shouldn't, I guess. How to fix?
    - - - -
    Removed over 60 occuraences of CR (^M) at line ends in gruvin9x.cpp.
    Windows users PLEASE don't use editors that insert CR's at the end of lines.
    All source files are to have LF only. (If it looks right in Notepad --
    then it's W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
    [gruvin9x.cpp, logs.cpp]
2012-02-15 Correcting back to front SD card main connectors
    [sdcard-uk.brd, sdcard-uk.sch, sdcard.brd, sdcard.sch]
2012-02-15 Makefile.dist changed (again) to fix oversight by Gruvin is last change. Subversion revision reports can have M and/or S appended -- not only M. So now we simply accept any number (including zero) of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
    pulses.cpp ... nothing changed? Not sure why it's included here.
    [pulses.cpp]
2012-02-15 Main PCB version bumped to v4.2. Changes to pseudo RS-232 buffer circuit around Q2 and Q3.
    Changes (tested) have been made to imporve output waveform shapes at higher
    baudrates, such as that used for DSM2 (125,000 Baud.) This only affects the use
    of the pseudo RS-232 output, as opposed to the TTL output. This is desired when
    both Fr-Sky and DSM2 external plug-in modules are used and one doesn't want to
    have to modify the Fr-Sky module internally. In other words, both modules can
    be operated off the same (pseudo) RS-232 TX.RX port. (The DSM2 module requires
    an additional (preferably high-speed) transistor to re-invert and level shift
    serial data to 3.3V TTL. Gruvin got away with a carefully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
    [gruvin9x.brd, gruvin9x.sch]
2012-02-15 trunk PCB readme.txt copied from archivei (v4.1a) and updated v4.1 - v4.2. README (Unix 'standard') file created to point *nix readers to readme.txt.
    All future readme updates should be done here from now on -- assuming
    'frozen' can ever actually be taken literally (bit of an inside joke. :p
    But the intention is still sound!)
2012-02-15 Previous readme.txt file addition reverted after seeing how Cam had intended things to be -- one readme for each PCB. Good idea!
    Changes v4.1a to v4.2 updated in gruvin9x-readme.txt (plus minor
    re-format in header.)
2012-02-15 Rx MPX - Changed switch types (cheaper and better spec), moved fuses. Still want to add a couple of dip switches and an LED for user config options. Then it's done.
    [g9x_rx_mpx.brd, g9x_rx_mpx.sch]
2012-02-15 Comments moved from gruvin9x.brd file to gruvin9x-readme.txt
    [gruvin9x.brd]
2012-02-15 SD Card board file versioning was a mess. We had: UK Schematic = V3.3 UK Board = V4.0 NZ Schematic = V3.3 NZ Board = V3.5
    They are all now V4.1 to bring the production SD card boards in line with the production main board. A fresh clean start.
    [sdcard-uk.brd, sdcard-uk.sch, sdcard.brd, sdcard.sch]
2012-02-16 Rx MPX board - added LED and dip switches. LED needs attention, no 3D model. Also via search needs to occur.
    [g9x_rx_mpx.brd, g9x_rx_mpx.sch]
2012-02-16 Rx MPX Board - LED sorted Just a via check and then a beta PCB run.
    [g9x_rx_mpx.brd]
2012-02-16 trunk: SD card log file work. Now creates .CSV files instead of .TXT, so that MS-Excel will directly import, correctly.
    All Fr-Sky Hub data now included. I'm yet to change what data is logged based
    on (MODEL)TELEMETRY -- User Proto (None, Hub, WSHH.)
    Logging is still going flat out at 1 line every 100ms (I think?) Astonishingly,
    even with full log lines being assembled from real data and written to the
    SD card (even just using the cut-down f_printf FATfs function) I can not detect
    any glitching of servos on my bench top test gear. Wow.
    Very happy with this result.
    [logs.cpp]
2012-02-16 trunk: Main PCB - BOM file and readme updated to current v4.2 status.
    (Thanks for the reminder Cam. I'd forget to thingyjig, if it weren't screwed on!)
    This included normalising all resitor/capacitor/inductor part values to
    Japanese "5K1" format -- mainly so that the new (and much better!) KiCAD BOM
    output remains reational and easy to compare to our BOM spreadsheet.
    [gruvin9x-bom.xls, gruvin9x.sch]
2012-02-16 Rx MPX Board - Just a little shrink of the board dimensions to make sure we stay under the 2cmx2cm limit
    [g9x_rx_mpx.brd]
2012-02-16 Minor: Updated v4.2 board netlist, to bring in newly formatted part values.
    [gruvin9x.brd]
2012-02-17 Tx MPX Board - Very first draft, no where near complete. This board plugs into your Tx and controls the Rx de-multiplex board. It takes 8 pots or 8 switches. I have used an MPU instead of a I2C expan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
    [g9x_tx_mpx.brd, g9x_tx_mpx.sch]
2012-02-17 Tx MPX Board - Switch pot footprint update
2012-02-21 Stock re-ordering time for SD card boards. Created new production files to include the recent (minor) corrections. (Didn't want to create a whole new archive 'frozen' folder just for this. So left th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
    [sdcard-Back.gbl, sdcard-Front.gtl, sdcard-Mask_Back.gbs, sdcard-Mask_Front.gts, sdcard-PCB_Edges.gbr, sdcard-SilkS_Back.gbo, sdcard-SilkS_Front.gto, sdcard-SoldP_Back.gbp]
2012-02-23 Some simu bugs fixed
    [simpgmspace.cpp, simu.cpp]
2012-03-02 Rx MPX - Final changes, two regulator alternatives. Next step order them. Bed now, gerbers tomorrow !
    [g9x_rx_mpx.brd, g9x_rx_mpx.sch]
2012-03-15 Rx Mpx - Gerbers
    [g9x_rx_mpx-Back.gbl, g9x_rx_mpx-Front.gtl, g9x_rx_mpx-Mask_Back.gbs, g9x_rx_mpx-Mask_Front.gts, g9x_rx_mpx-PCB_Edges.gbr, g9x_rx_mpx-SilkS_Back.gbo, g9x_rx_mpx-SilkS_Front.gto, g9x_rx_mpx-SoldP_Back.gbp]
2012-03-26 Fix for compiling without DSM2
    [model_menus.cpp]
2012-03-26 Better fix for compiling without DSM2
    [model_menus.cpp]
2012-04-01 NZ element14.com BOM -- consolidation of JST-PH socket parts and pricing update (2012-04-02)
    Minor line split change to file.cpp to aid debugging.
    (SIMU isn't working any more. Can't figure out why. Asked Bertrand to
    take a closer look.)
2012-04-01 MAIN PCB v4.2 -- Changes to PORTH header.
    I have successfully changed the PORTH header from 8-pin to 10-pin and connected
    GND/VCC to the extra pins. I also rotated the module so that pin-1 is now on
    GND, rather than PH7.
    GND is on pad 1
    VCC is on pad 2
    PH0 to PH7 are on pads 3 through 10, respectively.
    [gruvin9x.brd, gruvin9x.sch]
2012-04-01 Hmmm ... "Save before exit?" ... I may have not saved the last changes to the v4.2 board before the previous commit. I really must get into the habit of closing work files before I commit, to prevent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
    [gruvin9x.brd]
2012-04-02 MAIN BOARD v4.2 CHANGES -- PORTH (continued)
    . Added C65 0u1 decoupling capactor for MCU pins 10 and 11.
    . Changed PORTH VCC supply source to get it away from the MCU supply.
    (Required less re-routing than expected. Always nice! :-D)
    . Tidied up a few multi-segment tracks I came across while I was at it.
    . Updated gruvin9x-readme.txt and gruvin9x-bom.xls to reflect the above.
    [gruvin9x-bom.xls, gruvin9x.brd, gruvin9x.sch]
2012-04-02 MAIN BOARD v4.2 CHANGES -- PORTH (continued.)
    Fixed orphanned GND via.
    [gruvin9x.brd]
2012-04-03 Removed bad code causing low bat alarm to not sound under 4.9V.
    Will now check brancehs/frsky for smae fault and raise a new issue if found.
    [gruvin9x.cpp]
2012-04-03 Bandgap and low batt alarm improvements ported work on same in branches/frsky. TEST=DEBUG option added to make directives to effect a -DDEBUG in CPPDEFs. (Couldn't use DEBUG= as it's used for other t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
    [gruvin9x.cpp, gruvin9x.h]
2012-04-03 MAIN BOARD v4.2 CHANGES (continued)
    . USB connector K6 flipped to make pin 1 GND
    PCB
    ===
    . PORTH 'hack pads' (P20) upgraded to 10-pin IDC header. Required significant re-working of components to the left to provide room.
    . 'Fat track thermal sink' issues address over the entire board (reduced track thickness to small part pads where practical.)
    . Several cases of 'ground looping' resolved. (Use single, common tie points instead of 'loops' whenever possible.)
    . A number of right-angle track bends resolved to 45-degrees. (Sharp corners can cause problems with copper etching.)
    . GND and VCC via drill size increased to 0.7mm and updated across the board, where practical. (Bound to have missed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
    [gruvin9x.brd, gruvin9x.sch]
2012-04-04 Corrections to make the board pass DRC and copper re-pour. Also D4 was missing a GND connection.
    [gruvin9x.brd]
2012-04-05 MAIN BOARD v4.2 (continued)
    Just added some vias for floating 'fill' areas, plus a couple super minor tidy-up things.
    This DRC thing is REALLY handy! Can't believe I never used it before. Saves so
    much manually fault hunting! Sheesh.
    [gruvin9x.brd]
2012-04-05 MAIN BOARD v4.2
    A few minor tweaks -- some ground plane vias fixed. No doubt still some minor
    issues to be found and rememedied.
    Right now, I'm now at all confident to run this new version straight to the
    factory. With the number of changes, the potential for an unseen error is just
    too great. So I need to push for a v4.2-frozen over the coming week and get
    some boards ordered, for a manual build.
    Yay \o/ :/ At least I'm better set up for it now, compared to in the past. Will
    still be agood 5 to 7 hours though. So tempting to just trust my work and go to
    production.
    Any votes the other way, anyone? We've actaully never had a board design fault
    in the past -- only schematic changes, which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
    [gruvin9x.brd]
2012-04-05 From Farnell, via Mr. Kaban ...
    ...
    Original Product
    Product Notification Reason NO LONGER STOCKED
    Farnell Order Code 1679975
    Product Description DIODE, ZENER, SOD-523, 3.6V
    Manufacturer/Brand Name ROHM
    Manufacturer Part No. EDZTE613.6B
    Purchase Order Number 57/01/2012 11:36
    Date of Your Last Order 10/01/2012
    Qty Ordered Last 6 Months 5
    Stock Availability 1545
    There is no suitable alternative for this product.
    ...
    "...no replacement...". Hmmm. Rubbish. They're being lazy is all. For now, I've just
    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
    [gruvin9x-bom.xls]
2012-04-13 Rx MPX board - The reason the PCB's hadn't arrived were the PCB house spotted some mistakes (then forgot to mention them).
    Some of the new through hole components for this board had no solder resist mask, the 3mm LED and the dip switches. The LED is a stock KiCAD library item to !
    [g9x_rx_mpx-Back.gbl, g9x_rx_mpx-Front.gtl, g9x_rx_mpx-Mask_Back.gbs, g9x_rx_mpx-Mask_Front.gts, g9x_rx_mpx-PCB_Edges.gbr, g9x_rx_mpx-SilkS_Back.gbo, g9x_rx_mpx-SilkS_Front.gto, g9x_rx_mpx-SoldP_Back.gbp]
2012-04-16 MAIN BOARD v4.2
    - Corrected NZ element14 BOM JST header/housing parts (v4.1a frozen)
    - Added NZ element14 BOM (v4.2 assembly)
    - Updated v4.2 board silk screen to read v4.2 (instead of v4.1)
    [V4_2 BOM-e14nz.xls, gruvin9x.brd]
2012-04-16 gProg BOM updates (minor corrections)
    [gprog_v1-2_BOM.xls]
2012-04-20 Added some code comments as a reminder and to keep others informed what is going on with the currently non-functional DSM2 module's range-check button.
2012-04-25 PCB v4.1a frozen: Updated/Corrected main XLS BOM
    PCM v4.2: Updated main XLS BOM to include note about recently found eBay seller with
    JST PH 2.0mm pre-wired connectors.
    [gruvin9x-bom.xls]
2012-05-13 Main PCB trunk updated to v4.2 frozen. (I made edits to silk screen directly in the frozen branch when preparing production files and forgot to copy it across earlier.)
    The change to the BOM file is probably just Excel recording the cursor position
    at last closure, as it does.
    [gruvin9x-bom.xls, gruvin9x.brd]
2012-05-17 Apparently, my previous commit of the v4.2 frozen folder did not complete successfully, but I didn't realise. :/ This is a recommit of that -- but with changes as follows ...
    . Added R118 in series with C63 to fix intermittent fault with soft-off
    circuitry. (Credit and thanks to x3mfly for this discovery and debug.)
    . Added the AGND 'component' to the gruvin.lib shared module library. It
    was missing for some reason, which was noticed when the net name for
    AGND didn't seem to exist in PCBNEW, which in turn caused some brief
    confusion when re-laying tracks for R118.
    . The above was all done in the so-called 'frozen' folder, s the changes
    were copied back to our current trunk/hardwa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
    [gruvin9x-bom.xls, gruvin9x.brd, gruvin9x.sch]
2012-05-18 Pad added to allow easier connection to C-of-Q9 for short-to-ground power-on at trainer jack, should it be required.
    Production files including updated BOM (for R118) still to come.
    [gruvin9x-bom.xls, gruvin9x.brd, gruvin9x.sch]
2012-05-26 The problem of simu blocked on Mac should be fixed now!
    [drivers.cpp, simpgmspace.cpp, simpgmspace.h]
2012-05-29 Fixed watch dog timer reset event's failure to reboot properly. (This remains a problem in the current 'stable' release and probably open9x as well.)
    The cause of the WDT reset fault turned out to be how the WDT is automatically
    reset to "active with minimum time period" when the reset occurs. This resulted
    in the WDT reset re-firing continuously, before we got around to setting it to
    500ms period. I guess the last time I tested this, there must have been not
    quite so many C variables begin cleared and what have you, so we snuck in under
    the time limit. (It was a long time ago.)
    Started soft-off implementation. It just powers off immediately at present. I
    haven't looked at how it was done i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
    [gruvin9x.cpp, gruvin9x.h]
2012-05-29 Soft-off fully implemented. Features include ...
    + Power switch indicator flags are debounced.
    + "MESSAGE -- Powering off ..." displays for 1.3s.
    + User can abort the power down by reconnecting/switching power
    (full WDT timer reset used to ensure full system initialisation).
    + Watchdog timer allows 2 seconds before giving up waiting for file
    closure, to ensure power goes off no matter.
    CAVEAT: EEPROM writes are not actually checked for completion. Rather, it is
    assumed that 1.3 seconds will always be long enough. I'd like to improve this
    -- because I know that copying large models for example can take longer -- but
    don't yet know ow to check for EEPROM write activity.
    BTW -- I did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
    [drivers.cpp, gruvin9x.cpp, gruvin9x.h, lcd.cpp]
2012-05-29 Soft off bug fixed. (Tiredness induced weirdo coding strikes again.)
    [gruvin9x.cpp]
2012-05-30 companion9x didn't compile any more
    [gruvin9x.cpp]
2012-05-30 Fr-Sky telemetry GPS screen changes. Large numbers for Altitude, Heading and Speed.
    I'm still very confused about the Fr-Sky data protocol. The "after decimal
    point" data for example is said to be sent as binary data -- but is it supposed
    to be considered as zero-padded or not?
    For example, is "9" supposed to be 0.9, 0.09 or 0.009?
    In the case of GPS speed for example, I assume two decimal places maximum
    (because it sends 99 when satellites are in range but a fix is not yet made). I
    guess "25" is supposed to be .25. But is "2" supposed to be .2 or .02?
    Alas, it seems my GPS unit is fried. I've received a new Fr-Sky hub, but I still
    get no data from the GPS unit. I haven't put the unit its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
    [main_views.cpp, model_menus.cpp]
2012-05-31 Started work on showing GPS distance from origin.
    Also ...
    + Fixed centering of "MESSAGE" on message screen. *shrug*
    + Changed centering and look of "1" in double size font.
    TODOs:
    + Test strange Fr-Sky dddmm.mmmm lat/long format to decimal degrees
    conversion (and compelte related code with origin, once available.)
    + Add "Reset origin" by pressing [MENU] (probably) on GPS screen. This
    will include GPS altitude at the same time. (Maybe it should also
    reset barometric sensor altitude. But that doesn't work at all right
    onmy system anyway. ("Bryan's satellite" still flies! :-/)
    + Add bearing calculation (compass bearing from origin to model's
    current GPS position. Not same as "hea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
    [frsky.cpp, frsky.h, gruvin9x.cpp, main_views.cpp]
2012-05-31 More work on GPS range, "dist" display. The math is all working. I just need to add the ability to set an origin point.
    Bearing (from origin) calulations not yet done. But that should be easy enough.
    + Added the Fr-Sky Hub prototocl document to the reference section
    + Amended (updated) a readme about the old scanned-matrix rewire for the
    v2.14 and v3.2 PCBs.
    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
2012-05-31 Fix to allow companion9x to compile and link
    [frsky.cpp, gruvin9x.cpp]
2012-06-12 RX MPX Board: 1st BOM Plus a change of the fuse footprint, can't get required voltage and current rating in the footprint I used, oops.
    [g9x_rx_mpx-bom.xls, g9x_rx_mpx.brd, g9x_rx_mpx.sch]
2012-07-16 wfuses (unix) avrdude script for ATmega2560 G9Xv4.x boards.
2012-07-19 RTC/SDCARD PCB layout ---------------------
    Changed position of X1 to allow use of much cheaper, barrel type crystal
    part -- or still the same SMD part. This equates to something like $3
    savings per board, since the SMD xtal is very expensive.
    Alas, I already have more than 50 of the old design PCBs in stock. The cost
    of junking those, added to the cost of ordering 50 replacmenets of the new
    design, means almost no actual savings benefit. Oh well. At least the change
    will eventually make for some savings -- $150 per 50 board batch seems worth
    the trouble.
    Was going to do the same for the UK version, but the existing layout would
    have needed more changing about than I had time or motiv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
    [sdcard-Back.gbl, sdcard-Front.gtl, sdcard-Mask_Back.gbs, sdcard-Mask_Front.gts, sdcard-PCB_Edges.gbr, sdcard-SilkS_Back.gbo, sdcard-SilkS_Front.gto, sdcard-SoldP_Back.gbp]
2012-07-19 RTC/SDCARD (NZ -- again)
    Added pad to solder xtal barrel to. Not quite the datasheet size, but close enough.
    [sdcard-Back.gbl, sdcard-Front.gtl, sdcard-Mask_Back.gbs, sdcard-Mask_Front.gts, sdcard-PCB_Edges.gbr, sdcard-SilkS_Back.gbo, sdcard-SilkS_Front.gto, sdcard-SoldP_Back.gbp]
2012-07-19 Oops. Ran DRC and fixed zone fill. Tired. Need sleep. No -- need food, then sleep! *sigh*
    [sdcard-Back.gbl, sdcard-Front.gtl, sdcard-Mask_Back.gbs, sdcard-Mask_Front.gts, sdcard-PCB_Edges.gbr, sdcard-SilkS_Back.gbo, sdcard-SilkS_Front.gto, sdcard-SoldP_Back.gbp]
2012-07-19 SDCARD v4.2 (again) + Added barrel xtalk and comment to BOM file. + Moved BOM file to assembly folder.
    [sdcard(uk+std)-bom.xls]
2012-08-15 SDCARD v4.2 Updates
    I'm preparing to get quotes from China to build the RTC/SD-card interface
    board -- hopefully much cheaper. Part of this required doing a proper job
    of the CMR200T barrel type xtal, so that part placement positioning data
    would be correct. Also tidied up the PCB design further. (There were some
    crazy, unneccesary vias done on my part previously -- confusion over what
    is and isn't in the way on the two layers.)
    I also consolidated file names and paths as well as splitting the sdcard
    BOM into two separate files, to be less confusing, hopefully.
    I'm going to get quotes for both the RTC/SD and gProg boards -- full
    assembly. Whether it works out ecconimical or sensible f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
    [gruvin9x-bom-ele14.xls, sdcard(uk+std)-bom.xls, sdcard-bom.xls, sdcard-uk-bom.xls, sdcard.brd, sdcard.sch]
2012-08-18 This should kinda work. I just have concerns about the pgm_read_byte_far calls in lcd.c (casting, etc.) Can't test it on an MCU from bed. :-/ Tomorrow! :-D (I mean, later today!)
2012-08-18 Compiler warning removed -- hopefully not broken. (Marked with XXX)
    [bootloader.c]
2012-08-19 Bootloader now exiting to main application correctly. NOW can I start testing the USB stuff? :P
    [bootloaderconfig.h, lcd.c, main.c]
2012-08-19 Bootloader -- some tidying and added support to exit to main program when [EXIT] pressed.
    usbconfig theoretically set up for our board.
    Now it's time to solder a USB connector on and see what happens.
2012-08-19 Some progress here ... but having problems with progmem access in usbdrv, I think.
    [bootloaderconfig.h, main.c, oddebug.c, oddebug.h, usbconfig-prototype.h, usbconfig.h, usbdrv.c, usbdrv.h]
2012-08-19 BOOTLOADER ready for prime time (I think)
    The bootloader finally works properly, having struggled half a day
    to figure out some bug in the V-USB USBaspBootloader original code,
    at least as far as larger than 64Kbyte Flash chips go. Yay \o/
    I've got the LCD display showing some status and current/last
    address, etc., which is kind of nice.
    So yeah ... so long as this bootloader is installed in the '2560 and
    protected, I no longer need the external gPro (USBasp) programmer. AND
    this one goes much faster. Cool.
    To use this thing, you just have to change the 0x11 fuse to 0x10 (to enable
    bootloader reset vector) then program the MCU with bootloader/main.hex.
    Now hold down [UP] and [DOWN] wh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
    [bootloaderconfig.h, lcd.c, lcd.h, main.c, usbportability.h]
2012-08-19 BOOTLOADER
    The display problem was due to not even setting the contrast ref
    voltage. Oops.
    Added contrast up/down and back=light toggle to user interface.
    I think it's finally ready. More testing over time first though, of course.
    [main.c]
2012-08-21 BOOTLOADER UPDATE
    Just a minior fix in usbdrv.c on th advice from the V-USB support forum,
    to fix a bug that I had earlier dodged in a different way.
    [usbdrv.c, usbportability.h]
2012-08-21 Newer version of sdcard(nz) version, used for quotation at KIVA, China.
    Main PCB edited to add bridges across pins 1 & 2 of J1 annd J4. See
    gruvin9x-readme.txt for more info.
    [gruvin9x.brd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]
2012-09-09 Fr-Sky / DSMX Caddy Board
    The intention here is to change from swapping TX modules on the back of the 9X
    to permanently installed Fr-Sky and DSMX modules, with two separate antennas
    mounted, one either side of the turret housing.
    @Cam -- any comments / suggestions / notes of error in design?
    [frsky_dsmx_caddy.sch]
2012-09-10 Fixed G9X v4.2 (trunk) 3D-setting for the six push button switches. *shrug*
    Started TX MOudle Caddy PCB layout.
    [frsky_dsmx_caddy.sch, gruvin9x.brd]
2012-09-10 TX Moudle Caddy PCB completed.
    Some missing files added.
    [frsky_dsmx_caddy-Back.gbl, frsky_dsmx_caddy-Front.gtl, frsky_dsmx_caddy-Mask_Back.gbs, frsky_dsmx_caddy-Mask_Front.gts, frsky_dsmx_caddy-PCB_Edges.gbr, frsky_dsmx_caddy-SilkS_Back.gbo, frsky_dsmx_caddy-SilkS_Front.gto, frsky_dsmx_caddy-SoldP_Back.gbp]
2012-09-10 Forgot the all-important silk screen title/version/url.
    [frsky_dsmx_caddy-Back.gbl, frsky_dsmx_caddy-Front.gtl, frsky_dsmx_caddy-Mask_Back.gbs, frsky_dsmx_caddy-Mask_Front.gts, frsky_dsmx_caddy-PCB_Edges.gbr, frsky_dsmx_caddy-SilkS_Back.gbo, frsky_dsmx_caddy-SilkS_Front.gto, frsky_dsmx_caddy-SoldP_Back.gbp]
2012-09-11 Freeze RTC/SD-card v4.2b (mainly)
    Removed P2 from component positions file, since it is in fact only intended
    to be drilled, blank pads for soldering wires to.
    Decided to bite the bullet and test VIKA, Chinese factory with a run of 50
    of these boards, fully assembled. (Version 4.2b frozen.)
    Hopefully they do all eventually sell (he said nervously.) If the quality is
    better than the previous supplier, then I will probably use them for any
    future main board and other project orders.
    (Not sure what the (no doubt very minor) changes to the gprog board are.)
    (Deleted a KiCAD .000 temp. file. Must add those to the ignore list.)
    [gprog.brd, gprog_v1-2_BOM.xls, sdcard.brd]
2012-09-12 Mainly gProg v4.2 updated ready for Chinese factory quoting. (Frozen.)
    Also added files on my local machine not in repository, that should be.
    [gprog-Back.gbl, gprog-Comments.gbr, gprog-Drawings.gbr, gprog-Front.gtl, gprog-Mask_Back.gbs, gprog-Mask_Front.gts, gprog-PCB_Edges.gbr, gprog-SilkS_Back.gbo]
2012-09-13 gprog: Removed a nuch of text from the back-side copper layer that got there GKH.
    Added *.bck, *.bak, *.lst, *.map and *.000 to my local svn global-ignores.
    Not sure what effect this will have on the repository, thogh I would assume,
    'none'. We shall see.
    [gprog-Back.gbl, gprog-Comments.gbr, gprog-Drawings.gbr, gprog-Front.gtl, gprog-Mask_Back.gbs, gprog-Mask_Front.gts, gprog-PCB_Edges.gbr, gprog-SilkS_Back.gbo]
2012-09-13 GPROG (again): This time, v4.2 really _is_ frozen. (Though I dare not promise! :P)
    Amazing waht Gerbview will show up during final, final checks.
    [gprog-Back.gbl, gprog-Comments.gbr, gprog-Drawings.gbr, gprog-Front.gtl, gprog-Mask_Back.gbs, gprog-Mask_Front.gts, gprog-PCB_Edges.gbr, gprog-SilkS_Back.gbo]
2012-09-16 ================================ = Differences V4.1a to V4.2b/c = ================================
    -- Gruvin --
    . Added tracks to links pins 1 & 2 on both J1 and J4. In the unlikely event
    anyone ever wants the opposite option for either jumper, they can break the
    track. This will save time as well as the slightly unsightly solder-blob
    bridges I've been doing on all the retail boards to date.
    . v4.2c -- changed solder mask clearance to 0.0000, having been advised to
    let the factory use their own process-ideal clearances. This will mostly
    help for the 0.5mm pitch MCU and LCD socket parts.
    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
    [gruvin9x.brd, gruvin9x.sch]
2012-09-17 Forgot to add the live copy files
    [gprog-kbt-Back.gbl, gprog-kbt-Comments.gbr, gprog-kbt-Drawings.gbr, gprog-kbt-Front.gtl, gprog-kbt-Mask_Back.gbs, gprog-kbt-Mask_Front.gts, gprog-kbt-PCB_Edges.gbr, gprog-kbt-SilkS_Back.gbo]
2012-09-17 DigiKey notifed obsolete part used in our BOM.
    NJM78L05UA-ND IC REG LDO 5V .1A SOT-89 NJR
    ... now replaced with ...
    296-13531-1-ND IC REG LDO 5V .1A SOT-89 TEXAS INSTRUMENTS
    [gruvin9x-bom.xls]
2012-09-24 Some Wings 3D crfeated packages added for cute 3D display.
    What can I say? I felt like trying to learn some more Wings.
    Damn tricky program to get your head around, though others
    makes it look easy, in tutorials. :-D
    [gprog-kbt.brd, gprog.brd, gruvin9x.brd]
2012-09-24 Added new SMD LEDs to packages3D. Getting better at this Wings thing.
    Interestingly, the KiCAD 3D Viewer messes up with the transparency of the LED
    'windows'. I ran a POV-ray trace on the same model and it was fine. *shrug* I
    wish KiCAD had a way to export the 3D view data back to .wrl or even .wings
    format. Ah well.
    [gprog-kbt.brd, gprog.brd]
2012-09-24 Might have forgot to save before sommit. Doh.
    [gprog-kbt.brd]
2012-09-26 Mostly TX caddy work. This version is larger and facilitates mounting the DSMX module such that it lays over top of the caddy board, rather than floating off the end. This will use up less space. I a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
    There was also an error (missing track) in the v1.0 prototype. I
    decided not to bother building the circuit yet and will instead
    wait for the v1.1 boards to arrive. Fingers crossed for luck.
    I considered adding a little more circuitry to allow controlling
    the Fr-Sky 'togle switch' options, namely F/W Upgrade, One-way and
    Two-way modes. Probably shoul dhave done this now, rather than
    later ... but I just didn't.
    Added a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
    [frsky_dsmx_caddy-Back.gbl, frsky_dsmx_caddy-Drawings.gbr, frsky_dsmx_caddy-Front.gtl, frsky_dsmx_caddy-Mask_Back.gbs, frsky_dsmx_caddy-Mask_Front.gts, frsky_dsmx_caddy-PCB_Edges.gbr, frsky_dsmx_caddy-SilkS_Back.gbo, frsky_dsmx_caddy-SilkS_Front.gto]
2012-09-26 TX Caddy changes (mostly).
    The ITead shopping cart wasn't working when I went to order the previous
    version of the TX Caddy board. I took that as an omen and proceeded to add the
    feature to allow firmware controlled switching between 1-Way and 2-Way mode on
    the Fr-Sky DHT DIY module, after all. (Not sure where to connect that to on
    the main board yet, though.)
    Added a PIN_ARRAY_7X1 module for the gruin library.
    Apparently, I also changed the new Wings 3D LED parts since they
    were last committed.
    [frsky_dsmx_caddy-Back.gbl, frsky_dsmx_caddy-Drawings.gbr, frsky_dsmx_caddy-Front.gtl, frsky_dsmx_caddy-Mask_Back.gbs, frsky_dsmx_caddy-Mask_Front.gts, frsky_dsmx_caddy-PCB_Edges.gbr, frsky_dsmx_caddy-SilkS_Back.gbo, frsky_dsmx_caddy-SilkS_Front.gto]
2012-09-26 TX Caddy. Dang-it, I *might* not have saved the very last change to the board before last commit. I MUST stop doing that! :-/
    [frsky_dsmx_caddy.brd]
2012-09-26 Minor perfectionism tweak to Wings glass diodes, having learned a little more. :-P
2012-09-27 Carzy 3D part upgrade. Or ... what Bryan gets up to on his birthday! (42, fwiw)
    [gprog-kbt.brd, gprog.brd]
2012-10-24 TX_caddy design fault corrected (and tested.)
    [frsky_dsmx_caddy.brd, frsky_dsmx_caddy.sch, gruvin9x-bom.xls]
2012-10-24 TX_CADDY changes to v1.4.
    Essentially, this project is a right, royal FAILURE at this time. However,
    the circuitry as presented in this commit _appears_ to function correctly
    electrically, I have been unable to get the only available DSMX module
    to operate. I am unwillingly to break my working DSM2 module in order
    to test that it works -- though I presume it would, if the CRO readings
    are to be believed.
    [frsky_dsmx_caddy.brd, frsky_dsmx_caddy.sch]
2012-10-26 TX_CADDY (the saga continues)
    The comedy of oversights, stuff-ups and general failures to get a rediculously
    simple circuit to work properly continues. This time we introduce a 5V reg
    that can actually handle the task reliably. :-/
    [frsky_dsmx_caddy.brd, frsky_dsmx_caddy.sch]
2012-10-29 TX Cadddy: A return to sanity re the 5V reg.
    [frsky_dsmx_caddy.brd]
2012-10-29 TX Caddy: Made start on BOM.
    [frsky_dsmx_caddy-bom-ele14.xls]
2012-10-31 Reference doc for SOT-223 500mA 78M05 regulator used on TX caddy.
    [frsky_dsmx_caddy-bom-ele14.xls, frsky_dsmx_caddy.brd, frsky_dsmx_caddy.sch]
2012-12-04 Bootloader update to stop haptic motor running and to stop SOMO audio module saying the wrong phrase at transition from bootloader to main program.
    [bootloaderconfig.h]
2013-07-10 Various updates that should have ben committed ages ago, including some updated KiCAD file versions
    [frsky_dsmx_caddy.brd, frsky_dsmx_caddy.sch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]
2013-08-05 Long overdue and now most likely pointless corrections to JST modules and 3D files.
    (I was designing yet another board using JST sockets and finally got sick
    of them being all out of whack! :-P)
    [gruvin9x.brd]
2014-02-05 Added board dimensions. Added a bunch of other support files that appear not to have been added previously. Oops. *shrug*
    Cam! How'z life? We've moved to Wellington, about 430KMs south of Auckland, where we were before. (Keen to see if you spy this note. hehe ;-)
    [gruvin9x-bom-cn.xls, gruvin9x-bom.csv, gruvin9x.brd]
2014-03-03 Found decent looking US$0.17ea 30-lead ZIF for LCD at http://www.buydisplay.com/default/30-pins-0-5mm-pitch-top-contact-zif-connector-fpc-connector.html I <3 China :-D
    [gruvin9x-bom-ele14.xls]
2014-11-26 Added a Gerber file zip with just files needed for people to order boards from ITead Studio or elswhere. This file is linked on the gruvin9x.com home page.
