sylvandb/gruvin9x/(notices)

Notices in the files:
firmware/src/diskio.cpp:
This program is free software; you can redistribute it and/or modify
it under the terms of the GNU General Public License version 2 as
published by the Free Software Foundation.
firmware/src/logs.cpp:
under the terms of the GNU General Public License version 2 as published
hardware/pcb/gruvin9x.sch:
Copyright 2011 C.Weeks
Licensed under the TAPR Open Hardware License (see file, LICENSE)
hardware/pcb/g9x_rx_mpx.brd:
Copyright 2011 th9xer
hardware/pcb/g9x_tx_mpx.sch:
Copyright 2012 C.Weeks
hardware/pcb/frsky_dsmx_caddy.sch:
Copyright 2012 B.Rentoul
hardware/pcb/g9x_tx_mpx.brd:
Copyright 2012 th9xer
